ibitlab/pub-shadow-lamp-pierrot/init.md

Step Init:
Треба створити проєкт в OpenSCAD для тіньової лампи з персонажем initial.jpg.
Це має бути «як коробочка», з ліхтарем посередині, на певній висоті.
Світло від ліхтаря має світити в усі боки, крім верху.
«Коробочка» має мати контур його обличчя (біла зона в центрі малюнка) і також включати підмальовані очі.
Згори лампочку й коробку ми закриємо якраз цією зоною обличчя: коли лампочка не світить, ми згори бачимо це обличчя.
Коли лампочка вмикається, вона просвічує крізь фігурні форми в стінках «коробочки» і робить на столі тінь, яка зображатиме всю решту персонажа світлом і тінню.

Відстань між зіницями — 10 см, це для масштабу.

Контур має бути чорною лінією однакової товщини, а тіні очей мають бути на кришці аж до волосся (ліворуч і праворуч).

Step 2:
Чи можемо ми зробити лампу якомога нижчою?

Я переніс усе у версію versions/v001-initial,
створи нову.
