ibitlab/pub-shadow-lamp-pierrot/versions/v001-initial/generated/pierrot_data.scad

// Generated by tools/make_data.py from the drawing. Do not edit by hand;
// rerun the script instead (see README). Units: mm, origin under the LED.

PD_PUPIL_MM = 100;
PD_LAMP_HEIGHT = 150;   // LED height the cleanup was done for
PD_WALL = 2.4;
PD_BASE = 4;
PD_MIN_SOLID = 1.2;
PD_MIN_HOLE = 1;
PD_Z_TOP = 107.6;   // highest hole in the wall
PD_EXTENT = [-219.3,-268.7,224.2,231.6];   // lit area on the table
PD_PUPILS = [[-50.20,-6.61],[49.80,-6.22]];
PD_WIRE = [86.73,-56.44];   // outer wall point of the wire rib
PD_PINS = [[36.84,18.73],[-37.96,24.65],[-2.62,-48.37]];

PD_LID = [[59.98,82.31],[59.73,82.31],[58.98,83.06],[58.73,83.06],[58.23,83.56],[57.98,83.56],[56.98,84.31],[56.48,84.31],[55.73,84.81],[55.23,84.81],[54.98,85.06],[54.73,85.06],[54.48,85.31],[53.98,85.31],[53.23,85.81],[52.73,85.81],[52.48,86.06],[51.73,86.06],[51.23,86.56],[50.98,86.56],[50.73,86.81],[50.23,86.81],[49.23,87.56],[48.48,87.56],[47.23,88.56],[46.73,88.56],[45.73,89.31],[44.23,89.81],[43.73,90.31],[43.23,90.31],[41.98,91.06],[41.48,91.06],[40.98,91.56],[40.23,91.56],[39.73,92.06],[39.23,92.06],[38.98,92.31],[38.23,92.31],[37.73,92.81],[36.98,92.81],[36.48,93.31],[35.73,93.31],[35.48,93.56],[34.98,93.56],[34.73,93.81],[34.23,93.81],[33.98,94.06],[33.48,94.06],[33.23,94.31],[32.48,94.31],[31.98,94.81],[31.23,94.81],[30.98,95.06],[30.48,95.06],[30.23,95.31],[29.73,95.31],[29.48,95.56],[28.48,95.56],[28.23,95.81],[27.48,95.81],[27.23,96.06],[26.73,96.06],[26.48,96.31],[25.73,96.31],[25.48,96.56],[24.98,96.56],[24.73,96.81],[23.73,96.81],[23.48,97.06],[22.98,97.06],[22.73,97.31],[21.48,97.31],[21.23,97.56],[20.23,97.56],[19.98,97.81],[18.98,97.81],[18.73,98.06],[18.23,98.06],[17.98,98.31],[16.98,98.31],[16.73,98.56],[15.23,98.56],[14.98,98.81],[13.98,98.81],[13.73,99.06],[12.73,99.06],[12.48,99.31],[11.73,99.31],[11.48,99.56],[10.48,99.56],[10.23,99.81],[9.73,99.81],[8.98,100.31],[8.23,100.31],[7.98,100.56],[7.48,100.56],[6.73,101.06],[6.23,101.06],[5.48,101.56],[4.98,101.56],[4.73,101.81],[3.98,101.81],[3.73,102.06],[3.23,102.06],[2.98,102.31],[1.73,102.31],[1.48,102.56],[-0.52,102.56],[-0.77,102.31],[-2.27,102.31],[-2.52,102.06],[-3.02,102.06],[-3.27,101.81],[-4.02,101.81],[-4.27,101.56],[-4.77,101.56],[-5.02,101.31],[-5.77,101.31],[-6.02,101.06],[-6.52,101.06],[-6.77,100.81],[-7.52,100.81],[-7.77,100.56],[-8.77,100.56],[-9.02,100.31],[-10.02,100.31],[-10.27,100.06],[-11.27,100.06],[-11.52,99.81],[-13.02,99.81],[-13.27,99.56],[-14.77,99.56],[-15.02,99.31],[-16.52,99.31],[-16.77,99.06],[-17.77,99.06],[-18.02,98.81],[-18.77,98.81],[-19.02,98.56],[-20.02,98.56],[-20.27,98.31],[-20.77,98.31],[-21.02,98.06],[-22.27,98.06],[-22.52,97.81],[-23.02,97.81],[-23.27,97.56],[-23.77,97.56],[-24.02,97.31],[-24.77,97.31],[-25.02,97.06],[-25.52,97.06],[-25.77,96.81],[-26.27,96.81],[-26.52,96.56],[-27.27,96.56],[-27.77,96.06],[-28.52,96.06],[-28.77,95.81],[-30.02,95.56],[-30.77,95.06],[-31.27,95.06],[-32.02,94.56],[-32.52,94.56],[-33.27,94.06],[-33.77,94.06],[-34.52,93.56],[-35.02,93.56],[-35.52,93.06],[-36.27,93.06],[-36.77,92.56],[-37.27,92.56],[-38.52,91.81],[-39.02,91.81],[-39.52,91.31],[-40.02,91.31],[-40.27,91.06],[-41.02,90.81],[-41.52,90.31],[-42.02,90.31],[-43.02,89.56],[-43.52,89.56],[-44.52,88.81],[-44.77,88.81],[-45.52,88.31],[-46.02,88.31],[-47.27,87.31],[-47.52,87.31],[-47.77,87.06],[-48.27,87.06],[-48.77,86.56],[-49.02,86.56],[-49.27,86.31],[-49.77,86.31],[-50.77,85.56],[-51.27,85.56],[-51.52,85.31],[-52.27,85.31],[-52.52,85.06],[-53.02,85.06],[-53.27,84.81],[-54.02,84.81],[-54.27,84.56],[-54.77,84.56],[-55.02,84.31],[-55.77,84.31],[-56.02,84.06],[-56.52,84.06],[-57.27,83.56],[-58.02,83.56],[-58.52,83.06],[-58.77,83.06],[-59.27,82.56],[-59.52,82.56],[-60.02,82.06],[-60.27,82.06],[-61.02,81.31],[-61.02,81.06],[-61.77,80.56],[-61.77,80.31],[-62.27,79.81],[-62.27,79.56],[-63.02,78.56],[-63.02,78.06],[-63.77,76.81],[-63.77,76.06],[-64.52,75.06],[-64.52,74.31],[-65.02,73.56],[-65.02,72.81],[-65.27,72.56],[-65.27,72.06],[-65.52,71.81],[-65.52,71.06],[-65.77,70.81],[-65.77,70.06],[-66.02,69.81],[-66.02,69.06],[-66.27,68.81],[-66.27,68.06],[-66.52,67.81],[-66.52,67.31],[-66.77,67.06],[-66.77,66.31],[-67.02,66.06],[-67.02,64.81],[-67.27,64.56],[-67.27,63.81],[-67.52,63.56],[-67.52,62.56],[-67.77,62.31],[-67.77,61.06],[-68.02,60.81],[-68.02,59.81],[-68.27,59.56],[-68.27,57.81],[-68.52,57.56],[-68.52,56.06],[-68.77,55.81],[-68.77,53.81],[-69.02,53.56],[-69.02,44.06],[-68.77,43.81],[-68.77,41.81],[-68.52,41.56],[-68.52,40.56],[-68.27,40.31],[-68.27,39.06],[-68.02,38.81],[-68.02,37.81],[-67.77,37.56],[-67.77,37.06],[-67.52,36.81],[-67.52,36.06],[-67.27,35.81],[-67.27,35.31],[-67.02,35.06],[-67.02,34.31],[-66.77,34.06],[-66.77,33.56],[-66.52,33.31],[-66.52,32.56],[-66.02,31.81],[-66.02,31.31],[-65.52,30.56],[-65.52,30.06],[-64.77,28.81],[-64.77,28.31],[-64.52,28.06],[-64.27,27.31],[-63.77,26.81],[-63.52,26.06],[-63.02,25.56],[-63.02,25.06],[-62.77,24.81],[-62.52,24.06],[-62.02,23.56],[-62.02,23.06],[-61.27,21.81],[-61.27,21.06],[-61.02,20.81],[-61.02,20.06],[-61.27,19.81],[-61.27,19.31],[-61.52,19.06],[-61.52,18.81],[-62.52,17.81],[-62.77,17.81],[-64.77,16.06],[-65.27,16.06],[-67.02,14.31],[-67.27,14.31],[-67.52,14.06],[-67.52,13.81],[-68.77,12.56],[-68.77,12.31],[-70.52,10.31],[-70.52,9.81],[-71.77,8.31],[-71.77,7.81],[-72.52,6.81],[-72.52,6.31],[-73.02,5.56],[-73.02,5.06],[-73.27,4.81],[-73.27,4.06],[-73.52,3.81],[-73.52,3.31],[-73.77,3.06],[-73.77,2.31],[-74.02,2.06],[-74.02,1.06],[-74.27,0.81],[-74.27,-0.69],[-74.52,-0.94],[-74.52,-2.94],[-74.77,-3.19],[-74.77,-3.94],[-75.02,-4.19],[-75.02,-4.69],[-75.77,-5.44],[-75.77,-5.69],[-76.02,-5.94],[-76.27,-5.94],[-76.77,-6.44],[-77.02,-6.44],[-77.27,-6.69],[-77.52,-6.69],[-80.27,-8.19],[-80.77,-8.19],[-81.02,-8.44],[-81.52,-8.44],[-81.77,-8.69],[-82.27,-8.69],[-82.52,-8.94],[-83.02,-8.94],[-83.27,-9.19],[-83.77,-9.19],[-84.02,-9.44],[-84.52,-9.44],[-84.77,-9.69],[-85.27,-9.69],[-85.52,-9.94],[-86.27,-9.94],[-86.52,-10.19],[-87.02,-10.19],[-88.27,-10.94],[-88.77,-10.94],[-89.02,-11.19],[-89.77,-11.19],[-90.02,-11.44],[-90.52,-11.44],[-91.77,-12.19],[-92.27,-12.19],[-92.52,-12.44],[-93.27,-12.44],[-93.52,-12.69],[-94.02,-12.69],[-95.27,-13.44],[-96.52,-13.69],[-96.77,-13.94],[-98.02,-14.44],[-98.52,-14.94],[-99.27,-15.19],[-99.77,-15.69],[-101.52,-16.44],[-102.52,-17.44],[-102.77,-17.44],[-103.27,-17.94],[-103.52,-17.94],[-104.02,-18.44],[-104.02,-18.69],[-104.52,-19.19],[-104.52,-19.44],[-105.27,-20.19],[-105.27,-20.44],[-105.77,-21.19],[-105.77,-21.94],[-106.02,-22.19],[-106.02,-24.19],[-105.77,-24.44],[-105.77,-25.19],[-105.27,-25.69],[-105.27,-25.94],[-104.52,-26.94],[-104.27,-27.69],[-104.02,-27.94],[-103.77,-27.94],[-103.52,-28.19],[-103.52,-28.44],[-103.27,-28.69],[-103.02,-28.69],[-102.77,-28.94],[-102.77,-29.19],[-102.52,-29.44],[-102.27,-29.44],[-102.02,-29.69],[-102.02,-29.94],[-98.52,-33.44],[-98.27,-33.44],[-97.77,-34.19],[-97.52,-34.19],[-96.27,-35.44],[-96.02,-35.44],[-95.02,-36.44],[-94.77,-36.44],[-94.27,-37.19],[-93.52,-37.44],[-92.52,-38.44],[-91.77,-38.69],[-91.27,-39.19],[-91.02,-39.19],[-90.77,-39.44],[-89.52,-39.94],[-89.02,-40.44],[-87.27,-41.19],[-86.77,-41.94],[-86.52,-41.94],[-85.52,-42.69],[-85.27,-42.69],[-84.02,-44.19],[-84.02,-46.19],[-84.27,-46.44],[-84.27,-47.44],[-85.02,-48.44],[-85.02,-48.69],[-85.27,-48.94],[-85.27,-49.44],[-85.77,-50.19],[-85.77,-50.69],[-86.27,-51.44],[-86.27,-52.44],[-86.52,-52.69],[-86.52,-54.19],[-86.27,-54.44],[-86.27,-55.19],[-86.02,-55.44],[-86.02,-55.94],[-85.77,-56.19],[-85.77,-56.44],[-85.27,-56.94],[-85.27,-57.19],[-84.77,-57.69],[-84.77,-57.94],[-84.27,-58.44],[-84.27,-58.69],[-83.77,-59.19],[-83.77,-59.44],[-82.27,-61.44],[-81.77,-62.94],[-80.77,-64.19],[-80.77,-64.44],[-80.27,-65.19],[-80.27,-65.69],[-79.52,-66.69],[-79.52,-66.94],[-79.02,-67.69],[-79.02,-68.19],[-78.02,-69.69],[-78.02,-70.44],[-77.52,-70.94],[-77.52,-71.19],[-77.02,-71.94],[-77.02,-72.69],[-76.27,-73.69],[-76.27,-74.44],[-76.02,-74.69],[-75.77,-75.44],[-75.02,-76.44],[-75.02,-77.19],[-74.52,-77.69],[-74.27,-78.44],[-73.02,-79.69],[-73.02,-79.94],[-72.52,-80.44],[-72.27,-80.44],[-71.77,-80.94],[-71.02,-81.19],[-70.52,-81.69],[-70.27,-81.69],[-69.52,-82.19],[-68.27,-82.19],[-68.02,-82.44],[-66.52,-82.44],[-66.27,-82.69],[-63.77,-82.69],[-63.52,-82.94],[-61.77,-82.94],[-61.52,-83.19],[-59.77,-83.19],[-59.52,-83.44],[-58.77,-83.44],[-58.52,-83.69],[-57.27,-83.69],[-57.02,-83.94],[-56.02,-83.94],[-55.77,-84.19],[-54.02,-84.19],[-53.77,-84.44],[-53.02,-84.44],[-52.77,-84.19],[-51.27,-84.19],[-51.02,-83.94],[-50.02,-83.94],[-48.77,-83.19],[-48.27,-83.19],[-47.52,-82.69],[-46.27,-82.44],[-45.77,-81.94],[-45.52,-81.94],[-45.27,-81.69],[-45.02,-81.69],[-44.77,-81.44],[-44.52,-81.44],[-41.77,-79.94],[-41.27,-79.94],[-40.02,-79.19],[-39.52,-79.19],[-37.77,-78.19],[-37.02,-78.19],[-36.27,-77.69],[-35.52,-77.69],[-35.27,-77.44],[-34.27,-77.44],[-34.02,-77.19],[-33.02,-77.19],[-32.77,-76.94],[-27.52,-76.94],[-27.27,-77.19],[-26.52,-77.19],[-26.27,-77.44],[-25.52,-77.44],[-25.27,-77.69],[-24.02,-77.94],[-23.27,-78.44],[-22.77,-78.44],[-22.27,-78.94],[-21.77,-78.94],[-21.02,-79.69],[-20.77,-79.69],[-19.77,-80.44],[-19.52,-80.44],[-18.52,-81.44],[-18.27,-81.44],[-17.27,-82.44],[-17.02,-82.44],[-16.27,-83.44],[-16.02,-83.44],[-15.27,-84.19],[-15.02,-84.19],[-13.27,-85.69],[-13.02,-85.69],[-12.77,-85.94],[-12.27,-85.94],[-11.77,-86.44],[-11.27,-86.44],[-11.02,-86.69],[-10.52,-86.69],[-10.27,-86.94],[-9.27,-86.94],[-9.02,-87.19],[-8.27,-87.19],[-8.02,-87.44],[-7.02,-87.44],[-6.77,-87.69],[-5.52,-87.69],[-5.27,-87.94],[-4.52,-87.94],[-4.27,-88.19],[-3.02,-88.19],[-2.77,-88.44],[-0.52,-88.44],[-0.27,-88.69],[8.23,-88.69],[8.48,-88.44],[10.48,-88.44],[10.73,-88.19],[12.98,-88.19],[13.23,-87.94],[14.48,-87.94],[14.73,-87.69],[15.48,-87.69],[15.73,-87.44],[17.23,-87.44],[17.48,-87.19],[17.98,-87.19],[18.23,-86.94],[18.98,-86.94],[19.23,-86.69],[20.48,-86.44],[20.98,-85.94],[21.48,-85.94],[21.73,-85.69],[22.98,-85.19],[23.73,-84.44],[23.98,-84.44],[24.73,-83.69],[24.98,-83.69],[25.73,-82.94],[25.73,-82.69],[26.23,-82.19],[26.48,-82.19],[27.98,-80.44],[28.23,-80.44],[30.98,-77.94],[31.23,-77.94],[31.73,-77.44],[32.23,-77.44],[32.73,-76.94],[33.23,-76.94],[33.98,-76.44],[34.98,-76.44],[35.23,-76.19],[38.98,-76.19],[39.23,-76.44],[40.48,-76.44],[40.73,-76.69],[41.48,-76.69],[41.73,-76.94],[42.48,-76.94],[43.73,-77.69],[44.73,-77.69],[45.48,-78.19],[45.98,-78.19],[46.23,-78.44],[46.98,-78.69],[47.48,-79.19],[47.73,-79.19],[47.98,-79.44],[48.48,-79.44],[49.23,-79.94],[49.73,-79.94],[51.98,-81.19],[53.23,-81.44],[53.98,-81.94],[54.48,-81.94],[54.73,-82.19],[55.23,-82.19],[55.48,-82.44],[56.48,-82.44],[56.73,-82.69],[58.23,-82.69],[58.48,-82.94],[59.23,-82.94],[59.48,-82.69],[61.48,-82.69],[61.73,-82.44],[62.73,-82.44],[62.98,-82.19],[63.73,-82.19],[63.98,-81.94],[64.73,-81.94],[64.98,-81.69],[65.73,-81.69],[65.98,-81.44],[66.73,-81.44],[66.98,-81.19],[67.73,-81.19],[67.98,-80.94],[68.73,-80.94],[68.98,-80.69],[69.73,-80.69],[70.48,-80.19],[70.98,-80.19],[71.23,-79.94],[71.98,-79.69],[72.48,-79.19],[72.73,-79.19],[73.23,-78.69],[73.48,-78.69],[73.73,-78.44],[73.73,-78.19],[74.98,-76.94],[74.98,-76.69],[75.48,-76.19],[75.73,-75.44],[76.23,-74.94],[76.23,-74.69],[76.73,-73.94],[76.73,-73.44],[77.73,-71.69],[77.73,-71.19],[77.98,-70.94],[78.23,-70.19],[78.98,-69.19],[78.98,-68.44],[79.48,-67.94],[79.73,-67.19],[80.23,-66.69],[80.23,-66.19],[80.48,-65.94],[80.73,-65.19],[81.23,-64.69],[81.23,-64.44],[81.73,-63.94],[81.98,-63.19],[82.48,-62.69],[82.48,-62.44],[82.98,-61.94],[82.98,-61.69],[83.48,-61.19],[83.48,-60.94],[83.98,-60.44],[83.98,-60.19],[84.48,-59.69],[84.48,-59.44],[84.98,-58.94],[84.98,-58.69],[85.73,-57.94],[85.73,-57.69],[86.23,-57.19],[86.23,-56.94],[86.73,-56.44],[86.73,-56.19],[87.23,-55.69],[87.23,-55.44],[87.73,-54.69],[87.73,-53.69],[87.98,-53.44],[87.98,-52.69],[87.73,-52.44],[87.73,-51.44],[87.23,-50.69],[86.98,-49.44],[86.73,-49.19],[86.23,-47.94],[85.73,-47.44],[85.73,-46.94],[85.23,-46.19],[85.23,-45.19],[84.98,-44.94],[84.98,-43.69],[85.23,-43.44],[85.23,-43.19],[86.98,-41.44],[87.23,-41.44],[87.48,-41.19],[87.73,-41.19],[87.98,-40.94],[88.23,-40.94],[88.48,-40.69],[88.73,-40.69],[88.98,-40.44],[89.23,-40.44],[89.48,-40.19],[89.73,-40.19],[89.98,-39.94],[90.23,-39.94],[90.48,-39.69],[90.73,-39.69],[90.98,-39.44],[91.23,-39.44],[91.48,-39.19],[93.23,-38.44],[93.73,-37.94],[94.48,-37.69],[95.23,-36.94],[95.98,-36.69],[96.98,-35.69],[97.23,-35.69],[99.48,-33.69],[99.73,-33.69],[104.48,-28.94],[104.48,-28.69],[104.98,-28.19],[105.23,-27.44],[105.73,-26.94],[105.73,-26.69],[106.48,-25.44],[106.48,-24.44],[106.73,-24.19],[106.73,-23.69],[106.48,-23.44],[106.48,-22.69],[105.98,-21.94],[105.98,-21.44],[105.73,-21.19],[105.48,-20.44],[103.48,-18.44],[103.23,-18.44],[102.48,-17.69],[102.23,-17.69],[101.98,-17.44],[101.73,-17.44],[101.48,-17.19],[99.73,-16.44],[99.23,-15.94],[98.98,-15.94],[97.73,-15.19],[96.98,-15.19],[95.23,-14.19],[94.73,-14.19],[93.98,-13.69],[93.48,-13.69],[93.23,-13.44],[92.73,-13.44],[92.48,-13.19],[91.73,-13.19],[91.48,-12.94],[90.98,-12.94],[90.23,-12.44],[88.98,-12.19],[87.73,-11.44],[87.23,-11.44],[86.98,-11.19],[86.23,-11.19],[85.98,-10.94],[85.48,-10.94],[85.23,-10.69],[84.48,-10.69],[82.73,-9.69],[82.23,-9.69],[81.98,-9.44],[80.73,-9.19],[78.98,-8.19],[77.73,-7.94],[76.98,-7.19],[76.73,-7.19],[75.48,-5.94],[75.48,-5.69],[75.23,-5.44],[75.23,-4.19],[74.98,-3.94],[74.98,-0.44],[74.73,-0.19],[74.73,1.56],[74.48,1.81],[74.48,2.81],[74.23,3.06],[74.23,3.81],[73.98,4.06],[73.98,4.81],[73.73,5.06],[73.73,5.56],[73.48,5.81],[73.23,7.06],[72.73,7.56],[72.73,8.06],[71.98,9.06],[71.98,9.56],[71.23,10.31],[71.23,10.56],[69.98,12.06],[69.98,12.31],[67.98,14.31],[67.73,14.31],[66.48,15.56],[66.23,15.56],[64.73,16.81],[64.23,16.81],[62.73,18.06],[62.23,18.06],[60.98,19.56],[60.98,21.31],[61.23,21.56],[61.48,22.81],[61.98,23.56],[61.98,24.06],[62.48,24.56],[62.73,25.31],[63.23,25.81],[63.48,26.56],[63.98,27.06],[64.23,27.81],[64.98,28.81],[64.98,29.56],[65.48,30.06],[65.48,30.31],[65.73,30.56],[65.73,31.31],[66.23,31.81],[66.23,32.56],[66.48,32.81],[66.48,33.31],[66.98,34.06],[66.98,34.81],[67.23,35.06],[67.23,35.56],[67.48,35.81],[67.48,36.56],[67.73,36.81],[67.73,37.81],[67.98,38.06],[67.98,39.06],[68.23,39.31],[68.23,40.31],[68.48,40.56],[68.48,42.31],[68.73,42.56],[68.73,53.06],[68.48,53.31],[68.48,55.31],[68.23,55.56],[68.23,57.06],[67.98,57.31],[67.98,59.06],[67.73,59.31],[67.73,60.31],[67.48,60.56],[67.48,61.81],[67.23,62.06],[67.23,63.06],[66.98,63.31],[66.98,64.56],[66.73,64.81],[66.73,66.06],[66.48,66.31],[66.48,67.06],[66.23,67.31],[66.23,68.56],[65.98,68.81],[65.98,69.31],[65.73,69.56],[65.73,70.31],[65.48,70.56],[65.48,71.31],[65.23,71.56],[65.23,72.31],[64.98,72.56],[64.98,73.31],[64.48,74.06],[64.48,74.81],[63.98,75.56],[63.98,76.06],[63.23,77.31],[63.23,77.81],[62.98,78.06],[62.48,79.31],[61.98,79.81],[61.98,80.06],[61.48,80.56],[61.48,80.81],[61.23,81.06],[60.98,81.06]];

PD_INK_POINTS = [[-51.27,-0.19],[-51.52,-0.44],[-52.52,-0.69],[-53.27,-1.44],[-53.52,-1.44],[-54.02,-1.94],[-55.02,-3.94],[-55.02,-4.44],[-55.27,-4.69],[-55.27,-8.44],[-54.77,-9.19],[-54.77,-9.94],[-52.77,-12.44],[-52.27,-12.44],[-51.77,-12.94],[-51.27,-12.94],[-51.02,-13.19],[-49.02,-13.19],[-47.52,-12.44],[-46.27,-11.19],[-46.02,-10.44],[-45.52,-9.94],[-45.52,-9.19],[-45.02,-8.19],[-45.02,-5.19],[-45.52,-4.44],[-45.52,-3.69],[-46.02,-2.69],[-47.02,-1.44],[-47.27,-1.44],[-48.52,-0.44],[-49.27,-0.44],[-49.52,-0.19],[48.48,0.06],[47.98,-0.44],[47.48,-0.44],[45.73,-2.19],[45.73,-2.69],[45.23,-3.19],[45.23,-3.69],[44.98,-3.94],[44.98,-4.94],[44.73,-5.19],[44.73,-7.69],[44.98,-7.94],[44.98,-8.69],[45.23,-8.94],[45.23,-9.44],[45.73,-10.44],[47.23,-11.94],[47.48,-11.94],[47.98,-12.44],[48.73,-12.44],[48.98,-12.69],[50.73,-12.69],[52.73,-11.69],[54.23,-9.94],[54.23,-9.44],[54.73,-8.69],[54.73,-7.94],[54.98,-7.69],[54.98,-4.69],[54.73,-4.44],[54.73,-3.69],[54.23,-2.94],[54.23,-2.44],[52.23,-0.44],[51.23,0.06],[59.98,82.31],[59.73,82.31],[58.98,83.06],[58.73,83.06],[57.48,84.06],[56.48,84.31],[55.73,84.81],[55.23,84.81],[53.73,85.56],[53.48,85.31],[53.98,84.56],[53.48,84.06],[51.73,85.56],[51.48,85.56],[48.73,87.56],[47.98,87.81],[47.48,88.31],[46.23,88.81],[45.73,89.31],[44.73,89.56],[41.98,91.06],[40.73,91.31],[39.98,91.81],[39.48,91.81],[38.73,92.31],[38.23,92.31],[37.48,92.81],[36.98,92.81],[36.23,93.31],[34.73,93.56],[33.98,94.06],[32.48,94.31],[31.73,94.81],[30.98,94.81],[30.73,95.06],[29.23,95.31],[28.23,95.81],[27.48,95.81],[27.23,96.06],[26.48,96.06],[25.48,96.56],[24.48,96.56],[23.48,97.06],[22.48,97.06],[22.23,97.31],[21.48,97.31],[21.23,97.56],[19.98,97.56],[19.73,97.81],[18.98,97.81],[17.98,98.31],[15.98,98.31],[14.98,98.81],[12.98,98.81],[11.98,99.31],[9.73,99.31],[9.48,99.56],[5.98,99.56],[5.73,99.81],[5.73,100.56],[5.98,101.06],[5.48,101.56],[3.98,101.81],[2.98,102.31],[1.73,102.31],[1.48,102.56],[1.23,102.31],[1.23,101.56],[0.73,101.31],[0.48,101.56],[0.48,102.06],[-0.02,102.56],[-0.52,102.56],[-0.77,102.31],[-2.27,102.31],[-3.27,101.81],[-4.77,101.56],[-5.02,101.31],[-5.02,100.81],[-4.52,100.31],[-4.77,100.06],[-11.02,100.06],[-11.27,99.81],[-13.02,99.81],[-13.27,99.56],[-16.52,99.31],[-16.77,99.06],[-17.77,99.06],[-18.02,98.81],[-18.77,98.81],[-19.02,98.56],[-20.02,98.56],[-21.02,98.06],[-22.27,98.06],[-22.52,97.81],[-23.02,97.81],[-24.02,97.31],[-24.77,97.31],[-25.02,97.06],[-27.02,96.56],[-27.77,96.06],[-29.27,95.81],[-30.02,95.31],[-31.27,95.06],[-32.02,94.56],[-32.52,94.56],[-33.27,94.06],[-33.77,94.06],[-34.52,93.56],[-35.02,93.56],[-35.52,93.06],[-36.27,93.06],[-36.77,92.56],[-37.27,92.56],[-38.52,91.81],[-39.02,91.81],[-39.52,91.31],[-40.02,91.31],[-41.02,90.81],[-41.52,90.31],[-42.02,90.31],[-43.02,89.56],[-44.02,89.31],[-44.52,88.81],[-46.77,87.81],[-48.52,86.56],[-49.02,86.56],[-49.52,86.06],[-51.02,85.31],[-54.52,82.81],[-54.77,83.06],[-54.77,83.81],[-54.52,84.06],[-54.77,84.56],[-55.02,84.31],[-56.52,84.06],[-57.27,83.56],[-58.02,83.56],[-58.52,83.06],[-60.27,82.06],[-61.02,81.31],[-61.02,81.06],[-61.77,80.56],[-61.77,80.31],[-63.02,78.56],[-63.02,78.06],[-63.77,76.81],[-63.77,76.06],[-64.52,74.81],[-64.52,74.31],[-64.77,74.06],[-64.77,73.56],[-65.27,72.56],[-65.27,71.81],[-65.77,70.81],[-65.77,70.06],[-66.02,69.81],[-66.02,69.06],[-66.27,68.81],[-66.27,68.06],[-66.52,67.81],[-66.52,67.06],[-66.77,66.81],[-66.77,66.06],[-67.02,65.81],[-67.02,64.81],[-67.27,64.56],[-67.27,63.56],[-67.52,63.31],[-67.52,61.81],[-68.02,60.81],[-68.02,59.06],[-68.27,58.81],[-68.27,57.56],[-68.52,57.31],[-68.52,56.06],[-68.77,55.81],[-68.77,53.81],[-69.02,53.56],[-69.02,44.56],[-68.77,44.31],[-68.77,41.81],[-68.52,41.56],[-68.52,40.56],[-68.27,40.31],[-68.02,37.81],[-67.52,36.81],[-67.52,36.06],[-67.02,35.06],[-67.02,34.31],[-66.77,34.06],[-66.77,33.56],[-66.52,33.31],[-66.02,31.31],[-65.52,30.56],[-65.52,30.06],[-64.77,28.81],[-64.77,28.31],[-64.27,27.31],[-63.77,26.81],[-62.77,24.81],[-62.27,24.31],[-61.77,23.31],[-61.02,22.56],[-60.52,21.56],[-58.02,19.06],[-57.77,19.06],[-56.77,18.06],[-56.52,18.06],[-55.77,17.31],[-55.52,17.31],[-55.27,16.81],[-55.52,16.56],[-57.77,16.56],[-58.02,16.81],[-59.02,16.81],[-59.27,17.06],[-61.02,17.06],[-61.27,17.31],[-63.02,17.56],[-64.77,16.06],[-65.27,16.06],[-67.02,14.31],[-67.52,14.06],[-67.52,13.81],[-69.77,11.31],[-69.77,11.06],[-70.52,10.31],[-70.52,9.81],[-71.77,8.31],[-72.02,7.31],[-72.52,6.81],[-72.52,6.31],[-73.02,5.56],[-73.27,4.06],[-73.77,3.06],[-73.77,2.31],[-74.02,2.06],[-74.77,-3.94],[-75.02,-4.19],[-75.02,-4.69],[-76.02,-5.94],[-80.27,-8.19],[-80.77,-8.19],[-81.02,-8.44],[-81.52,-8.44],[-81.77,-8.69],[-82.27,-8.69],[-82.52,-8.94],[-83.02,-8.94],[-83.27,-9.19],[-83.77,-9.19],[-84.02,-9.44],[-84.52,-9.44],[-85.52,-9.94],[-87.02,-10.19],[-88.27,-10.94],[-89.77,-11.19],[-91.77,-12.19],[-94.02,-12.69],[-95.27,-13.44],[-96.52,-13.69],[-98.02,-14.44],[-99.77,-15.69],[-101.52,-16.44],[-102.52,-17.44],[-103.52,-17.94],[-104.02,-18.44],[-104.52,-19.44],[-105.27,-20.19],[-105.77,-21.19],[-105.77,-21.94],[-106.02,-22.19],[-106.02,-24.19],[-105.77,-24.44],[-105.77,-25.19],[-105.27,-25.69],[-104.52,-27.19],[-104.02,-27.44],[-102.02,-29.44],[-102.02,-29.69],[-99.77,-31.94],[-99.77,-32.19],[-98.52,-33.44],[-98.02,-33.69],[-97.77,-34.19],[-97.52,-34.19],[-96.27,-35.44],[-96.02,-35.44],[-95.02,-36.44],[-94.77,-36.44],[-94.27,-37.19],[-93.52,-37.44],[-92.52,-38.44],[-91.77,-38.69],[-91.27,-39.19],[-89.52,-39.94],[-89.02,-40.44],[-87.27,-41.19],[-86.77,-41.69],[-85.77,-42.19],[-85.27,-42.19],[-84.52,-42.69],[-83.77,-42.69],[-83.52,-42.94],[-83.02,-42.94],[-82.02,-43.44],[-81.27,-43.44],[-80.52,-43.94],[-78.77,-43.94],[-78.52,-44.19],[-78.02,-44.19],[-77.52,-44.69],[-77.52,-44.94],[-78.02,-45.44],[-78.27,-45.44],[-80.02,-46.94],[-80.77,-47.19],[-81.27,-47.69],[-83.77,-48.94],[-85.02,-49.19],[-85.52,-49.69],[-85.77,-50.69],[-86.27,-51.44],[-86.27,-52.44],[-86.52,-52.69],[-86.52,-54.19],[-86.27,-54.44],[-86.27,-55.19],[-85.02,-56.44],[-84.27,-57.94],[-83.77,-58.44],[-83.27,-59.69],[-82.77,-60.19],[-78.02,-69.69],[-77.52,-70.19],[-77.52,-70.69],[-76.77,-71.94],[-76.77,-72.69],[-76.27,-73.19],[-76.27,-73.69],[-75.77,-74.44],[-75.77,-75.19],[-75.02,-76.44],[-75.02,-77.19],[-74.52,-77.69],[-74.27,-78.44],[-72.52,-80.44],[-72.27,-80.44],[-71.77,-80.94],[-71.02,-81.19],[-70.52,-81.69],[-69.52,-82.19],[-66.52,-82.44],[-66.27,-82.69],[-63.77,-82.69],[-63.52,-82.94],[-61.77,-82.94],[-61.52,-83.19],[-59.77,-83.19],[-59.52,-83.44],[-58.77,-83.44],[-58.52,-83.69],[-57.27,-83.69],[-57.02,-83.94],[-56.02,-83.94],[-55.77,-84.19],[-54.02,-84.19],[-53.77,-84.44],[-53.02,-84.44],[-52.77,-84.19],[-51.27,-84.19],[-51.02,-83.94],[-50.02,-83.94],[-48.77,-83.19],[-48.27,-83.19],[-47.52,-82.69],[-47.02,-82.69],[-44.52,-80.69],[-44.02,-80.69],[-42.27,-79.44],[-41.77,-79.44],[-41.02,-78.94],[-40.52,-78.94],[-38.52,-77.94],[-37.02,-77.69],[-36.02,-77.19],[-35.02,-77.19],[-34.02,-76.69],[-31.02,-76.44],[-30.77,-76.19],[-29.02,-76.19],[-28.77,-76.44],[-26.27,-76.69],[-25.52,-77.19],[-24.77,-77.19],[-23.52,-77.94],[-23.02,-77.94],[-22.52,-78.44],[-22.02,-78.44],[-21.52,-78.94],[-20.77,-79.19],[-20.27,-79.69],[-19.27,-80.19],[-18.52,-80.94],[-18.27,-80.94],[-15.27,-84.19],[-15.02,-84.19],[-13.27,-85.69],[-12.27,-85.94],[-11.77,-86.44],[-11.27,-86.44],[-10.27,-86.94],[-9.27,-86.94],[-9.02,-87.19],[-8.77,-86.94],[-9.02,-86.44],[-8.77,-86.19],[-8.27,-86.19],[-7.27,-86.69],[-6.02,-87.69],[-4.52,-87.94],[-4.27,-88.19],[-3.02,-88.19],[-2.77,-88.44],[-0.52,-88.44],[-0.27,-88.69],[8.23,-88.69],[8.48,-88.44],[12.98,-88.19],[13.23,-87.94],[14.48,-87.94],[14.73,-87.69],[15.48,-87.69],[15.73,-87.44],[17.23,-87.44],[18.23,-86.94],[18.98,-86.94],[19.23,-86.69],[20.48,-86.44],[20.98,-85.94],[21.48,-85.94],[22.98,-85.19],[25.73,-82.94],[25.73,-82.69],[26.73,-81.69],[27.23,-80.69],[29.98,-77.94],[30.23,-77.94],[31.73,-76.69],[33.23,-75.94],[33.73,-75.94],[34.48,-75.44],[37.98,-75.44],[38.23,-75.69],[38.98,-75.69],[39.23,-75.94],[40.48,-75.94],[40.73,-76.19],[41.23,-76.19],[42.23,-76.69],[42.98,-76.69],[43.73,-77.19],[44.48,-77.19],[46.98,-78.44],[47.48,-78.44],[49.98,-79.69],[50.48,-80.19],[50.98,-80.19],[52.73,-81.44],[53.23,-81.44],[53.98,-81.94],[54.48,-81.94],[55.48,-82.44],[56.48,-82.44],[56.73,-82.69],[58.23,-82.69],[58.48,-82.94],[59.23,-82.94],[59.48,-82.69],[61.48,-82.69],[61.73,-82.44],[62.73,-82.44],[62.98,-82.19],[63.73,-82.19],[63.98,-81.94],[64.73,-81.94],[64.98,-81.69],[65.73,-81.69],[65.98,-81.44],[66.73,-81.44],[66.98,-81.19],[67.73,-81.19],[67.98,-80.94],[69.73,-80.69],[70.48,-80.19],[70.98,-80.19],[71.98,-79.69],[72.48,-79.19],[73.48,-78.69],[73.73,-78.19],[74.98,-76.94],[74.98,-76.69],[75.48,-76.19],[75.73,-75.44],[76.48,-74.44],[76.48,-73.94],[76.98,-73.19],[76.98,-72.44],[77.48,-71.94],[77.48,-71.44],[78.73,-69.19],[78.73,-68.69],[79.23,-68.19],[79.23,-67.69],[79.73,-67.19],[80.48,-65.44],[80.98,-64.94],[80.98,-64.44],[81.48,-63.94],[81.73,-63.19],[82.23,-62.69],[82.73,-61.44],[83.73,-60.19],[83.98,-59.44],[85.98,-57.19],[85.98,-56.94],[87.23,-55.69],[87.73,-54.69],[87.73,-53.69],[87.98,-53.44],[87.73,-51.44],[87.23,-50.69],[87.23,-50.19],[86.98,-49.94],[86.73,-48.94],[85.98,-48.19],[85.48,-48.19],[84.98,-47.69],[84.23,-47.69],[83.73,-47.19],[82.73,-46.94],[81.48,-45.94],[80.23,-45.44],[79.48,-44.69],[78.48,-44.19],[77.73,-43.19],[77.98,-42.94],[82.23,-42.69],[83.23,-42.19],[84.48,-42.19],[85.23,-41.69],[86.23,-41.69],[86.48,-41.44],[87.73,-41.19],[93.23,-38.44],[93.73,-37.94],[94.48,-37.69],[95.23,-36.94],[95.98,-36.69],[96.98,-35.69],[97.23,-35.69],[98.23,-34.69],[98.48,-34.69],[99.73,-33.44],[99.98,-33.44],[104.23,-29.19],[104.23,-28.94],[104.98,-28.19],[105.23,-27.44],[105.73,-26.94],[106.48,-25.44],[106.48,-24.44],[106.73,-24.19],[106.73,-23.69],[106.48,-23.44],[106.48,-22.69],[105.98,-21.94],[105.98,-21.44],[105.48,-20.44],[102.48,-17.69],[99.73,-16.44],[99.23,-15.94],[97.73,-15.19],[96.98,-15.19],[95.23,-14.19],[94.73,-14.19],[93.98,-13.69],[93.48,-13.69],[92.48,-13.19],[90.98,-12.94],[90.23,-12.44],[88.98,-12.19],[87.73,-11.44],[86.23,-11.19],[85.23,-10.69],[84.48,-10.69],[82.73,-9.69],[80.73,-9.19],[78.98,-8.19],[77.73,-7.94],[76.98,-7.19],[76.73,-7.19],[75.48,-5.94],[75.23,-5.44],[75.23,-4.19],[74.98,-3.94],[74.98,-0.44],[74.73,-0.19],[74.73,1.56],[74.48,1.81],[74.48,2.81],[74.23,3.06],[74.23,3.81],[73.98,4.06],[73.98,4.81],[73.73,5.06],[73.23,7.06],[72.73,7.56],[72.73,8.06],[71.98,9.06],[71.98,9.56],[71.23,10.31],[71.23,10.56],[69.98,12.06],[69.98,12.31],[66.48,15.56],[66.23,15.56],[64.73,16.81],[64.23,16.81],[63.23,17.56],[61.48,17.56],[61.23,17.31],[60.23,17.31],[59.98,17.06],[55.48,17.06],[55.23,17.31],[55.23,17.56],[55.73,18.06],[56.73,18.56],[57.98,19.81],[58.23,19.81],[60.48,22.06],[60.48,22.31],[61.73,23.56],[61.73,23.81],[63.23,25.81],[63.48,26.56],[63.98,27.06],[64.23,27.81],[64.73,28.31],[64.98,28.81],[64.98,29.56],[65.48,30.06],[65.73,30.56],[65.73,31.31],[66.23,31.81],[66.23,32.56],[66.98,34.06],[66.98,34.81],[67.48,35.81],[67.73,37.81],[67.98,38.06],[67.98,39.06],[68.23,39.31],[68.23,40.31],[68.48,40.56],[68.48,42.31],[68.73,42.56],[68.73,53.06],[68.48,53.31],[68.48,54.56],[68.23,54.81],[68.23,57.06],[67.98,57.31],[67.98,58.31],[67.73,58.56],[67.73,60.06],[67.48,60.31],[67.48,61.56],[67.23,61.81],[67.23,62.81],[66.98,63.06],[66.98,64.56],[66.73,64.81],[66.73,65.56],[66.48,65.81],[66.23,68.31],[65.98,68.56],[65.98,69.31],[65.73,69.56],[65.73,70.31],[65.48,70.56],[65.48,71.31],[65.23,71.56],[64.98,73.31],[64.48,74.06],[64.48,74.81],[63.23,77.31],[63.23,77.81],[62.48,79.31],[61.48,80.56],[61.48,80.81],[60.98,81.06],[-58.02,9.81],[-56.77,9.81],[-55.77,10.31],[-53.27,10.31],[-53.02,10.06],[-50.77,9.81],[-50.02,9.31],[-48.77,9.06],[-48.27,8.56],[-47.02,8.06],[-46.27,7.31],[-46.02,7.31],[-43.02,4.31],[-43.02,4.06],[-41.77,2.56],[-41.27,1.31],[-40.77,0.81],[-40.77,0.31],[-40.02,-0.69],[-40.02,-1.19],[-39.52,-1.94],[-39.52,-2.69],[-39.02,-3.69],[-39.02,-4.44],[-38.77,-4.69],[-38.77,-5.44],[-38.52,-5.69],[-38.52,-6.44],[-38.27,-6.69],[-38.27,-8.44],[-38.02,-8.69],[-38.02,-12.94],[-38.27,-13.19],[-38.27,-14.44],[-38.77,-15.19],[-38.77,-15.94],[-39.52,-16.94],[-39.52,-17.44],[-40.02,-17.94],[-40.52,-18.94],[-42.77,-20.94],[-45.77,-22.44],[-47.27,-22.69],[-48.02,-23.19],[-50.02,-23.19],[-50.27,-23.44],[-51.77,-23.44],[-52.02,-23.19],[-54.02,-23.19],[-54.77,-22.69],[-56.02,-22.44],[-56.52,-21.94],[-57.02,-21.94],[-58.52,-20.69],[-58.77,-20.69],[-61.77,-17.69],[-61.77,-17.44],[-62.52,-16.69],[-62.52,-16.44],[-63.52,-15.19],[-64.77,-12.69],[-64.77,-12.19],[-65.02,-11.94],[-65.02,-11.44],[-65.52,-10.44],[-65.52,-9.69],[-66.02,-8.69],[-66.02,-7.19],[-66.27,-6.94],[-66.27,-5.44],[-66.52,-5.19],[-66.52,-0.94],[-66.27,-0.69],[-66.27,0.06],[-66.02,0.31],[-66.02,1.56],[-65.77,1.81],[-65.52,3.06],[-64.77,4.56],[-63.77,5.81],[-63.77,6.06],[-62.52,7.31],[-62.27,7.31],[-61.52,8.06],[-61.27,8.06],[-60.02,9.06],[-59.52,9.06],[58.73,10.31],[59.23,9.81],[59.98,9.81],[60.48,9.31],[61.73,8.81],[62.48,8.06],[63.48,7.56],[65.48,5.06],[65.48,4.56],[66.48,2.56],[66.48,1.81],[66.73,1.56],[66.73,-0.19],[66.98,-0.44],[66.98,-4.69],[66.73,-4.94],[66.73,-7.19],[66.23,-8.19],[66.23,-9.19],[65.48,-10.69],[65.48,-11.44],[64.98,-12.19],[64.98,-12.69],[64.48,-13.19],[64.48,-13.69],[63.23,-15.44],[62.98,-16.19],[61.48,-17.94],[61.48,-18.19],[58.73,-20.69],[55.48,-22.44],[54.98,-22.44],[54.73,-22.69],[53.48,-22.69],[52.48,-23.19],[49.73,-23.19],[49.48,-22.94],[48.73,-22.94],[48.48,-22.69],[47.48,-22.69],[45.98,-21.94],[45.23,-21.94],[44.73,-21.44],[44.23,-21.44],[43.73,-20.94],[42.98,-20.69],[41.23,-19.19],[40.98,-19.19],[39.48,-17.44],[39.48,-17.19],[38.48,-15.94],[38.48,-15.19],[37.98,-14.69],[37.98,-13.69],[37.73,-13.44],[37.73,-11.94],[37.48,-11.69],[37.48,-8.94],[37.73,-8.69],[37.73,-6.94],[37.98,-6.69],[37.98,-5.44],[38.23,-5.19],[38.48,-3.44],[38.98,-2.69],[38.98,-1.94],[39.48,-1.19],[39.48,-0.69],[40.98,2.31],[41.48,2.81],[42.48,4.56],[45.23,7.31],[45.48,7.31],[46.23,8.06],[46.48,8.06],[47.48,9.06],[48.98,9.81],[49.48,9.81],[50.23,10.31],[51.23,10.31],[51.48,10.56],[52.23,10.56],[52.48,10.81],[55.98,10.81],[56.23,10.56],[57.23,10.56],[57.48,10.31],[53.73,77.56],[57.23,74.31],[57.23,74.06],[57.98,73.31],[58.48,72.31],[58.48,71.56],[58.98,70.81],[59.23,69.31],[59.73,68.31],[59.73,67.31],[60.23,66.31],[60.23,65.31],[60.73,64.31],[60.98,61.81],[61.48,60.81],[61.48,59.06],[61.73,58.81],[61.73,57.81],[61.98,57.56],[61.98,56.06],[62.23,55.81],[62.23,54.31],[62.48,54.06],[62.48,52.31],[62.73,52.06],[62.73,44.56],[62.48,44.31],[62.48,42.56],[62.23,42.31],[62.23,41.06],[61.98,40.81],[61.98,39.31],[61.48,38.31],[61.48,37.31],[60.98,36.31],[60.98,35.56],[60.23,34.06],[60.23,33.31],[59.73,32.81],[59.73,32.31],[59.23,31.56],[59.23,31.06],[58.48,29.56],[57.23,28.31],[54.73,28.06],[53.73,27.56],[52.73,27.56],[51.73,27.06],[50.98,27.06],[50.23,26.56],[49.73,26.56],[49.48,26.31],[47.48,25.81],[45.73,24.81],[44.48,24.56],[43.98,24.06],[43.48,24.06],[42.98,23.56],[42.48,23.56],[41.98,23.06],[40.73,22.56],[39.98,21.81],[39.48,21.81],[37.98,20.56],[37.73,20.56],[36.23,19.31],[35.98,19.31],[31.23,14.56],[31.23,14.31],[30.48,13.56],[30.48,13.31],[28.98,11.31],[28.73,10.56],[28.23,10.06],[27.48,8.31],[26.98,7.81],[26.98,7.31],[26.48,6.81],[26.48,6.31],[25.98,5.81],[25.98,5.31],[24.73,2.81],[24.73,2.31],[24.48,2.06],[23.98,0.06],[23.48,-0.69],[23.48,-1.44],[22.98,-2.19],[22.98,-3.19],[22.48,-3.94],[22.48,-4.94],[22.23,-5.19],[22.23,-5.69],[21.73,-6.69],[21.73,-8.19],[21.23,-9.19],[21.23,-10.44],[20.98,-10.69],[20.98,-11.44],[20.73,-11.69],[20.73,-13.19],[20.48,-13.44],[20.48,-14.94],[20.23,-15.19],[20.23,-16.19],[19.98,-16.44],[19.98,-22.69],[20.23,-22.94],[20.73,-24.94],[21.23,-25.44],[21.23,-25.69],[21.98,-26.44],[22.48,-26.44],[22.98,-26.94],[23.73,-26.94],[24.48,-27.44],[25.23,-27.44],[25.48,-27.69],[26.98,-27.69],[27.23,-27.94],[27.98,-27.94],[28.23,-28.19],[29.98,-28.19],[30.98,-28.69],[31.98,-28.69],[32.23,-28.94],[34.23,-29.19],[34.48,-29.44],[35.73,-29.44],[36.73,-29.94],[37.98,-29.94],[38.98,-30.44],[40.23,-30.44],[40.48,-30.69],[41.23,-30.69],[41.48,-30.94],[42.23,-30.94],[42.48,-31.19],[43.48,-31.19],[43.73,-31.44],[44.73,-31.44],[44.98,-31.69],[46.23,-31.69],[46.48,-31.94],[47.23,-31.94],[47.48,-32.19],[49.23,-32.19],[49.48,-32.44],[51.98,-32.69],[52.23,-32.94],[53.98,-32.94],[54.23,-33.19],[55.23,-33.19],[55.48,-33.44],[58.48,-33.44],[58.73,-33.69],[59.48,-33.69],[59.98,-33.94],[60.48,-34.94],[60.48,-36.44],[60.73,-36.69],[60.73,-42.44],[60.48,-42.69],[60.23,-47.19],[59.98,-47.44],[59.98,-48.19],[59.73,-48.44],[59.73,-49.94],[59.48,-50.19],[59.48,-50.94],[59.23,-51.19],[59.23,-52.44],[58.98,-52.69],[58.98,-53.69],[58.73,-53.94],[58.48,-55.94],[58.23,-56.19],[58.23,-56.69],[58.73,-57.19],[59.73,-56.69],[60.73,-55.69],[60.98,-55.69],[61.23,-55.19],[62.48,-53.94],[62.48,-53.69],[63.98,-51.69],[64.73,-50.19],[64.73,-49.69],[65.23,-49.19],[65.23,-48.69],[65.73,-47.94],[65.73,-47.44],[65.98,-47.19],[65.98,-46.69],[66.48,-45.69],[66.48,-44.94],[66.98,-44.19],[66.98,-43.44],[67.48,-42.44],[67.73,-40.69],[68.23,-39.69],[68.23,-38.69],[68.73,-37.94],[68.73,-36.94],[68.98,-36.69],[69.23,-34.44],[69.98,-33.69],[70.48,-33.69],[70.73,-33.44],[72.73,-33.44],[73.48,-32.94],[74.48,-32.94],[74.73,-32.69],[75.48,-32.69],[76.48,-32.19],[77.23,-32.19],[77.98,-31.69],[78.98,-31.69],[79.48,-31.19],[79.98,-31.19],[81.48,-30.44],[81.98,-30.44],[82.73,-29.94],[83.23,-29.94],[83.73,-29.44],[84.23,-29.44],[85.23,-28.69],[86.23,-28.19],[86.73,-28.19],[87.48,-27.44],[89.23,-26.44],[91.23,-24.69],[91.48,-24.69],[95.23,-20.69],[95.98,-20.69],[96.98,-21.69],[97.23,-21.69],[97.98,-22.44],[98.23,-22.44],[99.73,-23.69],[99.98,-23.69],[100.23,-23.94],[100.23,-24.69],[99.48,-25.44],[99.48,-25.69],[98.98,-25.94],[98.73,-26.44],[97.23,-27.94],[96.98,-27.94],[95.48,-29.44],[95.23,-29.44],[93.48,-30.94],[93.23,-30.94],[90.48,-32.94],[89.73,-33.19],[89.23,-33.69],[88.73,-33.69],[88.23,-34.19],[87.73,-34.19],[85.48,-35.44],[84.98,-35.44],[83.98,-35.94],[83.23,-35.94],[82.98,-36.19],[82.23,-36.19],[81.98,-36.44],[80.98,-36.44],[80.73,-36.69],[79.73,-36.69],[78.73,-37.19],[76.98,-37.19],[76.73,-37.44],[75.98,-37.44],[75.73,-37.69],[74.48,-37.69],[74.23,-37.94],[70.73,-38.19],[69.98,-38.94],[69.73,-39.69],[69.98,-39.94],[70.23,-41.44],[70.73,-41.94],[70.73,-42.44],[71.23,-42.94],[71.48,-43.69],[71.98,-44.19],[72.48,-45.19],[74.23,-46.94],[74.23,-47.19],[77.73,-50.19],[83.23,-52.94],[83.23,-53.19],[81.23,-55.19],[81.23,-55.44],[80.23,-56.44],[80.23,-56.69],[78.98,-57.94],[78.23,-59.44],[77.73,-59.94],[77.23,-61.19],[76.73,-61.69],[76.73,-62.19],[75.98,-63.19],[75.98,-63.69],[75.48,-64.19],[75.48,-64.69],[74.98,-65.19],[74.98,-65.69],[74.23,-66.94],[74.23,-67.44],[73.23,-69.44],[73.23,-69.94],[72.48,-71.44],[72.48,-71.94],[71.48,-72.94],[71.23,-72.69],[70.48,-72.69],[69.73,-72.19],[66.23,-72.19],[65.23,-72.69],[63.73,-72.94],[62.98,-73.44],[62.48,-73.44],[61.73,-73.94],[61.23,-73.94],[60.73,-74.44],[59.48,-74.69],[58.73,-75.19],[58.23,-75.19],[57.73,-75.69],[56.98,-75.69],[54.98,-76.69],[54.48,-76.69],[54.23,-76.94],[52.98,-76.94],[52.48,-76.44],[51.48,-76.19],[50.98,-75.69],[50.48,-75.69],[49.73,-75.19],[49.23,-75.19],[47.98,-74.44],[47.48,-74.44],[45.48,-73.44],[44.73,-73.44],[44.48,-73.19],[42.98,-72.94],[42.73,-72.69],[41.73,-72.69],[40.73,-72.19],[39.48,-72.19],[38.48,-71.69],[37.23,-71.69],[36.98,-71.44],[34.48,-71.44],[34.23,-71.69],[33.48,-71.69],[32.73,-72.19],[32.23,-72.19],[31.73,-72.69],[31.23,-72.69],[30.73,-73.19],[29.23,-73.94],[25.98,-76.69],[24.98,-76.94],[24.73,-77.19],[23.73,-77.19],[23.48,-77.44],[21.98,-77.44],[21.23,-77.94],[20.48,-77.94],[19.73,-78.44],[18.23,-78.69],[17.48,-79.19],[15.98,-79.19],[15.73,-79.44],[14.23,-79.69],[13.98,-79.94],[12.48,-79.94],[12.23,-80.19],[10.98,-80.19],[10.73,-80.44],[7.73,-80.44],[7.48,-80.69],[3.23,-80.69],[2.98,-80.94],[1.98,-80.94],[1.73,-80.69],[-2.02,-80.69],[-2.27,-80.44],[-5.52,-80.44],[-5.77,-80.19],[-7.27,-80.19],[-7.52,-79.94],[-8.52,-79.94],[-8.77,-79.69],[-10.27,-79.69],[-10.52,-79.44],[-11.27,-79.44],[-11.52,-79.19],[-12.77,-79.19],[-13.52,-78.69],[-14.27,-78.69],[-15.02,-78.19],[-15.52,-78.19],[-16.02,-77.69],[-21.02,-75.19],[-21.52,-75.19],[-23.77,-73.94],[-24.27,-73.94],[-25.52,-73.19],[-26.02,-73.19],[-26.27,-72.94],[-26.77,-72.94],[-27.02,-72.69],[-27.52,-72.69],[-28.52,-72.19],[-29.27,-72.19],[-30.02,-71.69],[-34.02,-71.69],[-35.02,-72.19],[-36.27,-72.19],[-37.02,-72.69],[-37.77,-72.69],[-38.52,-73.19],[-39.77,-73.44],[-40.52,-73.94],[-41.02,-73.94],[-43.52,-75.19],[-44.02,-75.69],[-46.52,-76.94],[-48.02,-78.19],[-48.52,-78.19],[-48.77,-78.44],[-49.52,-77.94],[-50.02,-77.94],[-50.52,-77.44],[-51.02,-77.44],[-51.77,-76.94],[-53.02,-76.69],[-53.77,-76.19],[-54.52,-76.19],[-55.52,-75.69],[-56.52,-75.69],[-57.27,-75.19],[-58.52,-75.19],[-59.77,-74.44],[-60.27,-74.44],[-61.02,-73.94],[-61.77,-73.94],[-62.77,-73.44],[-65.77,-73.44],[-66.02,-73.69],[-67.77,-73.94],[-70.27,-75.19],[-70.77,-75.19],[-71.27,-74.69],[-71.77,-73.69],[-72.02,-72.19],[-72.27,-71.94],[-72.52,-70.69],[-73.02,-69.94],[-73.02,-69.44],[-73.52,-68.69],[-73.52,-68.19],[-74.02,-67.44],[-74.02,-66.94],[-74.77,-65.94],[-74.77,-65.44],[-76.02,-62.94],[-76.52,-62.44],[-76.52,-61.94],[-77.52,-60.69],[-77.77,-59.94],[-78.27,-59.44],[-78.77,-58.44],[-80.02,-57.19],[-80.02,-56.94],[-80.77,-56.19],[-80.77,-55.94],[-82.27,-54.44],[-82.27,-53.94],[-81.77,-53.44],[-79.77,-52.69],[-77.27,-50.94],[-76.52,-50.69],[-75.52,-49.69],[-75.27,-49.69],[-71.77,-46.19],[-71.77,-45.94],[-70.27,-43.94],[-70.02,-42.94],[-69.52,-42.19],[-69.52,-41.19],[-69.27,-40.94],[-69.52,-39.69],[-70.77,-38.94],[-73.52,-38.94],[-73.77,-38.69],[-75.02,-38.69],[-75.27,-38.44],[-77.27,-38.44],[-77.52,-38.19],[-78.52,-38.19],[-79.52,-37.69],[-80.52,-37.69],[-81.27,-37.19],[-82.02,-37.19],[-82.52,-36.69],[-83.77,-36.44],[-86.77,-34.94],[-87.27,-34.44],[-87.52,-34.44],[-88.02,-33.94],[-89.77,-32.94],[-92.27,-30.69],[-92.52,-30.69],[-99.27,-23.94],[-99.52,-23.44],[-99.52,-22.69],[-99.02,-22.44],[-95.77,-19.44],[-94.77,-19.19],[-92.77,-21.69],[-92.77,-21.94],[-91.52,-23.19],[-91.52,-23.44],[-88.52,-26.44],[-88.27,-26.44],[-87.27,-27.44],[-86.52,-27.69],[-84.02,-29.44],[-83.52,-29.44],[-83.02,-29.94],[-82.02,-30.44],[-81.52,-30.44],[-81.02,-30.94],[-80.52,-30.94],[-79.27,-31.69],[-78.52,-31.69],[-77.77,-32.19],[-77.02,-32.19],[-76.77,-32.44],[-76.27,-32.44],[-75.27,-32.94],[-74.27,-32.94],[-73.27,-33.44],[-72.02,-33.44],[-71.02,-33.94],[-69.27,-33.94],[-68.52,-34.69],[-68.52,-35.19],[-68.02,-36.19],[-68.02,-37.44],[-67.52,-38.44],[-67.52,-39.69],[-67.27,-39.94],[-67.27,-40.44],[-67.02,-40.69],[-67.02,-41.19],[-66.77,-41.44],[-66.77,-41.94],[-66.27,-42.94],[-66.27,-43.69],[-65.77,-44.44],[-65.77,-45.19],[-64.52,-47.69],[-64.52,-48.19],[-64.02,-48.69],[-64.02,-49.19],[-63.52,-49.69],[-63.52,-50.19],[-63.02,-50.69],[-62.77,-51.69],[-62.27,-52.19],[-62.27,-52.69],[-61.77,-53.19],[-61.02,-54.69],[-61.02,-55.19],[-60.52,-55.94],[-60.52,-60.94],[-60.27,-61.19],[-60.02,-64.44],[-59.27,-65.94],[-59.27,-66.44],[-58.27,-68.19],[-56.77,-69.69],[-56.52,-69.69],[-55.77,-70.44],[-54.52,-70.94],[-54.02,-71.44],[-53.27,-71.44],[-52.27,-71.94],[-50.27,-71.94],[-49.77,-71.44],[-49.27,-71.44],[-48.02,-70.19],[-47.77,-69.69],[-47.77,-68.44],[-47.52,-68.19],[-47.52,-67.69],[-47.77,-67.44],[-47.77,-66.44],[-48.02,-66.19],[-48.02,-65.69],[-48.52,-64.69],[-49.02,-64.19],[-49.27,-63.44],[-50.27,-62.44],[-50.27,-62.19],[-55.77,-56.69],[-55.77,-56.44],[-56.77,-55.44],[-58.52,-51.94],[-58.52,-51.19],[-59.02,-50.19],[-59.02,-48.94],[-59.52,-47.94],[-59.77,-43.94],[-60.02,-43.69],[-60.02,-37.19],[-59.77,-36.94],[-59.77,-34.94],[-59.27,-34.44],[-58.77,-34.19],[-58.02,-34.19],[-57.77,-33.94],[-56.02,-33.94],[-55.02,-33.44],[-53.27,-33.44],[-53.02,-33.19],[-52.02,-33.19],[-51.77,-32.94],[-50.27,-32.94],[-50.02,-32.69],[-48.52,-32.69],[-48.27,-32.44],[-47.02,-32.44],[-46.77,-32.19],[-45.27,-32.19],[-45.02,-31.94],[-44.27,-31.94],[-44.02,-31.69],[-42.77,-31.69],[-42.52,-31.44],[-41.77,-31.44],[-41.52,-31.19],[-40.27,-31.19],[-40.02,-30.94],[-39.27,-30.94],[-39.02,-30.69],[-36.77,-30.44],[-35.77,-29.94],[-34.52,-29.94],[-33.77,-29.44],[-32.77,-29.44],[-32.52,-29.19],[-31.77,-29.19],[-31.52,-28.94],[-30.77,-28.94],[-30.52,-28.69],[-29.52,-28.69],[-28.52,-28.19],[-27.27,-28.19],[-26.27,-27.69],[-24.27,-27.44],[-23.52,-26.94],[-23.02,-26.94],[-22.02,-26.19],[-21.52,-25.19],[-21.27,-23.69],[-21.02,-23.44],[-21.02,-17.19],[-21.27,-16.94],[-21.27,-14.94],[-21.52,-14.69],[-21.77,-11.44],[-22.02,-11.19],[-22.02,-10.44],[-22.27,-10.19],[-22.27,-8.69],[-22.77,-7.69],[-22.77,-6.44],[-23.27,-5.44],[-23.27,-4.69],[-23.52,-4.44],[-23.52,-3.69],[-24.02,-2.69],[-24.02,-1.94],[-24.27,-1.69],[-24.27,-1.19],[-24.52,-0.94],[-24.52,-0.44],[-24.77,-0.19],[-24.77,0.31],[-25.02,0.56],[-25.02,1.06],[-25.27,1.31],[-25.77,3.31],[-26.27,4.06],[-26.27,4.56],[-26.77,5.06],[-27.02,6.31],[-27.52,6.81],[-27.52,7.31],[-28.02,7.81],[-28.02,8.31],[-28.77,9.81],[-29.77,11.06],[-30.52,12.56],[-31.27,13.31],[-31.27,13.56],[-32.02,14.31],[-32.02,14.56],[-35.02,17.81],[-35.27,17.81],[-36.77,19.31],[-37.77,19.81],[-39.27,21.06],[-40.02,21.31],[-40.52,21.81],[-41.02,21.81],[-42.27,22.81],[-47.27,25.31],[-47.77,25.31],[-49.77,26.31],[-51.27,26.56],[-52.02,27.06],[-52.77,27.06],[-53.77,27.56],[-54.77,27.56],[-55.02,27.81],[-55.77,27.81],[-56.02,28.06],[-57.52,28.06],[-57.77,28.31],[-58.77,28.31],[-59.52,29.31],[-60.77,31.81],[-60.77,32.56],[-61.27,33.31],[-61.52,35.06],[-62.02,36.06],[-62.02,37.31],[-62.27,37.56],[-62.27,38.31],[-62.52,38.56],[-62.52,43.06],[-62.27,43.31],[-62.27,44.31],[-62.02,44.56],[-62.02,46.31],[-61.77,46.56],[-61.77,47.56],[-61.52,47.81],[-61.27,50.06],[-60.77,51.06],[-60.77,52.31],[-60.27,53.31],[-60.27,54.81],[-60.77,55.31],[-61.02,55.31],[-62.77,53.31],[-63.27,53.81],[-63.27,55.31],[-63.02,55.56],[-63.02,57.06],[-62.77,57.31],[-62.77,58.06],[-62.52,58.31],[-62.52,60.06],[-62.27,60.31],[-62.27,61.06],[-62.02,61.31],[-62.02,63.06],[-61.77,63.31],[-61.77,64.06],[-61.52,64.31],[-61.52,65.06],[-61.27,65.31],[-61.27,66.31],[-60.77,67.31],[-60.77,68.56],[-60.27,69.31],[-60.27,70.31],[-60.02,70.56],[-60.02,71.06],[-59.52,72.06],[-59.52,72.81],[-58.52,74.81],[-52.52,79.06],[-50.02,80.31],[-49.27,81.06],[-48.77,81.06],[-48.27,81.56],[-47.02,82.06],[-45.27,83.31],[-44.77,83.31],[-43.02,84.56],[-40.27,85.81],[-39.77,86.31],[-39.27,86.31],[-38.77,86.81],[-35.27,88.56],[-34.77,88.56],[-34.27,89.06],[-33.77,89.06],[-33.27,89.56],[-32.77,89.56],[-31.52,90.31],[-31.02,90.31],[-30.52,90.81],[-29.77,90.81],[-27.27,92.06],[-26.52,92.06],[-25.77,92.56],[-25.27,92.56],[-25.02,92.81],[-24.52,92.81],[-23.52,93.31],[-22.77,93.31],[-22.02,93.81],[-21.27,93.81],[-20.27,94.31],[-19.27,94.31],[-19.02,94.56],[-18.27,94.56],[-18.02,94.81],[-17.27,94.81],[-17.02,95.06],[-14.02,95.31],[-13.77,95.56],[-2.02,95.56],[-1.77,95.31],[-1.27,95.31],[-1.02,95.06],[-0.02,94.81],[1.23,93.81],[2.23,93.81],[2.73,94.31],[2.73,94.56],[3.98,95.56],[5.23,95.56],[5.48,95.81],[7.48,95.81],[7.73,96.06],[8.73,96.06],[8.98,95.81],[11.98,95.81],[12.23,95.56],[14.23,95.56],[14.48,95.31],[15.23,95.31],[15.48,95.06],[17.23,95.06],[17.48,94.81],[18.98,94.56],[19.23,94.31],[20.23,94.31],[20.48,94.06],[21.23,94.06],[21.48,93.81],[22.48,93.81],[23.23,93.31],[23.98,93.31],[24.23,93.06],[24.73,93.06],[25.73,92.56],[26.48,92.56],[26.73,92.31],[27.98,92.06],[28.73,91.56],[29.48,91.56],[30.73,90.81],[31.23,90.81],[33.73,89.56],[34.23,89.56],[34.98,89.06],[35.48,89.06],[35.98,88.56],[36.48,88.56],[36.98,88.06],[37.48,88.06],[38.48,87.31],[38.98,87.31],[39.48,86.81],[40.73,86.31],[41.23,85.81],[41.98,85.56],[42.48,85.06],[43.73,84.56],[46.23,82.81],[46.98,82.56],[47.48,82.06],[48.48,81.56],[49.23,80.81],[50.23,80.31],[53.48,77.56]];
PD_INK_PATHS = [[0,1,2,3,4,5,6,7,8,9,10,11,12,13,14,15,16,17,18,19,20,21,22,23,24,25,26,27,28,29,30,31,32],[33,34,35,36,37,38,39,40,41,42,43,44,45,46,47,48,49,50,51,52,53,54,55,56,57,58,59,60,61,62,63,64,65,66,67],[68,69,70,71,72,73,74,75,76,77,78,79,80,81,82,83,84,85,86,87,88,89,90,91,92,93,94,95,96,97,98,99,100,101,102,103,104,105,106,107,108,109,110,111,112,113,114,115,116,117,118,119,120,121,122,123,124,125,126,127,128,129,130,131,132,133,134,135,136,137,138,139,140,141,142,143,144,145,146,147,148,149,150,151,152,153,154,155,156,157,158,159,160,161,162,163,164,165,166,167,168,169,170,171,172,173,174,175,176,177,178,179,180,181,182,183,184,185,186,187,188,189,190,191,192,193,194,195,196,197,198,199,200,201,202,203,204,205,206,207,208,209,210,211,212,213,214,215,216,217,218,219,220,221,222,223,224,225,226,227,228,229,230,231,232,233,234,235,236,237,238,239,240,241,242,243,244,245,246,247,248,249,250,251,252,253,254,255,256,257,258,259,260,261,262,263,264,265,266,267,268,269,270,271,272,273,274,275,276,277,278,279,280,281,282,283,284,285,286,287,288,289,290,291,292,293,294,295,296,297,298,299,300,301,302,303,304,305,306,307,308,309,310,311,312,313,314,315,316,317,318,319,320,321,322,323,324,325,326,327,328,329,330,331,332,333,334,335,336,337,338,339,340,341,342,343,344,345,346,347,348,349,350,351,352,353,354,355,356,357,358,359,360,361,362,363,364,365,366,367,368,369,370,371,372,373,374,375,376,377,378,379,380,381,382,383,384,385,386,387,388,389,390,391,392,393,394,395,396,397,398,399,400,401,402,403,404,405,406,407,408,409,410,411,412,413,414,415,416,417,418,419,420,421,422,423,424,425,426,427,428,429,430,431,432,433,434,435,436,437,438,439,440,441,442,443,444,445,446,447,448,449,450,451,452,453,454,455,456,457,458,459,460,461,462,463,464,465,466,467,468,469,470,471,472,473,474,475,476,477,478,479,480,481,482,483,484,485,486,487,488,489,490,491,492,493,494,495,496,497,498,499,500,501,502,503,504,505,506,507,508,509,510,511,512,513,514,515,516,517,518,519,520,521,522,523,524,525,526,527,528,529,530,531,532,533,534,535,536,537,538,539,540,541,542,543,544,545,546,547,548,549,550,551,552,553,554,555,556,557,558,559,560,561,562,563,564,565,566,567,568,569,570,571,572,573,574,575,576,577,578,579,580,581,582,583,584,585,586,587,588,589,590,591,592,593,594,595,596,597,598,599,600,601,602,603,604,605,606,607,608,609,610,611,612,613,614,615,616,617,618,619,620,621,622,623,624,625,626,627,628,629,630,631,632,633,634,635,636,637,638,639,640,641,642,643,644,645,646,647,648,649,650,651,652,653,654,655,656,657,658,659,660,661,662,663,664,665,666,667,668,669,670,671,672,673,674,675,676,677,678,679,680,681,682,683,684,685,686,687,688,689,690,691,692,693,694,695,696,697,698,699,700,701,702,703,704,705,706,707,708,709,710,711,712,713,714,715,716,717,718,719,720,721,722,723,724,725,726,727,728,729,730,731,732,733,734,735,736,737,738,739,740,741,742,743,744,745,746,747,748,749,750,751,752,753,754,755,756,757,758,759,760,761,762,763,764,765,766,767,768,769,770,771],[772,773,774,775,776,777,778,779,780,781,782,783,784,785,786,787,788,789,790,791,792,793,794,795,796,797,798,799,800,801,802,803,804,805,806,807,808,809,810,811,812,813,814,815,816,817,818,819,820,821,822,823,824,825,826,827,828,829,830,831,832,833,834,835,836,837,838,839,840,841,842,843,844,845,846,847,848,849,850,851,852,853,854,855,856,857,858],[859,860,861,862,863,864,865,866,867,868,869,870,871,872,873,874,875,876,877,878,879,880,881,882,883,884,885,886,887,888,889,890,891,892,893,894,895,896,897,898,899,900,901,902,903,904,905,906,907,908,909,910,911,912,913,914,915,916,917,918,919,920,921,922,923,924,925,926,927,928,929,930,931,932,933,934,935,936,937,938,939,940,941,942,943,944,945],[946,947,948,949,950,951,952,953,954,955,956,957,958,959,960,961,962,963,964,965,966,967,968,969,970,971,972,973,974,975,976,977,978,979,980,981,982,983,984,985,986,987,988,989,990,991,992,993,994,995,996,997,998,999,1000,1001,1002,1003,1004,1005,1006,1007,1008,1009,1010,1011,1012,1013,1014,1015,1016,1017,1018,1019,1020,1021,1022,1023,1024,1025,1026,1027,1028,1029,1030,1031,1032,1033,1034,1035,1036,1037,1038,1039,1040,1041,1042,1043,1044,1045,1046,1047,1048,1049,1050,1051,1052,1053,1054,1055,1056,1057,1058,1059,1060,1061,1062,1063,1064,1065,1066,1067,1068,1069,1070,1071,1072,1073,1074,1075,1076,1077,1078,1079,1080,1081,1082,1083,1084,1085,1086,1087,1088,1089,1090,1091,1092,1093,1094,1095,1096,1097,1098,1099,1100,1101,1102,1103,1104,1105,1106,1107,1108,1109,1110,1111,1112,1113,1114,1115,1116,1117,1118,1119,1120,1121,1122,1123,1124,1125,1126,1127,1128,1129,1130,1131,1132,1133,1134,1135,1136,1137,1138,1139,1140,1141,1142,1143,1144,1145,1146,1147,1148,1149,1150,1151,1152,1153,1154,1155,1156,1157,1158,1159,1160,1161,1162,1163,1164,1165,1166,1167,1168,1169,1170,1171,1172,1173,1174,1175,1176,1177,1178,1179,1180,1181,1182,1183,1184,1185,1186,1187,1188,1189,1190,1191,1192,1193,1194,1195,1196,1197,1198,1199,1200,1201,1202,1203,1204,1205,1206,1207,1208,1209,1210,1211,1212,1213,1214,1215,1216,1217,1218,1219,1220,1221,1222,1223,1224,1225,1226,1227,1228,1229,1230,1231,1232,1233,1234,1235,1236,1237,1238,1239,1240,1241,1242,1243,1244,1245,1246,1247,1248,1249,1250,1251,1252,1253,1254,1255,1256,1257,1258,1259,1260,1261,1262,1263,1264,1265,1266,1267,1268,1269,1270,1271,1272,1273,1274,1275,1276,1277,1278,1279,1280,1281,1282,1283,1284,1285,1286,1287,1288,1289,1290,1291,1292,1293,1294,1295,1296,1297,1298,1299,1300,1301,1302,1303,1304,1305,1306,1307,1308,1309,1310,1311,1312,1313,1314,1315,1316,1317,1318,1319,1320,1321,1322,1323,1324,1325,1326,1327,1328,1329,1330,1331,1332,1333,1334,1335,1336,1337,1338,1339,1340,1341,1342,1343,1344,1345,1346,1347,1348,1349,1350,1351,1352,1353,1354,1355,1356,1357,1358,1359,1360,1361,1362,1363,1364,1365,1366,1367,1368,1369,1370,1371,1372,1373,1374,1375,1376,1377,1378,1379,1380,1381,1382,1383,1384,1385,1386,1387,1388,1389,1390,1391,1392,1393,1394,1395,1396,1397,1398,1399,1400,1401,1402,1403,1404,1405,1406,1407,1408,1409,1410,1411,1412,1413,1414,1415,1416,1417,1418,1419,1420,1421,1422,1423,1424,1425,1426,1427,1428,1429,1430,1431,1432,1433,1434,1435,1436,1437,1438,1439,1440,1441,1442,1443,1444,1445,1446,1447,1448,1449,1450,1451,1452,1453,1454,1455,1456,1457,1458,1459,1460,1461,1462,1463,1464,1465,1466,1467,1468,1469,1470,1471,1472,1473,1474,1475,1476,1477,1478,1479,1480,1481,1482,1483,1484,1485,1486,1487,1488,1489,1490,1491,1492,1493,1494,1495,1496,1497,1498,1499,1500,1501,1502,1503,1504,1505,1506,1507,1508,1509,1510,1511,1512,1513,1514,1515,1516,1517,1518,1519,1520,1521,1522,1523,1524,1525,1526,1527,1528,1529,1530,1531,1532,1533,1534,1535,1536,1537,1538,1539,1540,1541,1542,1543,1544,1545,1546,1547,1548,1549,1550,1551,1552,1553,1554,1555,1556,1557,1558,1559,1560,1561,1562,1563,1564,1565,1566,1567,1568,1569,1570,1571,1572,1573,1574,1575,1576,1577,1578,1579,1580,1581,1582,1583,1584,1585,1586,1587,1588,1589,1590,1591,1592,1593,1594,1595,1596,1597,1598,1599,1600,1601,1602,1603,1604,1605,1606,1607,1608,1609,1610,1611,1612,1613,1614,1615,1616,1617,1618,1619,1620,1621,1622,1623,1624,1625,1626,1627,1628,1629,1630,1631,1632,1633,1634,1635,1636,1637,1638,1639,1640,1641,1642,1643,1644,1645,1646,1647,1648,1649,1650,1651,1652,1653,1654,1655,1656,1657,1658,1659,1660,1661,1662,1663,1664,1665,1666,1667,1668,1669,1670,1671,1672,1673,1674,1675,1676,1677,1678,1679,1680,1681,1682,1683,1684,1685,1686,1687,1688,1689,1690,1691,1692,1693,1694,1695,1696,1697,1698,1699,1700,1701,1702,1703,1704,1705,1706,1707,1708,1709,1710,1711,1712,1713,1714,1715,1716,1717,1718,1719,1720,1721,1722,1723,1724,1725,1726,1727,1728,1729,1730,1731,1732,1733,1734,1735,1736,1737,1738,1739,1740,1741,1742,1743,1744,1745,1746,1747,1748,1749,1750,1751,1752,1753,1754,1755,1756,1757,1758,1759,1760,1761,1762,1763,1764,1765,1766,1767,1768,1769,1770,1771,1772,1773,1774,1775,1776,1777,1778,1779,1780,1781,1782,1783,1784,1785,1786,1787,1788,1789,1790,1791,1792,1793,1794,1795,1796,1797,1798,1799,1800,1801,1802,1803,1804,1805,1806,1807,1808,1809,1810,1811,1812,1813,1814,1815,1816,1817,1818,1819,1820,1821,1822,1823,1824,1825,1826,1827,1828,1829,1830,1831,1832,1833,1834,1835,1836,1837,1838,1839,1840,1841,1842,1843]];
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
