ibitlab/pub-shadow-lamp-pierrot/versions/v002-low-outline/generated/pierrot_data.scad

// Generated by tools/make_data.py from the drawing. Do not edit by hand;
// rerun the script instead (see README). Units: mm, origin under the LED.

PD_PUPIL_MM = 100;
PD_LAMP_HEIGHT = 80;   // LED height the cleanup was done for
PD_WALL = 2.4;
PD_RIM = 4.90;   // black outline of the lid (drawing's line weight)
PD_BASE = 4;
PD_MIN_SOLID = 1.2;
PD_MIN_HOLE = 1;
PD_Z_TOP = 55.9;   // highest hole in the wall
PD_EXTENT = [-219.8,-269.7,224.2,230.8];   // lit area on the table
PD_PUPILS = [[-50.23,-7.63],[49.77,-7.23]];
PD_WIRE = [83.20,-55.70];   // outer wall point of the wire rib
PD_PINS = [[34.35,16.94],[-35.50,23.81],[-3.05,-46.04]];

PD_LID = [[54.45,79.05],[54.20,79.05],[53.45,79.80],[53.20,79.80],[52.45,80.55],[52.20,80.55],[50.45,82.05],[50.20,82.05],[49.70,82.55],[48.45,83.05],[45.45,85.30],[44.95,85.30],[42.95,86.80],[42.45,86.80],[41.45,87.55],[41.20,87.55],[40.95,87.80],[40.45,87.80],[39.20,88.80],[38.70,88.80],[37.70,89.55],[37.20,89.55],[36.45,90.05],[35.95,90.05],[35.45,90.55],[34.70,90.55],[34.20,91.05],[33.70,91.05],[33.45,91.30],[33.20,91.30],[32.95,91.55],[32.45,91.55],[31.70,92.05],[30.45,92.30],[29.95,92.80],[29.20,92.80],[28.95,93.05],[28.45,93.05],[28.20,93.30],[27.70,93.30],[27.45,93.55],[26.95,93.55],[26.70,93.80],[25.95,93.80],[25.70,94.05],[25.20,94.05],[24.95,94.30],[24.45,94.30],[24.20,94.55],[23.70,94.55],[23.45,94.80],[22.70,94.80],[22.45,95.05],[21.95,95.05],[21.70,95.30],[20.70,95.30],[20.45,95.55],[19.95,95.55],[19.70,95.80],[18.70,95.80],[18.45,96.05],[17.45,96.05],[17.20,96.30],[16.20,96.30],[15.95,96.55],[14.45,96.55],[14.20,96.80],[12.45,96.80],[12.20,97.05],[5.95,97.05],[5.70,96.80],[2.95,96.80],[2.70,96.55],[-1.80,96.55],[-2.05,96.80],[-13.05,96.80],[-13.30,96.55],[-15.30,96.55],[-15.55,96.30],[-17.05,96.30],[-17.30,96.05],[-18.30,96.05],[-18.55,95.80],[-19.05,95.80],[-19.30,95.55],[-20.30,95.55],[-20.55,95.30],[-21.05,95.30],[-21.30,95.05],[-22.05,95.05],[-22.30,94.80],[-22.80,94.80],[-23.05,94.55],[-24.05,94.55],[-24.30,94.30],[-24.80,94.30],[-25.55,93.80],[-26.05,93.80],[-26.30,93.55],[-26.80,93.55],[-27.05,93.30],[-28.30,93.05],[-29.05,92.55],[-29.55,92.55],[-29.80,92.30],[-30.30,92.30],[-31.05,91.80],[-31.55,91.80],[-32.30,91.30],[-32.80,91.30],[-33.30,90.80],[-33.55,90.80],[-33.80,90.55],[-34.30,90.55],[-34.80,90.05],[-35.55,90.05],[-36.05,89.55],[-36.30,89.55],[-36.55,89.30],[-37.05,89.30],[-37.55,88.80],[-37.80,88.80],[-38.05,88.55],[-38.55,88.55],[-39.55,87.80],[-40.05,87.80],[-41.30,86.80],[-41.80,86.80],[-42.05,86.55],[-42.30,86.55],[-42.80,86.05],[-44.05,85.55],[-44.55,85.05],[-44.80,85.05],[-45.05,84.80],[-45.55,84.80],[-46.80,83.80],[-47.30,83.80],[-47.55,83.55],[-47.80,83.55],[-48.30,83.05],[-48.55,83.05],[-49.05,82.55],[-49.55,82.55],[-51.55,81.05],[-52.05,81.05],[-52.55,80.55],[-52.80,80.55],[-53.30,80.05],[-53.55,80.05],[-54.05,79.55],[-54.30,79.55],[-55.05,78.80],[-55.30,78.80],[-55.55,78.55],[-56.05,78.55],[-56.80,77.80],[-57.05,77.80],[-59.05,75.80],[-59.30,75.80],[-59.80,75.30],[-59.80,75.05],[-61.05,73.55],[-61.05,73.30],[-61.30,73.05],[-61.30,72.55],[-62.05,71.55],[-62.05,70.80],[-62.30,70.55],[-62.30,70.05],[-62.80,69.30],[-62.80,68.55],[-63.05,68.30],[-63.05,67.55],[-63.30,67.30],[-63.30,66.80],[-63.55,66.55],[-63.55,65.30],[-63.80,65.05],[-63.80,64.55],[-64.05,64.30],[-64.05,63.05],[-64.30,62.80],[-64.30,61.55],[-64.55,61.30],[-64.55,60.30],[-64.80,60.05],[-64.80,58.80],[-65.05,58.55],[-65.05,55.55],[-65.30,55.30],[-65.30,54.55],[-65.05,54.30],[-65.05,51.80],[-64.80,51.55],[-64.80,49.80],[-64.55,49.55],[-64.55,43.30],[-64.80,43.05],[-64.80,37.30],[-64.55,37.05],[-64.55,35.55],[-64.30,35.30],[-64.30,34.30],[-64.05,34.05],[-64.05,33.05],[-63.80,32.80],[-63.80,32.05],[-63.55,31.80],[-63.55,30.80],[-63.30,30.55],[-63.30,29.30],[-63.05,29.05],[-63.05,27.05],[-63.30,26.80],[-63.30,25.55],[-63.55,25.30],[-63.55,24.80],[-64.05,24.05],[-64.05,23.55],[-64.30,23.30],[-64.30,23.05],[-65.30,22.05],[-66.05,21.80],[-66.55,21.30],[-67.30,21.30],[-68.05,20.80],[-69.05,20.80],[-69.30,20.55],[-70.30,20.55],[-70.55,20.30],[-71.80,20.30],[-72.55,19.80],[-73.80,19.80],[-74.55,19.30],[-75.05,19.30],[-75.30,19.05],[-76.05,19.05],[-76.30,18.80],[-76.55,18.80],[-76.80,18.55],[-77.05,18.55],[-77.30,18.30],[-79.05,17.55],[-79.55,17.05],[-79.80,17.05],[-80.05,16.80],[-80.05,16.55],[-80.30,16.30],[-80.55,16.30],[-82.55,14.30],[-82.55,14.05],[-83.55,13.05],[-83.55,12.55],[-83.80,12.30],[-83.80,12.05],[-84.55,11.30],[-84.55,10.80],[-85.30,9.80],[-85.30,9.30],[-85.80,8.80],[-85.80,8.30],[-86.05,8.05],[-86.05,7.80],[-86.80,7.05],[-86.80,6.55],[-87.05,6.30],[-87.05,6.05],[-87.55,5.55],[-87.55,5.30],[-88.05,4.80],[-88.05,4.55],[-88.55,4.05],[-88.55,3.80],[-89.05,3.30],[-89.05,3.05],[-90.55,1.05],[-90.55,0.80],[-91.30,-0.20],[-91.30,-0.45],[-92.05,-0.95],[-92.05,-1.20],[-92.80,-2.20],[-92.80,-2.45],[-94.80,-4.70],[-94.80,-4.95],[-95.55,-5.70],[-95.55,-5.95],[-96.30,-6.45],[-96.30,-6.70],[-97.05,-7.45],[-97.05,-7.70],[-98.55,-9.20],[-98.55,-9.45],[-99.30,-10.20],[-99.55,-10.95],[-100.30,-11.70],[-100.80,-12.95],[-101.55,-13.95],[-101.55,-14.70],[-101.80,-14.95],[-101.80,-15.70],[-102.05,-15.95],[-102.05,-19.95],[-101.80,-20.20],[-101.80,-21.70],[-101.55,-21.95],[-101.55,-23.20],[-101.30,-23.45],[-101.30,-23.95],[-101.05,-24.20],[-101.05,-24.95],[-100.80,-25.20],[-100.80,-25.70],[-100.05,-26.70],[-99.80,-27.45],[-99.30,-27.95],[-99.30,-28.20],[-98.55,-28.70],[-98.55,-28.95],[-98.05,-29.45],[-98.05,-29.70],[-97.80,-29.95],[-97.55,-29.95],[-97.30,-30.20],[-97.30,-30.45],[-97.05,-30.70],[-96.80,-30.70],[-94.55,-32.95],[-94.30,-32.95],[-93.30,-33.95],[-93.05,-33.95],[-92.55,-34.70],[-92.30,-34.70],[-91.80,-35.20],[-91.05,-35.45],[-90.55,-36.20],[-89.80,-36.45],[-89.30,-36.95],[-87.55,-37.70],[-87.05,-38.20],[-86.80,-38.20],[-86.55,-38.45],[-86.30,-38.45],[-83.55,-39.95],[-82.80,-39.95],[-81.55,-40.70],[-80.55,-40.70],[-79.80,-41.20],[-79.05,-41.20],[-78.05,-41.95],[-77.30,-42.20],[-76.05,-43.45],[-76.05,-44.45],[-76.30,-44.70],[-76.30,-45.45],[-76.55,-45.70],[-76.80,-46.45],[-78.30,-48.45],[-78.80,-49.70],[-80.05,-50.95],[-80.55,-52.20],[-81.05,-52.70],[-81.05,-52.95],[-82.30,-55.20],[-82.30,-56.20],[-82.55,-56.45],[-82.55,-57.45],[-82.30,-57.70],[-82.30,-58.70],[-82.05,-58.95],[-81.80,-59.70],[-80.80,-60.95],[-80.80,-61.45],[-80.55,-61.70],[-80.55,-61.95],[-80.05,-62.45],[-80.05,-62.70],[-78.55,-64.70],[-78.55,-64.95],[-78.05,-65.70],[-78.05,-66.20],[-77.55,-66.70],[-77.55,-66.95],[-77.05,-67.70],[-77.05,-68.20],[-76.80,-68.45],[-76.55,-69.20],[-76.05,-69.70],[-76.05,-70.45],[-75.30,-71.45],[-75.30,-72.20],[-75.05,-72.45],[-75.05,-72.70],[-74.55,-73.20],[-74.30,-73.95],[-72.80,-75.95],[-72.55,-75.95],[-72.05,-76.45],[-71.80,-76.45],[-70.55,-77.20],[-69.30,-77.20],[-69.05,-77.45],[-63.05,-77.45],[-62.80,-77.70],[-61.05,-77.70],[-60.80,-77.95],[-60.05,-77.95],[-59.80,-78.20],[-58.80,-78.20],[-58.55,-78.45],[-58.05,-78.45],[-57.80,-78.70],[-57.05,-78.70],[-56.80,-78.95],[-56.30,-78.95],[-56.05,-79.20],[-55.30,-79.20],[-54.80,-79.70],[-54.05,-79.70],[-53.80,-79.95],[-53.30,-79.95],[-53.05,-80.20],[-52.05,-80.20],[-51.80,-80.45],[-50.55,-80.45],[-50.30,-80.70],[-48.05,-80.70],[-47.80,-80.45],[-47.05,-80.45],[-46.80,-80.20],[-46.05,-80.20],[-45.80,-79.95],[-45.30,-79.95],[-44.05,-79.20],[-43.55,-79.20],[-42.30,-78.45],[-41.80,-78.45],[-40.55,-77.70],[-40.05,-77.70],[-38.30,-76.70],[-37.55,-76.70],[-36.80,-76.20],[-36.05,-76.20],[-35.80,-75.95],[-35.05,-75.95],[-34.80,-75.70],[-33.80,-75.70],[-33.55,-75.45],[-30.30,-75.45],[-30.05,-75.70],[-29.05,-75.70],[-28.80,-75.95],[-28.05,-75.95],[-27.80,-76.20],[-26.55,-76.45],[-25.80,-76.95],[-24.55,-77.20],[-23.80,-77.70],[-23.30,-77.70],[-22.80,-78.20],[-22.30,-78.20],[-20.55,-79.20],[-20.05,-79.20],[-19.55,-79.70],[-19.05,-79.70],[-18.55,-80.20],[-18.05,-80.20],[-17.55,-80.70],[-16.30,-80.95],[-15.55,-81.45],[-15.05,-81.45],[-14.80,-81.70],[-14.30,-81.70],[-14.05,-81.95],[-13.55,-81.95],[-13.30,-82.20],[-12.55,-82.20],[-12.30,-82.45],[-11.55,-82.45],[-11.30,-82.70],[-10.30,-82.70],[-10.05,-82.95],[-9.30,-82.95],[-9.05,-83.20],[-7.55,-83.20],[-7.30,-83.45],[-5.80,-83.45],[-5.55,-83.70],[-3.05,-83.70],[-2.80,-83.95],[8.45,-83.95],[8.70,-83.70],[10.70,-83.70],[10.95,-83.45],[12.70,-83.45],[12.95,-83.20],[13.95,-83.20],[14.20,-82.95],[15.45,-82.95],[15.70,-82.70],[16.45,-82.70],[16.70,-82.45],[17.70,-82.45],[17.95,-82.20],[18.70,-82.20],[18.95,-81.95],[19.45,-81.95],[19.70,-81.70],[20.45,-81.70],[20.70,-81.45],[21.20,-81.45],[21.45,-81.20],[22.20,-81.20],[22.45,-80.95],[22.95,-80.95],[23.20,-80.70],[23.70,-80.70],[23.95,-80.45],[24.70,-80.45],[24.95,-80.20],[25.45,-80.20],[25.95,-79.70],[26.45,-79.70],[26.70,-79.45],[27.45,-79.20],[27.95,-78.70],[28.20,-78.70],[29.20,-77.95],[29.95,-77.70],[30.70,-76.95],[31.20,-76.95],[31.70,-76.45],[32.20,-76.45],[32.70,-75.95],[33.20,-75.95],[33.45,-75.70],[34.20,-75.70],[34.45,-75.45],[36.20,-75.45],[36.45,-75.20],[36.95,-75.20],[37.20,-75.45],[39.20,-75.45],[39.45,-75.70],[40.45,-75.70],[40.70,-75.95],[41.45,-75.95],[41.70,-76.20],[42.45,-76.20],[43.20,-76.70],[44.20,-76.70],[44.95,-77.20],[45.70,-77.20],[45.95,-77.45],[46.45,-77.45],[47.70,-78.20],[48.70,-78.20],[49.45,-78.70],[49.95,-78.70],[50.20,-78.95],[51.20,-78.95],[51.45,-79.20],[52.20,-79.20],[52.45,-79.45],[55.70,-79.45],[55.95,-79.20],[57.20,-79.20],[57.45,-78.95],[57.95,-78.95],[58.70,-78.45],[59.20,-78.45],[59.45,-78.20],[60.20,-78.20],[60.70,-77.70],[61.45,-77.70],[61.70,-77.45],[62.20,-77.45],[62.95,-76.95],[63.70,-76.95],[63.95,-76.70],[64.45,-76.70],[64.70,-76.45],[65.45,-76.45],[65.70,-76.20],[66.95,-76.20],[67.20,-75.95],[68.45,-75.95],[68.70,-75.70],[69.70,-75.70],[69.95,-75.45],[70.70,-75.45],[70.95,-75.20],[71.45,-75.20],[71.70,-74.95],[72.45,-74.70],[72.95,-74.20],[73.20,-74.20],[73.95,-73.45],[73.95,-73.20],[75.20,-71.95],[75.20,-71.20],[75.70,-70.70],[75.95,-69.95],[76.45,-69.45],[76.45,-69.20],[76.70,-68.95],[76.70,-68.45],[76.95,-68.20],[77.20,-67.45],[77.70,-66.95],[77.70,-66.20],[78.20,-65.70],[78.20,-65.45],[78.70,-64.70],[78.70,-64.20],[79.20,-63.70],[79.45,-62.95],[79.95,-62.45],[79.95,-62.20],[80.45,-61.70],[80.45,-61.45],[80.95,-60.95],[80.95,-60.70],[82.20,-59.20],[82.20,-58.70],[82.45,-58.45],[82.45,-58.20],[82.95,-57.45],[82.95,-56.95],[83.20,-56.70],[83.20,-54.95],[82.95,-54.70],[82.70,-53.45],[82.45,-53.20],[82.20,-52.45],[81.20,-51.20],[80.70,-49.95],[79.45,-48.70],[78.95,-47.45],[78.45,-46.95],[78.45,-46.70],[76.95,-44.70],[76.95,-44.45],[76.70,-44.20],[76.70,-42.45],[77.70,-41.20],[78.20,-41.20],[79.95,-40.20],[80.70,-40.20],[81.45,-39.70],[82.45,-39.70],[83.20,-39.20],[84.20,-39.20],[85.45,-38.45],[86.45,-38.45],[88.70,-37.20],[89.20,-37.20],[89.45,-36.95],[90.70,-36.45],[91.20,-35.95],[92.95,-35.20],[93.95,-34.20],[94.70,-33.95],[95.20,-33.20],[95.95,-32.95],[96.95,-31.95],[97.20,-31.95],[97.45,-31.70],[97.45,-31.45],[97.70,-31.20],[97.95,-31.20],[99.95,-29.20],[99.95,-28.95],[100.45,-28.45],[100.70,-27.70],[101.20,-27.20],[101.45,-26.45],[101.95,-25.95],[101.95,-25.20],[102.20,-24.95],[102.20,-24.45],[102.45,-24.20],[102.45,-23.45],[102.70,-23.20],[102.70,-22.20],[102.95,-21.95],[102.95,-20.20],[103.20,-19.95],[103.20,-17.70],[102.95,-17.45],[102.95,-16.70],[102.70,-16.45],[102.70,-15.70],[101.95,-14.70],[101.95,-14.45],[101.70,-14.20],[100.95,-12.45],[100.20,-11.70],[100.20,-11.45],[99.45,-10.70],[99.45,-10.45],[98.70,-9.70],[98.70,-9.45],[97.95,-8.70],[97.95,-8.45],[97.20,-7.95],[97.20,-7.70],[96.45,-6.95],[96.45,-6.70],[94.95,-5.20],[94.70,-4.45],[93.95,-3.95],[93.70,-3.20],[92.95,-2.70],[92.70,-1.95],[91.70,-0.95],[91.70,-0.70],[91.20,-0.20],[91.20,0.05],[90.70,0.55],[90.70,0.80],[89.70,1.80],[89.70,2.05],[88.20,4.05],[88.20,4.30],[87.95,4.55],[87.95,5.05],[86.95,6.30],[86.95,6.55],[86.70,6.80],[86.70,7.30],[85.95,8.05],[85.95,8.55],[85.45,9.30],[85.45,9.80],[84.95,10.30],[84.45,11.55],[83.95,12.05],[83.45,13.30],[82.70,14.05],[82.70,14.30],[80.70,16.30],[80.45,16.30],[79.70,17.30],[78.95,17.55],[78.45,18.05],[78.20,18.05],[76.45,19.05],[75.95,19.05],[75.70,19.30],[74.70,19.30],[73.95,19.80],[72.70,19.80],[71.95,20.30],[70.70,20.30],[70.45,20.55],[69.45,20.55],[69.20,20.80],[68.20,20.80],[67.95,21.05],[67.20,21.05],[65.95,21.80],[65.45,21.80],[65.20,22.05],[64.95,22.05],[63.70,23.55],[63.70,23.80],[63.45,24.05],[63.45,24.55],[63.20,24.80],[63.20,25.30],[62.95,25.55],[62.95,26.05],[62.70,26.30],[62.70,26.80],[62.45,27.05],[62.45,28.80],[62.20,29.05],[62.45,29.30],[62.45,31.30],[62.70,31.55],[62.70,32.55],[62.95,32.80],[62.95,33.30],[63.20,33.55],[63.20,34.05],[63.45,34.30],[63.45,35.30],[63.70,35.55],[63.70,36.30],[63.95,36.55],[63.95,37.55],[64.20,37.80],[64.20,38.80],[64.45,39.05],[64.45,40.55],[64.70,40.80],[64.70,42.55],[64.95,42.80],[64.95,52.05],[64.70,52.30],[64.70,54.30],[64.45,54.55],[64.45,56.05],[64.20,56.30],[64.20,57.80],[63.95,58.05],[63.95,59.05],[63.70,59.30],[63.70,60.30],[63.45,60.55],[63.45,61.80],[63.20,62.05],[63.20,63.05],[62.95,63.30],[62.95,64.05],[62.70,64.30],[62.70,65.30],[62.45,65.55],[62.45,66.30],[62.20,66.55],[62.20,67.05],[61.95,67.30],[61.95,68.05],[61.45,68.80],[61.45,69.30],[61.20,69.55],[61.20,70.30],[60.70,71.05],[60.70,71.55],[59.95,72.55],[59.95,72.80],[59.45,73.30],[59.45,73.55],[58.95,74.05],[58.95,74.30],[57.20,76.30],[57.20,76.55],[56.95,76.80],[56.70,76.80],[55.70,77.80],[55.45,77.80],[54.70,78.55],[54.70,78.80]];

PD_INK_POINTS = [[-51.30,-1.20],[-51.55,-1.45],[-52.55,-1.70],[-53.30,-2.45],[-53.55,-2.45],[-54.05,-2.95],[-55.05,-4.95],[-55.05,-5.45],[-55.30,-5.70],[-55.30,-9.45],[-54.80,-10.20],[-54.80,-10.95],[-52.80,-13.45],[-52.30,-13.45],[-51.80,-13.95],[-51.30,-13.95],[-51.05,-14.20],[-49.05,-14.20],[-47.55,-13.45],[-46.30,-12.20],[-46.05,-11.45],[-45.55,-10.95],[-45.55,-10.20],[-45.05,-9.20],[-45.05,-6.20],[-45.55,-5.45],[-45.55,-4.70],[-46.05,-3.70],[-47.05,-2.45],[-47.30,-2.45],[-48.55,-1.45],[-49.30,-1.45],[-49.55,-1.20],[48.45,-0.95],[47.95,-1.45],[47.45,-1.45],[45.70,-3.20],[45.70,-3.70],[45.20,-4.20],[45.20,-4.70],[44.95,-4.95],[44.95,-5.95],[44.70,-6.20],[44.70,-8.70],[44.95,-8.95],[44.95,-9.70],[45.20,-9.95],[45.20,-10.45],[45.70,-11.45],[47.20,-12.95],[47.45,-12.95],[47.95,-13.45],[48.70,-13.45],[48.95,-13.70],[50.70,-13.70],[52.70,-12.70],[54.20,-10.95],[54.20,-10.45],[54.70,-9.70],[54.70,-8.95],[54.95,-8.70],[54.95,-5.70],[54.70,-5.45],[54.70,-4.70],[54.20,-3.95],[54.20,-3.45],[52.20,-1.45],[51.20,-0.95],[54.95,27.05],[54.70,26.80],[53.95,26.80],[53.70,26.55],[52.95,26.55],[52.70,26.30],[50.95,26.05],[50.20,25.55],[49.70,25.55],[49.45,25.30],[47.45,24.80],[45.70,23.80],[44.45,23.55],[43.95,23.05],[43.45,23.05],[42.95,22.55],[42.45,22.55],[41.95,22.05],[40.70,21.55],[39.95,20.80],[39.45,20.80],[37.95,19.55],[37.70,19.55],[36.20,18.30],[35.95,18.30],[31.20,13.55],[31.20,13.30],[30.45,12.55],[30.45,12.30],[28.95,10.30],[28.70,9.55],[28.20,9.05],[27.45,7.30],[26.95,6.80],[26.95,6.30],[26.45,5.80],[26.45,5.30],[25.95,4.80],[25.95,4.30],[24.70,1.80],[24.70,1.30],[24.45,1.05],[23.95,-0.95],[23.45,-1.70],[23.45,-2.45],[22.95,-3.20],[22.95,-4.20],[22.45,-4.95],[22.45,-5.95],[22.20,-6.20],[22.20,-6.70],[21.70,-7.70],[21.70,-9.20],[21.20,-10.20],[21.20,-11.45],[20.95,-11.70],[20.95,-12.45],[20.70,-12.70],[20.70,-14.20],[20.45,-14.45],[20.45,-15.95],[20.20,-16.20],[20.20,-17.20],[19.95,-17.45],[19.95,-23.70],[20.20,-23.95],[20.70,-25.95],[21.20,-26.45],[21.20,-26.70],[21.95,-27.45],[22.45,-27.45],[22.95,-27.95],[23.70,-27.95],[24.45,-28.45],[25.20,-28.45],[25.45,-28.70],[26.95,-28.70],[27.20,-28.95],[27.95,-28.95],[28.20,-29.20],[29.95,-29.20],[30.95,-29.70],[31.95,-29.70],[32.20,-29.95],[34.20,-30.20],[34.45,-30.45],[35.70,-30.45],[36.70,-30.95],[37.95,-30.95],[38.95,-31.45],[40.20,-31.45],[40.45,-31.70],[41.20,-31.70],[41.45,-31.95],[42.20,-31.95],[42.45,-32.20],[43.45,-32.20],[43.70,-32.45],[44.70,-32.45],[44.95,-32.70],[46.20,-32.70],[46.45,-32.95],[47.20,-32.95],[47.45,-33.20],[49.20,-33.20],[49.45,-33.45],[51.95,-33.70],[52.20,-33.95],[53.95,-33.95],[54.20,-34.20],[55.20,-34.20],[55.45,-34.45],[58.45,-34.45],[58.70,-34.70],[59.45,-34.70],[59.95,-34.95],[60.45,-35.95],[60.45,-37.45],[60.70,-37.70],[60.70,-43.45],[60.45,-43.70],[60.20,-48.20],[59.95,-48.45],[59.95,-49.20],[59.70,-49.45],[59.70,-50.95],[59.45,-51.20],[59.45,-51.95],[59.20,-52.20],[59.20,-53.45],[58.95,-53.70],[58.95,-54.70],[58.70,-54.95],[58.45,-56.95],[58.20,-57.20],[58.20,-57.70],[58.70,-58.20],[59.70,-57.70],[60.70,-56.70],[60.95,-56.70],[61.20,-56.20],[62.45,-54.95],[62.45,-54.70],[63.95,-52.70],[64.70,-51.20],[64.70,-50.70],[65.20,-50.20],[65.20,-49.70],[65.70,-48.95],[65.70,-48.45],[65.95,-48.20],[65.95,-47.70],[66.45,-46.70],[66.45,-45.95],[66.95,-45.20],[66.95,-44.45],[67.45,-43.45],[67.70,-41.70],[68.20,-40.70],[68.20,-39.70],[68.70,-38.95],[68.70,-37.95],[68.95,-37.70],[69.20,-35.45],[69.95,-34.70],[70.45,-34.70],[70.70,-34.45],[72.20,-34.45],[72.45,-34.20],[74.45,-33.95],[74.70,-33.70],[75.45,-33.70],[76.45,-33.20],[77.20,-33.20],[77.95,-32.70],[78.70,-32.70],[79.45,-32.20],[79.95,-32.20],[81.45,-31.45],[81.95,-31.45],[82.70,-30.95],[83.20,-30.95],[83.70,-30.45],[84.20,-30.45],[85.20,-29.70],[86.20,-29.20],[86.70,-29.20],[87.45,-28.45],[89.20,-27.45],[91.20,-25.70],[91.45,-25.70],[95.20,-21.70],[95.95,-21.70],[96.20,-21.95],[96.45,-21.70],[97.20,-21.70],[97.70,-21.20],[97.95,-20.70],[97.95,-17.70],[96.70,-15.20],[95.95,-14.45],[95.95,-14.20],[95.20,-13.45],[95.20,-13.20],[94.45,-12.45],[94.45,-12.20],[92.95,-10.70],[92.95,-10.45],[92.20,-9.70],[92.20,-9.45],[90.70,-7.95],[90.70,-7.70],[88.70,-5.45],[88.45,-4.70],[87.45,-3.70],[86.45,-1.95],[85.45,-0.95],[85.45,-0.70],[83.95,1.30],[82.20,4.80],[81.70,5.30],[81.20,6.30],[81.20,6.80],[80.20,8.80],[79.70,9.30],[79.20,10.55],[78.45,11.30],[78.45,11.55],[76.45,13.30],[73.95,14.55],[73.20,14.55],[72.95,14.80],[72.20,14.80],[71.95,15.05],[71.20,15.05],[70.95,15.30],[70.20,15.30],[69.95,15.55],[69.20,15.55],[68.95,15.80],[66.70,16.05],[66.45,16.30],[65.70,16.30],[65.45,16.55],[64.70,16.55],[64.45,16.80],[61.45,16.55],[61.20,16.30],[60.20,16.30],[59.95,16.05],[55.45,16.05],[55.20,16.30],[55.20,16.55],[55.70,17.05],[56.70,17.55],[58.95,19.55],[59.20,20.05],[59.20,21.55],[58.70,22.30],[58.70,22.80],[58.45,23.05],[58.45,23.55],[58.20,23.80],[58.20,24.30],[57.95,24.55],[57.95,25.05],[57.70,25.30],[57.45,26.30],[56.95,26.80],[58.70,9.30],[59.20,8.80],[59.95,8.80],[60.45,8.30],[61.70,7.80],[62.45,7.05],[63.45,6.55],[65.45,4.05],[65.45,3.55],[66.45,1.55],[66.45,0.80],[66.70,0.55],[66.70,-1.20],[66.95,-1.45],[66.95,-5.70],[66.70,-5.95],[66.70,-8.20],[66.20,-9.20],[66.20,-10.20],[65.45,-11.70],[65.45,-12.45],[64.95,-13.20],[64.95,-13.70],[64.45,-14.20],[64.45,-14.70],[63.20,-16.45],[62.95,-17.20],[61.45,-18.95],[61.45,-19.20],[58.70,-21.70],[55.45,-23.45],[54.95,-23.45],[54.70,-23.70],[53.45,-23.70],[52.45,-24.20],[49.70,-24.20],[49.45,-23.95],[48.70,-23.95],[48.45,-23.70],[47.45,-23.70],[45.95,-22.95],[45.20,-22.95],[44.70,-22.45],[44.20,-22.45],[43.70,-21.95],[42.95,-21.70],[41.20,-20.20],[40.95,-20.20],[39.45,-18.45],[39.45,-18.20],[38.45,-16.95],[38.45,-16.20],[37.95,-15.70],[37.95,-14.70],[37.70,-14.45],[37.70,-12.95],[37.45,-12.70],[37.45,-9.95],[37.70,-9.70],[37.70,-7.95],[37.95,-7.70],[37.95,-6.45],[38.20,-6.20],[38.45,-4.45],[38.95,-3.70],[38.95,-2.95],[39.45,-2.20],[39.45,-1.70],[40.95,1.30],[41.45,1.80],[42.45,3.55],[45.20,6.30],[45.45,6.30],[46.20,7.05],[46.45,7.05],[47.45,8.05],[48.95,8.80],[49.45,8.80],[50.20,9.30],[51.20,9.30],[51.45,9.55],[52.20,9.55],[52.45,9.80],[55.95,9.80],[56.20,9.55],[57.20,9.55],[57.45,9.30],[-56.55,27.05],[-56.80,26.80],[-57.55,26.80],[-58.30,25.80],[-58.30,24.55],[-58.55,24.30],[-58.80,23.05],[-59.30,22.30],[-59.30,21.80],[-59.80,21.05],[-59.80,20.05],[-59.55,19.55],[-58.05,18.05],[-57.80,18.05],[-56.80,17.05],[-56.55,17.05],[-55.80,16.30],[-55.55,16.30],[-55.30,15.80],[-55.55,15.55],[-57.80,15.55],[-58.05,15.80],[-59.05,15.80],[-59.30,16.05],[-61.05,16.05],[-61.30,16.30],[-62.05,16.30],[-62.30,16.55],[-63.55,16.55],[-63.80,16.80],[-64.55,16.80],[-64.80,16.55],[-65.55,16.55],[-66.55,16.05],[-67.55,16.05],[-67.80,15.80],[-68.80,15.80],[-69.05,15.55],[-69.80,15.55],[-70.05,15.30],[-70.80,15.30],[-71.05,15.05],[-72.80,14.80],[-73.05,14.55],[-74.30,14.30],[-76.30,13.30],[-77.55,12.05],[-77.80,12.05],[-79.05,10.55],[-79.55,9.30],[-80.05,8.80],[-82.80,3.30],[-86.30,-1.70],[-87.05,-3.20],[-88.05,-4.20],[-88.55,-5.20],[-90.55,-7.45],[-90.55,-7.70],[-91.30,-8.45],[-91.30,-8.70],[-94.30,-11.95],[-94.30,-12.20],[-95.05,-12.95],[-95.30,-13.70],[-96.05,-14.45],[-96.80,-15.95],[-96.80,-16.70],[-97.05,-16.95],[-97.05,-18.95],[-96.30,-19.95],[-94.80,-20.20],[-92.80,-22.70],[-92.80,-22.95],[-91.55,-24.20],[-91.55,-24.45],[-88.55,-27.45],[-88.30,-27.45],[-87.30,-28.45],[-86.55,-28.70],[-84.05,-30.45],[-83.55,-30.45],[-83.05,-30.95],[-82.05,-31.45],[-81.55,-31.45],[-81.05,-31.95],[-80.55,-31.95],[-79.30,-32.70],[-78.55,-32.70],[-77.80,-33.20],[-77.05,-33.20],[-76.05,-33.70],[-75.30,-33.70],[-75.05,-33.95],[-74.30,-33.95],[-74.05,-34.20],[-73.30,-34.20],[-73.05,-34.45],[-72.05,-34.45],[-71.80,-34.70],[-71.05,-34.70],[-70.80,-34.95],[-69.30,-34.95],[-68.55,-35.70],[-68.55,-36.20],[-68.05,-37.20],[-68.05,-38.45],[-67.55,-39.45],[-67.55,-40.70],[-67.30,-40.95],[-67.30,-41.45],[-67.05,-41.70],[-67.05,-42.20],[-66.80,-42.45],[-66.80,-42.95],[-66.30,-43.95],[-66.30,-44.70],[-65.80,-45.45],[-65.80,-46.20],[-64.55,-48.70],[-64.55,-49.20],[-64.05,-49.70],[-64.05,-50.20],[-63.55,-50.70],[-63.55,-51.20],[-63.05,-51.70],[-62.80,-52.70],[-62.30,-53.20],[-62.30,-53.70],[-61.80,-54.20],[-61.05,-55.70],[-61.05,-56.20],[-60.55,-56.95],[-60.55,-61.95],[-60.30,-62.20],[-60.05,-65.45],[-59.30,-66.95],[-59.30,-67.45],[-58.30,-69.20],[-55.80,-71.45],[-54.55,-71.95],[-54.05,-72.45],[-53.30,-72.45],[-53.05,-72.70],[-52.30,-72.70],[-52.05,-72.95],[-51.05,-72.95],[-50.80,-72.70],[-49.30,-72.45],[-48.05,-71.20],[-47.80,-70.70],[-47.80,-69.45],[-47.55,-69.20],[-47.55,-68.70],[-47.80,-68.45],[-47.80,-67.45],[-48.05,-67.20],[-48.05,-66.70],[-48.55,-65.70],[-49.05,-65.20],[-49.30,-64.45],[-50.30,-63.45],[-50.30,-63.20],[-55.80,-57.70],[-55.80,-57.45],[-56.80,-56.45],[-58.55,-52.95],[-58.55,-52.20],[-59.05,-51.20],[-59.05,-49.95],[-59.55,-48.95],[-59.80,-44.95],[-60.05,-44.70],[-60.05,-38.20],[-59.80,-37.95],[-59.80,-35.95],[-59.30,-35.45],[-58.80,-35.20],[-58.05,-35.20],[-57.80,-34.95],[-56.05,-34.95],[-55.05,-34.45],[-53.30,-34.45],[-53.05,-34.20],[-52.05,-34.20],[-51.80,-33.95],[-48.55,-33.70],[-48.30,-33.45],[-47.05,-33.45],[-46.80,-33.20],[-45.30,-33.20],[-45.05,-32.95],[-44.30,-32.95],[-44.05,-32.70],[-42.80,-32.70],[-42.55,-32.45],[-41.80,-32.45],[-41.55,-32.20],[-40.30,-32.20],[-40.05,-31.95],[-39.30,-31.95],[-39.05,-31.70],[-36.80,-31.45],[-35.80,-30.95],[-34.55,-30.95],[-33.80,-30.45],[-32.80,-30.45],[-32.55,-30.20],[-31.80,-30.20],[-31.55,-29.95],[-30.80,-29.95],[-30.55,-29.70],[-29.55,-29.70],[-28.55,-29.20],[-27.30,-29.20],[-26.30,-28.70],[-25.30,-28.70],[-25.05,-28.45],[-24.30,-28.45],[-23.55,-27.95],[-23.05,-27.95],[-22.05,-27.20],[-21.55,-26.20],[-21.30,-24.70],[-21.05,-24.45],[-21.05,-18.20],[-21.30,-17.95],[-21.30,-15.95],[-21.55,-15.70],[-21.80,-12.45],[-22.05,-12.20],[-22.05,-11.45],[-22.30,-11.20],[-22.30,-9.70],[-22.80,-8.70],[-22.80,-7.45],[-23.30,-6.45],[-23.55,-4.70],[-24.05,-3.70],[-24.05,-2.95],[-24.30,-2.70],[-24.30,-2.20],[-24.55,-1.95],[-24.55,-1.45],[-24.80,-1.20],[-24.80,-0.70],[-25.05,-0.45],[-25.05,0.05],[-25.30,0.30],[-25.80,2.30],[-26.30,3.05],[-26.30,3.55],[-26.80,4.05],[-27.05,5.30],[-27.55,5.80],[-27.55,6.30],[-28.05,6.80],[-28.05,7.30],[-28.80,8.80],[-29.80,10.05],[-30.55,11.55],[-32.05,13.30],[-32.05,13.55],[-33.80,15.30],[-33.80,15.55],[-36.80,18.30],[-37.05,18.30],[-38.55,19.55],[-40.05,20.30],[-40.55,20.80],[-41.05,20.80],[-42.30,21.80],[-47.30,24.30],[-47.80,24.30],[-49.80,25.30],[-51.30,25.55],[-52.05,26.05],[-52.80,26.05],[-53.05,26.30],[-53.80,26.30],[-54.05,26.55],[-54.80,26.55],[-55.05,26.80],[-58.05,8.80],[-56.80,8.80],[-55.80,9.30],[-53.30,9.30],[-53.05,9.05],[-50.80,8.80],[-50.05,8.30],[-48.80,8.05],[-48.30,7.55],[-47.05,7.05],[-46.30,6.30],[-46.05,6.30],[-43.05,3.30],[-43.05,3.05],[-41.80,1.55],[-41.30,0.30],[-40.80,-0.20],[-40.80,-0.70],[-40.05,-1.70],[-40.05,-2.20],[-39.55,-2.95],[-39.55,-3.70],[-39.05,-4.70],[-39.05,-5.45],[-38.80,-5.70],[-38.80,-6.45],[-38.55,-6.70],[-38.55,-7.45],[-38.30,-7.70],[-38.30,-9.45],[-38.05,-9.70],[-38.05,-13.95],[-38.30,-14.20],[-38.30,-15.45],[-38.80,-16.20],[-38.80,-16.95],[-39.55,-17.95],[-39.55,-18.45],[-40.05,-18.95],[-40.55,-19.95],[-42.80,-21.95],[-45.80,-23.45],[-47.30,-23.70],[-48.05,-24.20],[-50.05,-24.20],[-50.30,-24.45],[-51.80,-24.45],[-52.05,-24.20],[-54.05,-24.20],[-54.80,-23.70],[-56.05,-23.45],[-56.55,-22.95],[-57.05,-22.95],[-58.55,-21.70],[-58.80,-21.70],[-61.80,-18.70],[-61.80,-18.45],[-62.55,-17.70],[-62.55,-17.45],[-63.55,-16.20],[-64.80,-13.70],[-64.80,-13.20],[-65.05,-12.95],[-65.05,-12.45],[-65.55,-11.45],[-65.55,-10.70],[-66.05,-9.70],[-66.05,-8.20],[-66.30,-7.95],[-66.30,-6.45],[-66.55,-6.20],[-66.55,-1.95],[-66.30,-1.70],[-66.30,-0.95],[-66.05,-0.70],[-66.05,0.55],[-65.80,0.80],[-65.55,2.05],[-64.80,3.55],[-63.80,4.80],[-63.80,5.05],[-62.55,6.30],[-62.30,6.30],[-61.55,7.05],[-61.30,7.05],[-60.05,8.05],[-59.55,8.05]];
PD_INK_PATHS = [[0,1,2,3,4,5,6,7,8,9,10,11,12,13,14,15,16,17,18,19,20,21,22,23,24,25,26,27,28,29,30,31,32],[33,34,35,36,37,38,39,40,41,42,43,44,45,46,47,48,49,50,51,52,53,54,55,56,57,58,59,60,61,62,63,64,65,66,67],[68,69,70,71,72,73,74,75,76,77,78,79,80,81,82,83,84,85,86,87,88,89,90,91,92,93,94,95,96,97,98,99,100,101,102,103,104,105,106,107,108,109,110,111,112,113,114,115,116,117,118,119,120,121,122,123,124,125,126,127,128,129,130,131,132,133,134,135,136,137,138,139,140,141,142,143,144,145,146,147,148,149,150,151,152,153,154,155,156,157,158,159,160,161,162,163,164,165,166,167,168,169,170,171,172,173,174,175,176,177,178,179,180,181,182,183,184,185,186,187,188,189,190,191,192,193,194,195,196,197,198,199,200,201,202,203,204,205,206,207,208,209,210,211,212,213,214,215,216,217,218,219,220,221,222,223,224,225,226,227,228,229,230,231,232,233,234,235,236,237,238,239,240,241,242,243,244,245,246,247,248,249,250,251,252,253,254,255,256,257,258,259,260,261,262,263,264,265,266,267,268,269,270,271,272,273,274,275,276,277,278,279,280,281,282,283,284,285,286,287,288,289,290,291,292,293,294,295,296,297,298,299,300,301,302,303,304,305,306,307,308,309,310,311,312,313,314,315,316,317,318,319,320,321,322,323,324,325,326,327,328,329,330,331,332,333,334,335,336],[337,338,339,340,341,342,343,344,345,346,347,348,349,350,351,352,353,354,355,356,357,358,359,360,361,362,363,364,365,366,367,368,369,370,371,372,373,374,375,376,377,378,379,380,381,382,383,384,385,386,387,388,389,390,391,392,393,394,395,396,397,398,399,400,401,402,403,404,405,406,407,408,409,410,411,412,413,414,415,416,417,418,419,420,421,422,423],[424,425,426,427,428,429,430,431,432,433,434,435,436,437,438,439,440,441,442,443,444,445,446,447,448,449,450,451,452,453,454,455,456,457,458,459,460,461,462,463,464,465,466,467,468,469,470,471,472,473,474,475,476,477,478,479,480,481,482,483,484,485,486,487,488,489,490,491,492,493,494,495,496,497,498,499,500,501,502,503,504,505,506,507,508,509,510,511,512,513,514,515,516,517,518,519,520,521,522,523,524,525,526,527,528,529,530,531,532,533,534,535,536,537,538,539,540,541,542,543,544,545,546,547,548,549,550,551,552,553,554,555,556,557,558,559,560,561,562,563,564,565,566,567,568,569,570,571,572,573,574,575,576,577,578,579,580,581,582,583,584,585,586,587,588,589,590,591,592,593,594,595,596,597,598,599,600,601,602,603,604,605,606,607,608,609,610,611,612,613,614,615,616,617,618,619,620,621,622,623,624,625,626,627,628,629,630,631,632,633,634,635,636,637,638,639,640,641,642,643,644,645,646,647,648,649,650,651,652,653,654,655,656,657,658,659,660,661,662,663,664,665,666,667,668,669,670,671,672,673,674,675,676,677,678,679,680,681,682,683,684,685,686,687,688,689,690,691,692,693,694,695,696,697,698,699,700,701,702,703,704,705],[706,707,708,709,710,711,712,713,714,715,716,717,718,719,720,721,722,723,724,725,726,727,728,729,730,731,732,733,734,735,736,737,738,739,740,741,742,743,744,745,746,747,748,749,750,751,752,753,754,755,756,757,758,759,760,761,762,763,764,765,766,767,768,769,770,771,772,773,774,775,776,777,778,779,780,781,782,783,784,785,786,787,788,789,790,791,792]];

PD_LIGHT_POINTS = [[68.70,-233.45],[68.70,-235.70],[68.20,-236.20],[68.20,-238.45],[67.95,-238.70],[67.95,-239.45],[68.45,-240.45],[68.45,-241.20],[68.95,-242.20],[68.95,-242.95],[69.20,-243.20],[69.45,-244.45],[69.95,-245.20],[70.70,-244.95],[71.20,-245.45],[71.70,-246.70],[71.95,-246.70],[71.70,-244.70],[71.95,-244.45],[72.70,-244.45],[72.70,-243.45],[72.45,-243.20],[72.45,-239.95],[72.20,-239.70],[70.95,-235.45],[70.70,-235.20],[69.95,-235.45],[69.45,-234.95],[-66.80,-232.95],[-67.30,-233.20],[-68.05,-234.45],[-68.80,-233.95],[-69.30,-234.70],[-69.55,-236.20],[-70.05,-237.20],[-70.05,-237.95],[-70.30,-238.20],[-70.30,-238.70],[-70.80,-239.70],[-70.80,-240.45],[-71.30,-241.45],[-71.30,-242.95],[-70.80,-243.45],[-70.80,-246.70],[-70.30,-246.95],[-69.55,-245.20],[-68.80,-244.45],[-68.30,-244.70],[-67.55,-243.70],[-67.05,-241.20],[-66.30,-239.20],[-66.30,-238.45],[-65.80,-237.45],[-65.55,-235.45],[-66.05,-235.45],[-66.55,-234.95],[-66.55,-233.95],[-66.30,-233.70],[-6.05,-218.95],[-7.30,-218.95],[-7.80,-220.20],[-8.30,-219.95],[-14.80,-219.95],[-15.55,-219.45],[-15.80,-220.45],[-16.30,-221.20],[-19.05,-221.20],[-19.55,-222.70],[-19.80,-222.95],[-20.30,-222.45],[-20.80,-222.45],[-21.30,-223.20],[-21.30,-223.70],[-21.80,-224.20],[-24.55,-224.20],[-25.05,-225.70],[-25.30,-225.95],[-25.80,-225.45],[-26.05,-226.45],[-26.80,-227.45],[-28.05,-227.45],[-28.80,-228.95],[-29.30,-228.70],[-30.80,-228.70],[-31.80,-230.70],[-32.55,-230.20],[-33.05,-230.20],[-33.55,-231.20],[-33.55,-231.70],[-34.05,-232.20],[-35.30,-231.95],[-35.80,-233.20],[-37.05,-233.70],[-37.30,-234.70],[-38.05,-235.70],[-38.55,-235.70],[-39.30,-235.20],[-39.80,-236.70],[-40.05,-236.95],[-40.80,-236.95],[-41.30,-237.70],[-41.30,-238.20],[-42.05,-238.95],[-42.55,-238.45],[-43.05,-238.45],[-43.55,-238.95],[-43.55,-239.45],[-44.30,-240.70],[-44.80,-240.20],[-45.55,-241.70],[-46.05,-242.20],[-46.55,-241.95],[-47.55,-243.70],[-49.05,-243.70],[-49.80,-245.20],[-51.05,-245.70],[-51.80,-247.45],[-52.05,-247.70],[-52.55,-247.45],[-53.05,-247.70],[-53.30,-248.70],[-54.30,-249.95],[-54.30,-250.95],[-54.55,-251.20],[-54.80,-253.20],[-55.05,-253.45],[-55.05,-254.45],[-55.30,-254.70],[-55.30,-259.70],[-54.55,-260.45],[-54.55,-262.70],[-54.30,-262.95],[-53.55,-262.95],[-52.55,-263.70],[-51.55,-263.70],[-51.30,-263.95],[-51.30,-266.95],[-50.80,-267.20],[-50.55,-266.95],[-50.30,-265.95],[-49.55,-264.70],[-49.05,-264.95],[-48.55,-264.70],[-48.30,-262.95],[-48.05,-262.70],[-47.80,-260.20],[-47.55,-259.95],[-47.55,-258.70],[-47.30,-258.45],[-47.30,-257.45],[-47.05,-257.20],[-47.05,-256.20],[-46.80,-255.95],[-46.55,-253.45],[-45.80,-252.20],[-45.05,-252.20],[-44.05,-250.45],[-42.55,-250.70],[-42.05,-249.70],[-42.05,-249.20],[-41.55,-248.45],[-40.80,-248.95],[-39.30,-248.95],[-39.05,-247.95],[-38.30,-246.70],[-37.05,-247.45],[-35.55,-247.45],[-35.05,-246.45],[-35.05,-245.95],[-34.55,-245.45],[-34.05,-245.70],[-32.55,-245.70],[-32.05,-244.95],[-31.80,-243.95],[-31.30,-243.45],[-30.80,-243.45],[-30.05,-244.20],[-28.05,-244.20],[-27.05,-244.95],[-24.55,-244.95],[-24.05,-246.20],[-24.05,-247.20],[-22.55,-247.45],[-22.05,-247.95],[-20.55,-247.95],[-20.30,-248.20],[-20.05,-250.20],[-19.80,-250.45],[-17.55,-250.45],[-16.80,-251.45],[-16.80,-253.20],[-16.55,-253.70],[-15.80,-253.70],[-15.55,-253.95],[-15.55,-258.20],[-15.30,-258.45],[-14.80,-258.45],[-14.30,-258.95],[-14.05,-260.95],[-13.80,-261.20],[-11.55,-261.20],[-11.05,-262.45],[-11.05,-263.45],[-10.80,-263.70],[-10.05,-263.70],[-9.80,-261.95],[-9.30,-261.45],[-8.80,-261.95],[-8.30,-259.95],[-7.80,-259.45],[-7.30,-259.45],[-7.05,-259.20],[-6.80,-257.70],[-6.05,-256.45],[-6.05,-255.45],[-5.80,-255.20],[-5.80,-254.70],[-5.30,-254.20],[-5.30,-253.45],[-5.05,-253.20],[-5.05,-241.70],[-4.80,-241.45],[-4.80,-228.95],[-4.55,-228.70],[-4.55,-220.95],[-4.80,-220.70],[-5.30,-220.70],[-5.80,-220.20],[-5.80,-219.20],[9.70,-215.20],[9.45,-216.70],[9.20,-216.95],[8.70,-216.95],[8.20,-217.95],[8.45,-218.45],[8.45,-221.95],[7.95,-222.70],[7.95,-229.95],[8.20,-230.20],[8.20,-231.20],[7.45,-232.70],[7.45,-236.20],[7.70,-236.45],[7.95,-252.20],[8.20,-252.45],[8.20,-253.95],[8.45,-254.45],[9.20,-254.45],[9.45,-254.70],[9.95,-256.70],[10.70,-256.70],[10.95,-256.45],[11.20,-254.70],[11.45,-254.45],[12.20,-254.45],[12.45,-253.95],[12.45,-252.70],[12.95,-251.95],[13.70,-251.95],[13.95,-252.20],[14.20,-253.45],[14.70,-254.45],[15.20,-254.45],[15.45,-254.20],[15.45,-252.95],[15.70,-252.70],[15.70,-252.20],[15.95,-251.95],[16.70,-251.95],[16.70,-251.45],[16.95,-251.20],[16.95,-249.95],[17.45,-249.45],[17.95,-249.45],[18.20,-249.20],[18.20,-247.95],[18.70,-247.20],[22.20,-247.20],[22.45,-246.95],[22.45,-245.70],[22.95,-244.95],[24.95,-244.95],[25.70,-244.20],[29.95,-244.20],[30.45,-244.70],[30.95,-246.45],[31.70,-246.45],[32.20,-246.95],[32.70,-248.45],[32.95,-248.20],[33.45,-248.20],[33.70,-248.45],[33.95,-249.70],[34.95,-251.20],[35.20,-252.45],[36.45,-252.95],[36.95,-253.95],[36.95,-254.45],[38.20,-256.70],[38.45,-257.70],[39.20,-257.70],[39.95,-258.70],[39.95,-259.70],[40.20,-259.95],[40.45,-262.95],[40.70,-263.20],[40.95,-264.95],[41.20,-265.45],[41.70,-264.95],[42.20,-265.20],[42.20,-265.70],[42.70,-266.45],[42.95,-267.45],[45.45,-267.45],[46.20,-268.70],[46.45,-269.70],[46.95,-269.45],[49.70,-269.45],[49.70,-267.20],[50.70,-266.45],[51.20,-266.95],[51.70,-268.45],[51.95,-268.20],[51.95,-266.20],[52.20,-265.95],[53.95,-265.70],[54.95,-264.95],[55.70,-264.95],[55.95,-264.70],[55.95,-262.70],[56.20,-262.45],[56.95,-262.45],[58.20,-261.45],[58.20,-259.20],[58.45,-258.95],[59.20,-258.95],[59.20,-254.20],[58.95,-253.95],[58.95,-253.20],[58.45,-251.95],[58.20,-249.95],[56.95,-248.20],[56.70,-247.20],[56.45,-246.95],[55.70,-246.95],[55.20,-246.45],[54.95,-245.45],[54.45,-244.70],[53.95,-244.70],[53.70,-244.95],[51.45,-240.70],[50.70,-240.70],[50.20,-240.20],[49.95,-239.20],[49.45,-238.45],[48.95,-238.70],[48.95,-241.20],[48.70,-241.45],[47.95,-240.20],[47.95,-239.70],[46.45,-238.70],[45.70,-237.20],[45.20,-237.45],[44.70,-236.95],[44.20,-235.70],[43.45,-235.70],[43.20,-235.45],[42.45,-233.70],[42.20,-233.45],[40.95,-233.45],[40.45,-232.95],[39.95,-231.70],[39.45,-232.20],[38.95,-231.70],[38.45,-230.20],[37.70,-230.20],[37.20,-229.70],[37.20,-229.20],[36.70,-228.20],[35.95,-228.20],[35.45,-228.70],[34.45,-226.95],[33.20,-226.95],[32.95,-226.70],[32.20,-224.95],[30.95,-224.95],[30.45,-224.45],[30.20,-223.45],[29.95,-223.20],[29.45,-223.45],[28.95,-222.95],[28.70,-221.95],[27.95,-221.95],[27.20,-220.70],[27.20,-220.20],[26.95,-219.95],[26.45,-219.95],[25.95,-219.45],[25.70,-218.45],[25.45,-218.20],[24.95,-218.20],[24.45,-217.70],[24.20,-216.70],[23.95,-216.45],[23.45,-216.45],[22.95,-215.95],[22.70,-214.95],[22.45,-214.70],[21.95,-215.20],[21.70,-214.95],[21.20,-213.45],[19.20,-213.45],[18.45,-211.95],[17.20,-211.95],[17.20,-212.70],[16.70,-213.45],[12.95,-213.45],[12.70,-214.70],[12.20,-215.20],[24.20,-201.45],[23.95,-201.95],[23.95,-202.95],[22.95,-203.45],[22.95,-204.45],[23.20,-204.70],[23.20,-206.70],[23.45,-206.95],[23.45,-207.45],[23.70,-207.70],[24.20,-207.70],[24.70,-208.20],[24.95,-209.20],[25.70,-209.20],[26.70,-210.95],[27.20,-210.95],[27.20,-209.45],[27.95,-208.70],[28.45,-209.20],[28.70,-210.20],[29.95,-210.20],[30.70,-210.95],[30.95,-211.95],[31.70,-211.95],[32.70,-213.70],[33.20,-213.70],[33.70,-214.20],[33.70,-214.70],[33.95,-214.95],[35.20,-214.95],[35.70,-215.45],[36.20,-216.70],[36.95,-216.70],[37.70,-217.95],[38.20,-217.70],[39.20,-219.70],[40.70,-219.70],[41.20,-220.45],[41.45,-221.45],[42.20,-221.20],[42.95,-222.70],[43.70,-222.70],[44.20,-223.20],[44.45,-224.20],[44.70,-224.45],[45.20,-224.45],[45.95,-225.20],[46.20,-225.95],[46.95,-225.95],[47.45,-226.45],[47.95,-227.70],[48.70,-227.70],[49.45,-228.70],[49.95,-231.45],[50.20,-231.70],[50.95,-231.70],[51.95,-233.20],[53.20,-233.20],[53.45,-232.70],[53.20,-231.70],[53.70,-231.20],[54.70,-232.70],[55.20,-232.45],[55.95,-233.45],[55.95,-234.20],[56.20,-234.45],[56.20,-235.20],[56.45,-235.45],[56.45,-236.20],[56.70,-236.45],[56.70,-237.20],[56.95,-237.45],[57.20,-238.70],[57.95,-239.45],[58.45,-240.70],[58.95,-240.70],[59.20,-240.45],[59.70,-240.95],[60.45,-242.70],[61.20,-242.70],[61.20,-240.45],[61.95,-239.70],[61.95,-235.95],[61.45,-234.70],[61.45,-232.95],[61.70,-232.70],[61.45,-232.45],[61.45,-231.45],[61.20,-231.20],[60.95,-229.45],[60.45,-228.45],[60.45,-224.20],[60.70,-223.95],[60.45,-222.95],[60.70,-222.70],[60.70,-220.70],[60.95,-220.45],[60.95,-219.45],[60.70,-219.20],[60.70,-218.70],[60.95,-218.45],[60.95,-216.95],[60.70,-216.70],[60.95,-216.45],[60.95,-214.20],[61.20,-213.95],[61.20,-213.45],[60.95,-213.20],[61.20,-212.70],[61.20,-208.45],[61.45,-208.20],[61.95,-208.20],[61.95,-206.45],[62.45,-205.95],[62.45,-204.95],[62.20,-204.70],[62.20,-203.95],[61.95,-203.70],[61.45,-201.70],[61.20,-201.45],[60.45,-201.45],[59.45,-200.20],[58.95,-200.20],[57.95,-200.95],[56.70,-200.95],[56.70,-202.70],[56.20,-203.20],[56.20,-204.45],[55.95,-204.70],[54.70,-204.95],[54.20,-205.45],[52.95,-205.45],[51.95,-206.20],[51.95,-207.45],[51.70,-207.70],[50.95,-207.70],[49.95,-208.45],[48.95,-208.45],[48.45,-208.95],[46.45,-208.95],[45.45,-209.70],[43.45,-209.70],[42.70,-208.20],[41.95,-208.45],[41.20,-206.95],[40.45,-206.95],[38.95,-204.20],[38.20,-204.20],[37.20,-202.70],[36.20,-202.70],[35.20,-201.20],[34.20,-201.95],[33.70,-201.95],[33.70,-202.70],[33.20,-203.20],[32.70,-202.70],[32.70,-202.20],[32.45,-201.95],[31.70,-201.95],[31.20,-202.45],[27.20,-202.45],[26.70,-202.70],[26.20,-202.20],[25.95,-201.45],[-21.55,-201.95],[-22.05,-201.95],[-22.30,-202.20],[-22.30,-202.70],[-22.80,-203.20],[-23.30,-202.70],[-25.05,-202.70],[-25.55,-202.45],[-25.80,-203.20],[-26.30,-203.70],[-28.30,-203.70],[-28.80,-203.20],[-30.30,-203.20],[-30.55,-202.95],[-30.55,-201.95],[-31.05,-200.95],[-31.55,-201.95],[-32.05,-202.45],[-32.55,-202.45],[-32.80,-202.70],[-33.30,-205.20],[-33.80,-205.70],[-34.30,-205.45],[-34.55,-205.70],[-34.55,-206.20],[-35.05,-206.70],[-35.30,-206.45],[-35.30,-205.45],[-35.55,-204.95],[-36.30,-204.45],[-36.80,-204.95],[-36.80,-205.45],[-37.30,-205.95],[-37.80,-205.95],[-38.80,-207.20],[-39.30,-207.20],[-40.05,-208.45],[-41.80,-207.95],[-42.80,-209.20],[-43.30,-209.20],[-43.55,-208.95],[-43.55,-207.70],[-43.80,-207.70],[-44.55,-208.70],[-45.30,-207.95],[-46.55,-207.95],[-48.30,-206.45],[-49.30,-206.45],[-50.80,-205.20],[-52.05,-205.20],[-52.55,-204.70],[-53.05,-204.70],[-53.80,-203.95],[-53.80,-202.45],[-56.05,-200.95],[-57.30,-200.95],[-58.30,-200.20],[-59.30,-201.45],[-59.55,-201.20],[-60.30,-201.95],[-60.30,-202.70],[-61.30,-205.45],[-61.30,-205.95],[-61.05,-206.20],[-61.05,-212.70],[-60.55,-212.95],[-60.55,-214.45],[-60.80,-214.70],[-61.05,-216.45],[-60.30,-216.95],[-60.30,-219.20],[-59.80,-219.20],[-59.55,-219.45],[-59.55,-221.70],[-59.05,-221.95],[-58.80,-225.45],[-59.30,-226.45],[-59.30,-227.20],[-59.55,-227.45],[-59.55,-228.20],[-60.05,-229.45],[-60.05,-231.45],[-59.80,-231.70],[-60.05,-231.95],[-60.05,-232.70],[-59.80,-232.95],[-59.80,-238.20],[-59.30,-238.20],[-59.05,-238.45],[-59.05,-240.95],[-58.05,-241.95],[-56.80,-239.70],[-56.05,-239.70],[-55.55,-239.20],[-55.55,-238.70],[-54.80,-237.95],[-54.30,-238.45],[-53.80,-237.20],[-53.30,-236.70],[-52.55,-236.70],[-51.30,-234.45],[-50.80,-234.95],[-49.80,-233.45],[-49.30,-233.95],[-48.80,-233.20],[-48.55,-232.20],[-48.05,-231.70],[-47.30,-231.70],[-46.55,-230.20],[-46.05,-230.20],[-45.80,-230.45],[-44.80,-228.45],[-44.30,-228.45],[-44.05,-228.70],[-43.55,-227.45],[-43.05,-226.95],[-42.55,-227.20],[-41.55,-225.70],[-40.30,-225.70],[-39.30,-224.20],[-38.80,-224.45],[-38.05,-222.70],[-37.80,-222.45],[-37.55,-222.70],[-37.05,-222.70],[-36.80,-221.70],[-36.30,-221.20],[-35.05,-221.20],[-34.05,-219.45],[-33.55,-219.95],[-33.05,-218.70],[-32.55,-218.20],[-32.05,-218.20],[-31.80,-217.95],[-31.55,-216.95],[-31.05,-216.45],[-30.55,-216.70],[-30.30,-216.45],[-30.30,-215.95],[-29.55,-215.20],[-28.30,-215.20],[-27.80,-213.70],[-27.55,-213.45],[-27.05,-213.70],[-26.30,-212.45],[-25.80,-212.45],[-25.30,-211.95],[-25.05,-210.95],[-24.80,-210.70],[-24.05,-210.70],[-24.05,-210.20],[-23.55,-209.45],[-22.30,-209.70],[-21.80,-208.45],[-21.30,-207.95],[-20.80,-207.95],[-20.55,-207.45],[-20.55,-205.95],[-20.30,-205.70],[-20.30,-203.45],[-20.80,-203.45],[-21.30,-202.95],[-21.30,-202.20],[111.45,-199.95],[111.70,-200.95],[111.45,-201.20],[111.20,-200.95],[109.95,-200.95],[109.95,-201.70],[110.20,-201.95],[109.95,-202.20],[109.45,-201.95],[106.95,-201.95],[107.45,-202.70],[107.20,-203.20],[105.45,-202.95],[105.70,-204.45],[105.45,-204.70],[103.70,-204.70],[103.45,-204.95],[103.70,-205.20],[103.70,-206.20],[103.45,-206.45],[102.70,-205.95],[102.95,-207.45],[101.70,-208.45],[100.95,-208.45],[101.20,-208.95],[101.20,-209.95],[100.95,-210.20],[99.95,-210.20],[99.70,-210.45],[99.95,-210.70],[99.95,-211.95],[99.70,-212.20],[98.70,-212.20],[98.95,-214.45],[98.70,-214.70],[98.20,-214.70],[98.45,-215.20],[98.45,-216.45],[98.20,-216.70],[97.70,-216.70],[97.70,-217.20],[97.95,-217.45],[97.95,-218.95],[97.45,-219.45],[97.45,-220.20],[98.20,-221.45],[98.20,-221.95],[99.20,-223.70],[99.45,-224.70],[100.20,-225.45],[100.70,-224.95],[102.20,-226.70],[102.95,-226.70],[102.70,-224.95],[103.95,-223.95],[104.70,-223.95],[104.45,-221.95],[104.70,-221.70],[106.70,-221.70],[106.45,-219.95],[106.70,-219.70],[107.20,-219.70],[107.70,-219.20],[107.45,-217.20],[107.70,-216.95],[108.20,-216.95],[107.70,-215.70],[107.95,-215.45],[108.45,-215.70],[109.95,-217.70],[110.70,-217.70],[110.45,-215.95],[110.70,-215.70],[111.95,-215.70],[111.95,-215.20],[111.70,-214.95],[111.70,-213.95],[111.95,-213.70],[112.95,-213.95],[112.45,-212.70],[112.70,-212.45],[113.20,-212.70],[112.95,-211.20],[113.20,-210.95],[114.70,-212.70],[114.20,-210.95],[114.45,-210.70],[114.95,-211.20],[114.70,-210.95],[114.45,-209.70],[114.70,-209.45],[115.20,-209.45],[116.20,-210.45],[116.20,-210.70],[116.95,-211.45],[117.70,-211.70],[119.70,-213.95],[120.45,-213.95],[121.70,-215.20],[123.95,-219.20],[123.95,-220.45],[124.45,-221.45],[124.45,-221.95],[124.20,-222.20],[123.70,-222.20],[124.20,-223.45],[123.95,-223.70],[122.95,-223.45],[122.95,-224.20],[123.20,-224.45],[123.20,-225.20],[122.70,-225.45],[123.20,-226.45],[122.95,-226.95],[121.20,-224.95],[119.45,-224.95],[118.45,-224.20],[117.95,-224.20],[118.20,-225.95],[117.95,-226.20],[117.45,-226.20],[117.45,-226.95],[117.95,-228.20],[117.70,-228.45],[116.95,-228.45],[117.45,-229.70],[117.45,-230.45],[117.20,-230.70],[116.70,-230.70],[116.70,-231.45],[119.20,-236.45],[119.95,-237.20],[120.70,-237.20],[121.70,-238.20],[122.70,-239.70],[125.95,-239.70],[125.95,-239.20],[125.45,-238.20],[125.70,-237.70],[126.70,-238.20],[129.20,-238.20],[128.70,-237.20],[128.70,-236.70],[128.95,-236.45],[130.70,-236.45],[130.95,-236.70],[131.45,-236.70],[130.70,-235.20],[130.95,-234.95],[133.20,-234.95],[133.45,-235.20],[132.95,-233.95],[133.20,-233.45],[133.95,-233.45],[134.95,-234.20],[134.45,-232.20],[134.70,-231.95],[135.45,-231.95],[136.45,-232.45],[135.95,-230.95],[136.20,-230.70],[136.95,-230.70],[137.20,-230.95],[136.70,-229.95],[136.70,-229.45],[136.95,-229.20],[137.95,-229.20],[138.45,-229.70],[137.95,-227.95],[138.20,-227.70],[138.70,-227.70],[139.20,-228.20],[138.70,-226.70],[138.95,-226.45],[139.70,-226.45],[139.95,-226.70],[139.45,-225.45],[139.70,-225.20],[140.20,-225.20],[140.45,-225.45],[139.95,-224.45],[139.95,-223.95],[140.20,-223.70],[140.70,-223.70],[139.95,-222.20],[140.20,-221.70],[140.45,-221.95],[139.95,-220.70],[140.20,-220.45],[140.70,-220.45],[140.20,-219.45],[140.45,-218.70],[139.95,-217.70],[140.45,-217.45],[139.95,-216.70],[139.95,-215.95],[139.45,-215.20],[139.45,-214.45],[139.95,-214.20],[139.95,-213.70],[135.45,-206.70],[134.45,-205.70],[133.70,-205.70],[130.95,-203.20],[130.20,-203.20],[129.70,-202.70],[129.20,-202.70],[127.70,-201.20],[127.95,-201.70],[127.45,-201.95],[125.95,-200.45],[125.20,-200.45],[124.20,-199.70],[123.70,-199.70],[123.95,-200.20],[123.70,-200.70],[122.70,-200.70],[121.70,-199.95],[120.45,-199.95],[119.95,-199.45],[118.95,-199.45],[118.70,-199.20],[118.45,-199.20],[118.95,-200.20],[118.70,-200.45],[117.45,-200.20],[116.95,-199.70],[114.95,-199.70],[114.70,-199.45],[114.95,-199.95],[114.95,-200.45],[114.70,-200.70],[114.20,-200.70],[113.20,-199.95],[-104.55,-200.95],[-106.05,-201.95],[-106.30,-201.45],[-105.80,-200.70],[-106.30,-200.70],[-106.80,-201.20],[-108.05,-201.20],[-108.30,-200.95],[-107.80,-199.95],[-108.30,-200.45],[-108.80,-200.45],[-109.30,-200.95],[-109.80,-200.95],[-110.05,-200.45],[-109.55,-199.70],[-109.80,-199.95],[-110.80,-199.95],[-111.55,-200.45],[-111.80,-200.20],[-111.55,-199.20],[-113.30,-200.20],[-114.05,-200.20],[-114.30,-200.45],[-114.80,-200.20],[-114.55,-199.20],[-116.55,-200.20],[-117.05,-200.70],[-118.80,-200.70],[-119.05,-200.45],[-118.55,-199.45],[-118.80,-199.70],[-119.55,-199.70],[-121.30,-201.45],[-121.80,-201.20],[-121.30,-200.45],[-122.80,-201.95],[-124.80,-201.95],[-126.05,-203.45],[-126.80,-203.45],[-128.55,-205.20],[-129.30,-205.20],[-131.55,-207.20],[-133.05,-209.45],[-133.30,-210.20],[-134.80,-212.20],[-135.05,-213.45],[-135.30,-213.70],[-135.30,-214.45],[-135.80,-215.45],[-135.80,-216.20],[-136.05,-216.45],[-136.05,-217.45],[-136.55,-218.45],[-136.55,-218.95],[-136.05,-219.20],[-136.05,-219.95],[-136.55,-220.95],[-136.05,-220.95],[-135.80,-221.20],[-136.30,-222.95],[-135.80,-222.95],[-135.55,-223.20],[-135.55,-223.70],[-136.05,-224.70],[-135.30,-224.20],[-134.80,-224.45],[-135.30,-225.45],[-135.30,-226.20],[-134.80,-226.45],[-134.80,-226.95],[-135.30,-227.95],[-134.80,-227.45],[-133.55,-227.45],[-133.30,-227.70],[-133.30,-228.20],[-133.80,-228.95],[-133.80,-229.45],[-133.05,-228.95],[-132.80,-229.20],[-132.80,-229.70],[-133.30,-230.45],[-132.80,-230.20],[-132.30,-230.20],[-132.05,-230.45],[-132.80,-231.70],[-131.55,-231.70],[-131.05,-231.45],[-130.80,-231.95],[-131.30,-232.95],[-130.30,-232.20],[-130.05,-232.45],[-130.55,-234.20],[-129.80,-233.70],[-128.55,-233.70],[-128.30,-233.45],[-128.05,-233.95],[-128.55,-234.70],[-128.55,-235.20],[-127.55,-234.45],[-127.05,-234.45],[-126.80,-234.70],[-126.80,-235.20],[-127.30,-236.20],[-127.05,-235.95],[-126.05,-235.95],[-125.80,-235.70],[-125.30,-235.95],[-125.80,-236.95],[-125.80,-237.45],[-125.30,-237.45],[-124.80,-236.95],[-123.55,-236.45],[-123.30,-236.95],[-123.80,-237.70],[-123.80,-238.20],[-123.30,-238.20],[-122.55,-237.45],[-121.30,-237.45],[-121.05,-237.95],[-121.55,-238.70],[-121.55,-239.20],[-121.30,-238.95],[-120.05,-238.95],[-119.55,-238.70],[-118.55,-236.70],[-116.30,-234.95],[-114.05,-230.45],[-113.80,-229.20],[-114.05,-229.45],[-114.55,-229.20],[-114.55,-228.70],[-114.05,-227.70],[-114.30,-227.95],[-115.30,-227.95],[-115.55,-227.70],[-115.05,-226.20],[-115.30,-226.45],[-116.30,-226.45],[-116.55,-226.70],[-117.05,-226.45],[-116.55,-225.20],[-117.05,-225.20],[-117.30,-224.95],[-116.80,-223.70],[-117.30,-223.45],[-116.80,-222.20],[-117.80,-222.45],[-119.30,-223.95],[-120.05,-225.20],[-120.80,-225.20],[-121.05,-224.95],[-120.55,-223.70],[-121.05,-223.45],[-120.80,-222.20],[-121.05,-222.45],[-121.30,-221.95],[-120.80,-220.70],[-121.05,-220.95],[-121.30,-220.70],[-121.30,-220.20],[-120.80,-219.45],[-121.30,-219.45],[-121.55,-219.20],[-121.55,-218.70],[-119.05,-214.20],[-116.80,-211.70],[-116.05,-211.45],[-114.55,-209.20],[-114.05,-209.20],[-113.55,-208.70],[-113.05,-208.70],[-112.80,-208.45],[-112.30,-208.70],[-112.55,-209.70],[-111.80,-209.70],[-111.05,-209.20],[-110.80,-209.45],[-111.05,-209.95],[-111.05,-210.70],[-110.80,-210.95],[-111.05,-211.95],[-110.80,-211.70],[-110.30,-211.95],[-110.80,-212.95],[-110.30,-212.95],[-109.80,-212.45],[-109.30,-212.45],[-107.55,-210.45],[-107.30,-210.95],[-107.80,-211.95],[-107.55,-211.70],[-106.80,-211.70],[-106.55,-211.95],[-106.55,-212.70],[-106.80,-212.95],[-106.80,-213.20],[-106.55,-212.95],[-106.30,-213.20],[-106.55,-214.70],[-106.05,-214.70],[-105.80,-214.95],[-106.30,-216.20],[-106.30,-216.95],[-106.55,-217.20],[-106.55,-217.95],[-106.05,-217.95],[-105.80,-218.20],[-105.80,-218.70],[-106.05,-218.95],[-106.05,-219.95],[-105.80,-219.70],[-105.55,-219.95],[-105.80,-221.20],[-104.80,-221.20],[-104.55,-221.45],[-104.55,-222.70],[-104.80,-223.20],[-104.30,-222.70],[-104.05,-222.95],[-104.30,-224.20],[-104.55,-224.45],[-104.55,-224.70],[-104.05,-224.70],[-103.80,-224.95],[-103.80,-226.20],[-104.05,-226.70],[-103.05,-226.70],[-102.80,-226.45],[-102.55,-226.70],[-102.55,-227.20],[-103.05,-228.20],[-102.30,-228.20],[-102.05,-228.45],[-102.30,-229.70],[-103.30,-231.45],[-103.30,-232.20],[-103.55,-232.45],[-103.55,-232.70],[-102.80,-232.70],[-102.55,-232.95],[-102.55,-233.45],[-102.80,-233.70],[-102.80,-234.95],[-101.30,-234.95],[-100.55,-233.70],[-99.55,-232.70],[-98.80,-232.70],[-98.05,-231.45],[-96.30,-229.45],[-96.05,-228.45],[-95.55,-227.70],[-95.55,-227.20],[-94.55,-225.20],[-94.55,-223.20],[-93.55,-221.20],[-93.55,-220.45],[-93.30,-220.20],[-93.55,-219.95],[-93.55,-219.20],[-93.30,-218.95],[-93.30,-215.95],[-93.80,-215.95],[-94.05,-215.70],[-93.80,-213.95],[-94.30,-213.95],[-94.55,-213.70],[-94.30,-212.20],[-94.80,-212.20],[-95.05,-211.95],[-95.05,-210.45],[-95.80,-210.95],[-96.05,-210.70],[-96.05,-209.20],[-97.05,-209.20],[-97.30,-208.95],[-97.30,-207.95],[-97.05,-207.45],[-97.55,-207.95],[-98.05,-207.95],[-98.30,-207.70],[-98.30,-206.70],[-98.05,-206.20],[-98.80,-206.20],[-99.05,-206.45],[-99.30,-206.20],[-99.05,-205.20],[-100.30,-205.20],[-100.55,-204.95],[-100.30,-203.95],[-101.30,-203.95],[-101.80,-204.20],[-102.05,-203.70],[-101.55,-202.95],[-102.80,-202.95],[-103.30,-203.45],[-103.55,-202.95],[-103.05,-201.95],[-103.80,-201.95],[-104.55,-202.45],[-104.80,-202.20],[37.95,-185.95],[37.70,-186.20],[37.45,-187.45],[37.20,-187.70],[36.70,-187.70],[36.70,-188.70],[36.95,-188.95],[36.70,-191.45],[36.95,-191.70],[36.95,-192.70],[37.20,-192.95],[37.20,-193.95],[37.45,-194.20],[37.45,-195.20],[37.95,-195.95],[38.45,-195.95],[38.95,-196.45],[39.20,-197.20],[39.45,-197.45],[39.70,-197.20],[40.45,-198.20],[40.70,-198.20],[40.70,-196.95],[40.95,-196.70],[42.95,-196.70],[43.20,-196.45],[43.70,-196.95],[43.95,-197.70],[45.45,-197.70],[45.70,-197.45],[45.70,-195.95],[46.45,-195.45],[46.45,-194.45],[46.20,-194.20],[45.70,-191.70],[44.45,-191.20],[43.95,-189.20],[43.20,-189.20],[42.70,-188.70],[42.45,-187.95],[41.20,-187.95],[40.45,-186.95],[38.70,-186.95],[38.20,-185.95],[-35.80,-185.70],[-36.05,-186.45],[-36.55,-186.95],[-37.55,-186.70],[-38.30,-187.70],[-38.80,-187.70],[-39.30,-188.20],[-40.05,-189.45],[-40.05,-190.20],[-40.55,-191.45],[-40.55,-192.45],[-40.80,-192.70],[-40.80,-193.70],[-41.05,-194.20],[-40.05,-194.95],[-40.05,-196.20],[-38.80,-196.95],[-38.80,-198.20],[-38.55,-198.45],[-38.30,-198.45],[-37.55,-197.45],[-37.05,-197.45],[-35.80,-195.70],[-35.80,-194.45],[-35.55,-194.20],[-35.55,-193.20],[-35.30,-192.95],[-35.30,-191.70],[-35.05,-191.45],[-35.05,-190.45],[-34.80,-190.20],[-34.80,-189.20],[-34.55,-188.95],[-34.55,-188.20],[-35.30,-187.20],[-35.30,-186.20],[4.95,-177.70],[4.70,-177.95],[4.70,-178.45],[4.20,-178.95],[3.70,-178.95],[3.70,-183.45],[4.70,-183.95],[4.95,-184.95],[6.70,-184.95],[6.95,-183.95],[7.20,-183.70],[7.70,-183.70],[7.95,-183.20],[7.95,-182.45],[7.70,-182.20],[7.70,-179.20],[6.70,-178.70],[6.45,-177.70],[-3.80,-177.70],[-4.05,-178.70],[-5.05,-179.20],[-5.05,-183.70],[-4.55,-183.70],[-4.05,-184.20],[-4.05,-184.70],[-3.80,-184.95],[-1.80,-184.95],[-1.55,-184.70],[-1.55,-184.20],[-1.05,-183.70],[-0.55,-183.70],[-0.55,-178.95],[-1.05,-178.95],[-1.55,-178.45],[-1.55,-177.95],[-1.80,-177.70],[23.45,-170.95],[23.20,-171.95],[22.70,-172.20],[22.95,-176.20],[23.20,-176.70],[23.70,-176.45],[24.20,-176.95],[24.20,-177.45],[24.45,-177.45],[24.45,-176.70],[24.70,-176.45],[25.70,-176.45],[25.95,-176.20],[25.95,-175.45],[26.20,-175.20],[26.70,-175.20],[26.70,-173.70],[26.45,-173.45],[26.45,-172.45],[26.20,-171.95],[25.70,-171.95],[24.95,-170.95],[-20.05,-170.95],[-21.05,-170.95],[-21.55,-171.70],[-22.05,-171.70],[-22.80,-172.70],[-23.30,-172.70],[-23.55,-172.95],[-23.80,-175.95],[-23.30,-175.95],[-23.05,-176.20],[-22.80,-177.20],[-22.30,-177.20],[-21.80,-176.45],[-21.30,-177.70],[-20.80,-177.70],[-20.55,-176.95],[-19.55,-176.45],[-19.30,-172.45],[-20.05,-171.70],[12.45,-165.45],[12.45,-165.95],[11.45,-166.70],[11.45,-168.70],[11.70,-168.95],[11.70,-169.45],[12.20,-169.45],[12.70,-169.95],[12.70,-170.45],[12.95,-170.45],[12.95,-169.95],[13.95,-169.20],[13.95,-168.45],[13.70,-168.20],[13.70,-166.70],[13.45,-166.45],[12.95,-166.45],[-1.30,-159.45],[-1.55,-159.95],[-2.55,-160.70],[-2.55,-165.20],[-2.05,-165.20],[-1.55,-166.20],[-1.05,-166.20],[-0.55,-165.20],[3.45,-165.20],[3.95,-166.20],[4.20,-165.95],[4.20,-165.45],[4.45,-165.20],[4.95,-165.20],[4.95,-161.70],[4.45,-161.45],[3.70,-160.45],[-0.55,-160.45],[-1.05,-159.45],[-74.05,-158.95],[-74.80,-159.45],[-75.80,-159.45],[-77.55,-161.20],[-78.80,-163.95],[-78.55,-163.70],[-78.30,-163.95],[-78.30,-166.95],[-78.05,-166.70],[-77.80,-166.95],[-78.05,-167.45],[-77.80,-167.95],[-78.05,-168.95],[-77.55,-168.95],[-77.30,-169.20],[-77.30,-170.70],[-77.55,-170.95],[-77.05,-171.20],[-77.05,-171.95],[-76.55,-171.95],[-76.30,-172.20],[-76.30,-172.70],[-76.55,-172.95],[-76.30,-173.20],[-76.30,-174.45],[-75.80,-174.70],[-75.80,-175.70],[-75.30,-175.70],[-75.05,-175.95],[-75.05,-177.20],[-74.55,-177.45],[-74.55,-178.45],[-74.05,-178.45],[-73.80,-178.70],[-73.80,-179.70],[-72.80,-180.45],[-72.80,-181.70],[-71.80,-181.70],[-71.55,-181.95],[-71.55,-183.20],[-71.30,-183.45],[-68.80,-183.95],[-68.30,-184.45],[-68.30,-185.70],[-67.80,-185.70],[-67.30,-186.20],[-66.30,-184.95],[-65.55,-184.95],[-65.30,-184.70],[-64.30,-181.95],[-64.30,-180.95],[-64.80,-180.95],[-65.05,-180.70],[-64.80,-179.45],[-65.30,-178.95],[-65.55,-176.45],[-66.05,-175.95],[-66.05,-174.70],[-66.80,-175.70],[-67.05,-175.45],[-67.05,-174.70],[-67.80,-173.95],[-67.55,-173.70],[-67.55,-172.70],[-68.05,-172.70],[-68.30,-172.45],[-68.30,-168.95],[-68.80,-168.45],[-68.80,-167.20],[-69.05,-166.95],[-68.80,-166.70],[-68.80,-166.20],[-69.30,-166.20],[-69.55,-165.95],[-69.55,-163.95],[-69.05,-163.20],[-69.05,-162.70],[-69.55,-162.70],[-69.80,-162.45],[-69.80,-161.70],[-70.80,-161.70],[-71.80,-162.70],[-72.30,-162.70],[-72.55,-162.45],[-72.55,-161.70],[-73.05,-161.45],[-73.05,-160.95],[-72.55,-160.20],[-72.55,-159.95],[-73.05,-159.70],[-72.80,-159.20],[-73.05,-158.95],[76.70,-158.45],[75.20,-158.45],[75.20,-159.20],[74.70,-159.45],[74.70,-161.95],[74.20,-162.20],[74.20,-162.95],[73.95,-163.20],[73.45,-163.20],[72.70,-162.45],[72.20,-162.70],[72.20,-163.20],[72.45,-163.45],[71.70,-163.95],[71.95,-165.20],[71.20,-165.70],[71.45,-166.45],[70.95,-166.70],[70.95,-169.95],[70.45,-170.20],[70.45,-171.20],[69.95,-171.70],[70.20,-173.20],[69.70,-173.70],[69.70,-174.70],[69.45,-174.95],[68.45,-173.70],[68.20,-173.95],[68.20,-175.70],[67.70,-176.20],[67.95,-176.70],[67.95,-177.70],[67.45,-177.95],[67.45,-179.45],[66.95,-179.70],[66.95,-181.20],[66.45,-181.70],[66.45,-182.45],[67.45,-185.20],[67.70,-185.45],[68.20,-185.20],[69.45,-186.45],[70.45,-185.70],[70.95,-185.70],[72.45,-184.20],[72.45,-182.95],[72.70,-182.70],[73.20,-182.70],[74.45,-181.45],[74.45,-180.20],[74.70,-179.95],[75.20,-179.95],[76.20,-178.95],[76.45,-178.95],[76.45,-178.20],[76.20,-177.95],[76.95,-177.45],[76.70,-175.95],[76.95,-175.70],[77.45,-175.70],[77.20,-174.70],[78.45,-173.70],[78.20,-173.45],[78.20,-172.70],[78.45,-172.45],[78.95,-172.45],[78.70,-171.20],[79.20,-170.95],[79.20,-168.45],[79.45,-168.20],[79.95,-168.20],[79.70,-167.95],[79.70,-167.20],[79.95,-166.95],[79.70,-166.70],[79.70,-166.20],[79.95,-165.95],[79.70,-164.95],[79.95,-164.70],[80.45,-164.70],[80.20,-163.45],[80.70,-163.20],[80.70,-162.70],[79.95,-161.45],[79.70,-160.45],[78.95,-159.95],[78.45,-159.20],[77.95,-159.20],[77.70,-159.45],[-125.80,-154.95],[-126.80,-154.95],[-128.05,-155.95],[-128.30,-155.70],[-128.80,-155.70],[-133.05,-160.70],[-133.05,-160.95],[-135.05,-162.45],[-135.05,-162.70],[-136.30,-163.95],[-137.55,-165.70],[-137.05,-166.20],[-137.55,-167.45],[-136.30,-167.45],[-136.05,-167.70],[-136.30,-168.70],[-134.55,-168.70],[-133.80,-169.45],[-134.05,-170.20],[-133.30,-170.45],[-132.80,-170.95],[-131.30,-170.95],[-131.05,-171.20],[-131.55,-172.20],[-130.80,-172.70],[-129.80,-172.70],[-129.55,-172.95],[-128.80,-172.20],[-127.55,-171.95],[-125.30,-168.95],[-125.30,-168.20],[-125.05,-167.95],[-125.30,-166.45],[-125.05,-165.95],[-125.30,-165.95],[-125.55,-165.45],[-125.30,-165.20],[-124.80,-163.20],[-125.30,-162.95],[-125.05,-162.20],[-125.55,-161.95],[-125.30,-161.45],[-125.30,-160.95],[-125.55,-160.70],[-125.30,-159.45],[-125.80,-159.20],[-125.30,-158.45],[-125.80,-158.20],[-125.55,-156.95],[-126.05,-156.70],[-125.55,-155.95],[-126.05,-155.70],[-126.05,-155.20],[-17.05,-150.45],[-17.30,-150.45],[-17.80,-151.20],[-18.30,-151.20],[-18.30,-151.70],[-18.55,-151.95],[-18.55,-153.95],[-18.80,-154.20],[-17.55,-155.70],[-17.30,-155.70],[-17.30,-155.45],[-16.30,-154.70],[-16.30,-153.45],[-16.05,-153.20],[-16.05,-151.70],[-16.55,-151.70],[-16.80,-151.45],[-16.80,-150.70],[21.95,-146.20],[21.70,-146.45],[21.70,-146.95],[21.45,-147.20],[20.95,-147.20],[21.45,-149.45],[25.20,-154.45],[26.45,-156.70],[27.45,-157.70],[27.70,-158.95],[28.20,-159.45],[28.45,-160.20],[29.20,-161.20],[29.70,-161.20],[30.20,-161.95],[30.70,-162.20],[31.20,-161.70],[31.20,-161.20],[31.95,-160.70],[31.95,-159.45],[31.70,-159.20],[31.45,-157.45],[29.95,-155.20],[28.95,-154.20],[28.95,-153.45],[27.45,-151.20],[26.95,-151.20],[26.45,-150.70],[26.20,-149.45],[25.20,-148.45],[24.20,-146.95],[22.95,-145.95],[22.70,-146.20],[-188.55,-146.95],[-188.30,-147.95],[-189.55,-149.45],[-188.30,-150.95],[-188.05,-151.70],[-187.05,-152.70],[-187.05,-153.20],[-185.80,-154.45],[-185.80,-155.20],[-185.30,-155.70],[-185.30,-156.20],[-184.80,-156.70],[-184.55,-157.45],[-183.80,-156.95],[-183.30,-157.20],[-184.05,-158.20],[-184.05,-158.70],[-183.80,-158.95],[-182.30,-158.20],[-181.55,-159.20],[-181.55,-159.70],[-181.05,-160.20],[-180.80,-161.70],[-180.30,-162.20],[-180.30,-162.95],[-180.05,-163.20],[-179.55,-163.20],[-178.55,-162.45],[-177.30,-163.95],[-177.30,-165.70],[-177.05,-165.95],[-176.55,-165.95],[-175.55,-165.45],[-174.30,-166.70],[-174.05,-167.20],[-174.05,-168.45],[-173.55,-167.95],[-172.80,-167.70],[-172.30,-168.20],[-172.05,-168.95],[-171.05,-169.95],[-171.05,-170.45],[-170.55,-170.95],[-170.05,-170.45],[-169.30,-170.20],[-168.30,-171.20],[-168.05,-172.20],[-166.80,-173.70],[-166.55,-173.70],[-165.55,-174.70],[-164.55,-174.95],[-163.05,-175.95],[-162.05,-175.95],[-161.80,-176.20],[-162.55,-177.20],[-162.05,-177.20],[-161.05,-177.95],[-159.55,-177.95],[-159.30,-178.45],[-159.80,-179.20],[-157.80,-179.20],[-157.55,-179.70],[-158.05,-180.45],[-156.05,-180.45],[-155.80,-180.70],[-155.80,-181.20],[-156.30,-181.95],[-154.55,-181.95],[-153.30,-180.70],[-152.05,-180.45],[-149.30,-177.45],[-149.05,-176.45],[-148.55,-175.70],[-148.55,-175.20],[-148.05,-174.45],[-148.05,-173.70],[-147.55,-173.20],[-147.55,-172.45],[-147.05,-171.95],[-147.55,-171.95],[-147.80,-171.70],[-147.30,-170.95],[-147.30,-170.70],[-147.80,-170.45],[-147.30,-169.45],[-149.30,-169.45],[-149.55,-169.20],[-149.05,-168.20],[-150.30,-168.20],[-150.55,-167.95],[-150.30,-167.20],[-151.30,-167.20],[-151.80,-166.70],[-152.55,-166.70],[-152.80,-166.45],[-152.30,-165.45],[-153.05,-165.45],[-153.55,-164.95],[-154.05,-164.95],[-154.55,-164.45],[-155.05,-164.45],[-156.05,-163.45],[-156.30,-163.45],[-158.05,-161.45],[-158.05,-160.95],[-159.05,-159.95],[-159.80,-160.45],[-160.30,-160.45],[-160.80,-159.45],[-161.80,-158.45],[-161.80,-157.95],[-162.30,-157.20],[-162.80,-157.20],[-163.30,-157.70],[-163.55,-157.45],[-163.55,-156.70],[-164.55,-155.70],[-164.55,-155.20],[-165.80,-155.95],[-166.30,-155.45],[-166.30,-153.95],[-167.05,-153.20],[-167.55,-153.20],[-168.30,-153.70],[-168.80,-153.20],[-169.55,-151.45],[-170.05,-151.45],[-170.80,-151.95],[-171.55,-150.70],[-171.55,-150.20],[-172.05,-149.45],[-173.30,-150.20],[-174.30,-149.20],[-174.30,-148.20],[-174.80,-147.70],[-176.05,-148.45],[-176.80,-147.45],[-176.80,-146.70],[-177.05,-146.45],[-178.80,-147.20],[-179.30,-146.45],[-179.30,-145.95],[-180.30,-144.95],[-180.80,-144.95],[-181.55,-145.45],[-182.80,-144.20],[-183.30,-144.20],[-184.05,-144.70],[-185.05,-144.20],[-42.55,-144.45],[-43.55,-144.45],[-44.05,-143.95],[-44.80,-144.70],[-45.30,-144.45],[-45.80,-145.20],[-46.30,-145.20],[-47.05,-144.70],[-47.80,-145.70],[-48.30,-145.45],[-49.80,-146.45],[-50.55,-146.45],[-51.05,-147.20],[-51.80,-147.20],[-52.30,-147.70],[-52.80,-147.70],[-54.30,-149.20],[-54.80,-149.20],[-55.55,-149.95],[-56.05,-149.70],[-56.80,-150.45],[-57.30,-150.45],[-58.05,-151.45],[-58.55,-151.20],[-59.30,-151.95],[-60.05,-151.95],[-60.80,-152.95],[-61.30,-152.95],[-61.55,-153.20],[-62.30,-155.20],[-62.80,-155.70],[-63.30,-155.45],[-64.55,-156.70],[-65.05,-157.70],[-65.05,-158.20],[-65.55,-158.95],[-65.55,-159.20],[-65.05,-159.20],[-64.80,-159.45],[-64.80,-160.20],[-65.05,-160.45],[-64.80,-160.95],[-64.80,-161.95],[-64.30,-162.20],[-64.30,-162.95],[-63.80,-162.95],[-63.55,-163.20],[-63.80,-164.45],[-63.05,-165.20],[-63.30,-165.70],[-62.55,-166.20],[-62.55,-167.20],[-62.05,-167.70],[-62.05,-168.95],[-61.80,-169.45],[-62.30,-170.20],[-62.30,-171.20],[-61.80,-171.70],[-61.80,-172.95],[-61.30,-173.20],[-61.30,-174.45],[-60.80,-174.95],[-59.80,-174.95],[-59.30,-175.20],[-58.55,-175.95],[-58.80,-176.20],[-58.80,-176.95],[-58.55,-177.20],[-57.05,-177.45],[-56.55,-178.20],[-56.55,-179.20],[-56.05,-179.20],[-55.55,-179.70],[-55.05,-179.70],[-54.30,-178.70],[-53.80,-178.95],[-53.30,-178.20],[-53.30,-177.70],[-52.55,-176.45],[-51.80,-176.45],[-51.30,-175.70],[-50.05,-176.45],[-49.05,-176.45],[-47.55,-177.45],[-47.30,-177.45],[-46.55,-176.45],[-46.05,-176.70],[-45.55,-175.95],[-45.55,-175.20],[-45.30,-174.95],[-45.30,-174.20],[-44.80,-172.95],[-44.80,-172.20],[-45.05,-171.95],[-45.05,-169.20],[-45.30,-168.95],[-45.30,-168.20],[-45.05,-167.95],[-45.05,-165.20],[-45.30,-164.95],[-45.30,-164.20],[-45.80,-163.70],[-45.80,-162.70],[-46.55,-163.70],[-46.80,-163.45],[-46.80,-162.20],[-47.30,-161.70],[-47.30,-159.70],[-48.05,-159.20],[-48.05,-156.95],[-48.55,-156.70],[-48.80,-154.45],[-49.30,-154.20],[-49.30,-152.95],[-48.80,-151.70],[-48.30,-151.20],[-47.80,-151.20],[-47.05,-150.45],[-46.05,-151.20],[-46.05,-152.20],[-45.05,-152.70],[-45.05,-153.45],[-44.30,-154.20],[-44.30,-155.20],[-43.80,-155.20],[-43.55,-155.45],[-43.55,-156.45],[-43.05,-156.95],[-43.05,-157.70],[-42.80,-157.95],[-42.80,-159.95],[-42.55,-160.45],[-42.05,-160.70],[-42.05,-161.95],[-41.55,-161.95],[-41.05,-162.45],[-41.05,-163.45],[-40.55,-163.45],[-40.30,-163.70],[-40.30,-164.95],[-39.55,-165.70],[-39.30,-166.70],[-38.80,-166.70],[-38.30,-167.20],[-37.55,-166.70],[-37.30,-166.95],[-37.30,-167.70],[-36.80,-167.70],[-36.55,-167.95],[-36.55,-169.20],[-36.05,-169.70],[-36.05,-170.95],[-35.55,-170.95],[-35.30,-171.20],[-35.30,-172.70],[-35.55,-172.95],[-35.80,-174.45],[-35.55,-174.70],[-35.30,-177.45],[-34.80,-177.45],[-34.55,-177.70],[-34.55,-178.95],[-34.05,-179.45],[-33.55,-179.45],[-33.05,-178.70],[-32.55,-178.70],[-32.05,-178.20],[-32.05,-176.95],[-31.80,-176.70],[-31.55,-174.20],[-31.30,-173.95],[-31.05,-171.45],[-30.80,-171.20],[-31.30,-169.95],[-31.05,-169.70],[-31.30,-166.45],[-31.55,-166.20],[-31.55,-165.70],[-32.05,-165.20],[-32.05,-164.20],[-33.05,-163.95],[-33.55,-164.70],[-33.80,-164.45],[-33.80,-163.95],[-34.55,-163.45],[-34.55,-161.95],[-34.30,-161.70],[-34.55,-161.20],[-34.55,-159.70],[-35.05,-159.45],[-35.05,-158.70],[-35.80,-158.20],[-35.80,-157.20],[-36.80,-156.20],[-36.80,-155.70],[-37.80,-154.95],[-37.80,-153.70],[-38.30,-153.45],[-38.30,-152.70],[-39.30,-151.95],[-39.30,-151.45],[-39.80,-150.95],[-40.05,-149.95],[-40.55,-149.45],[-41.30,-149.45],[-41.55,-149.95],[-42.05,-149.45],[-42.05,-148.95],[-42.55,-148.70],[-42.55,-147.95],[-42.05,-146.70],[-42.05,-145.95],[-42.55,-145.45],[45.70,-143.45],[44.95,-144.20],[44.95,-144.70],[44.45,-144.95],[44.45,-145.45],[43.95,-145.95],[43.95,-146.95],[43.70,-147.20],[43.20,-147.20],[43.20,-147.95],[42.70,-148.45],[42.70,-149.45],[41.95,-150.45],[41.95,-151.20],[41.45,-151.45],[41.20,-153.20],[40.70,-153.70],[40.70,-154.45],[40.45,-154.70],[39.95,-154.70],[39.95,-155.70],[39.45,-156.20],[39.45,-156.70],[38.70,-157.20],[38.70,-157.95],[38.20,-158.45],[38.20,-158.95],[37.45,-159.70],[37.45,-160.70],[36.70,-161.20],[36.70,-161.70],[35.95,-162.20],[35.95,-163.20],[35.45,-163.45],[35.45,-164.20],[34.70,-164.70],[34.45,-166.45],[33.70,-167.20],[33.70,-167.95],[33.45,-168.20],[33.45,-169.20],[33.70,-169.45],[33.45,-171.95],[33.70,-172.20],[33.70,-173.20],[33.95,-173.45],[33.95,-174.95],[33.70,-175.20],[33.70,-175.70],[33.95,-175.95],[34.20,-178.20],[34.95,-178.95],[35.20,-179.70],[35.95,-179.70],[36.20,-179.95],[36.45,-180.70],[36.45,-179.45],[36.70,-179.20],[37.20,-179.20],[37.45,-177.20],[38.20,-176.70],[38.20,-175.70],[38.45,-175.20],[38.95,-174.95],[38.95,-173.95],[39.45,-172.70],[39.45,-171.70],[40.20,-170.70],[40.20,-169.95],[40.70,-169.70],[40.70,-168.70],[41.45,-168.20],[41.45,-167.20],[41.70,-166.95],[42.20,-166.95],[42.20,-165.95],[42.70,-165.45],[43.20,-165.45],[43.20,-164.70],[43.70,-164.20],[43.70,-163.20],[43.95,-162.95],[44.45,-162.95],[44.45,-162.20],[45.20,-161.45],[45.20,-159.70],[45.45,-159.45],[45.45,-158.45],[45.95,-157.95],[45.95,-156.95],[46.20,-156.70],[46.70,-156.70],[46.70,-155.70],[47.20,-155.45],[47.20,-154.70],[47.70,-154.45],[47.95,-153.45],[48.95,-152.70],[49.20,-151.70],[49.70,-151.45],[49.70,-150.70],[49.95,-150.45],[50.45,-150.95],[50.95,-150.70],[51.45,-151.20],[51.45,-151.70],[51.95,-152.70],[51.95,-155.70],[51.70,-155.95],[51.70,-157.20],[51.20,-157.45],[51.20,-158.20],[50.70,-158.70],[50.70,-161.20],[50.45,-161.45],[50.45,-162.45],[49.95,-162.70],[49.95,-163.20],[49.20,-163.95],[49.20,-164.70],[48.95,-164.95],[48.45,-164.20],[48.20,-164.45],[48.45,-164.70],[47.70,-165.70],[48.20,-167.45],[47.95,-167.70],[47.95,-168.70],[47.70,-168.95],[47.70,-171.70],[47.45,-171.95],[47.20,-173.70],[47.45,-173.95],[47.95,-175.95],[48.20,-176.20],[48.70,-176.20],[49.45,-177.20],[49.95,-176.95],[50.95,-176.95],[51.45,-176.45],[52.45,-176.45],[52.95,-176.20],[53.95,-177.20],[54.45,-177.20],[54.95,-177.70],[55.45,-179.45],[55.70,-179.70],[56.20,-179.45],[56.95,-180.45],[57.95,-179.70],[59.20,-179.45],[59.20,-178.20],[59.95,-177.45],[60.45,-177.45],[61.70,-176.20],[62.20,-176.20],[62.45,-175.95],[62.45,-174.70],[63.95,-173.45],[64.70,-173.20],[64.70,-171.70],[65.20,-171.45],[65.20,-170.45],[64.95,-170.20],[64.70,-168.95],[65.20,-168.45],[65.45,-165.45],[65.70,-165.20],[66.20,-165.20],[65.95,-163.95],[66.95,-162.95],[66.95,-162.20],[67.45,-161.95],[67.70,-158.95],[68.20,-158.70],[68.20,-157.95],[66.70,-154.95],[66.20,-154.95],[64.45,-153.45],[63.95,-153.70],[63.20,-152.95],[62.70,-152.95],[58.95,-149.45],[58.45,-149.70],[57.45,-148.20],[56.95,-148.45],[55.70,-147.20],[55.20,-147.45],[54.45,-146.70],[53.95,-146.70],[52.70,-145.70],[52.45,-145.95],[51.70,-145.20],[51.20,-145.45],[50.70,-144.95],[49.20,-144.70],[48.70,-144.20],[47.70,-144.45],[47.20,-143.95],[46.20,-143.95],[-23.05,-143.20],[-23.55,-143.20],[-23.80,-142.95],[-25.55,-144.45],[-25.55,-145.20],[-26.05,-145.70],[-26.05,-146.20],[-26.30,-146.45],[-26.30,-147.45],[-26.80,-147.95],[-27.05,-149.20],[-27.80,-149.95],[-27.80,-150.70],[-28.55,-151.70],[-28.55,-152.45],[-29.30,-153.20],[-29.30,-153.95],[-30.05,-154.95],[-30.05,-155.95],[-30.30,-156.20],[-30.30,-157.20],[-30.55,-157.70],[-29.80,-158.70],[-29.80,-159.45],[-29.55,-159.70],[-28.80,-158.70],[-28.30,-158.70],[-27.55,-157.95],[-27.55,-156.95],[-26.80,-156.20],[-26.55,-154.20],[-25.80,-153.20],[-25.80,-152.45],[-24.80,-151.20],[-24.55,-149.95],[-23.80,-148.95],[-23.80,-148.20],[-23.05,-147.45],[-22.55,-146.45],[-22.30,-143.95],[-22.80,-143.95],[-23.05,-143.70],[196.95,-139.70],[194.20,-137.95],[193.45,-137.95],[192.45,-137.45],[191.95,-137.95],[191.45,-137.95],[190.70,-137.45],[188.95,-137.20],[187.45,-136.45],[186.95,-136.95],[186.45,-136.95],[185.70,-136.45],[184.95,-136.45],[184.20,-135.95],[183.45,-136.45],[182.45,-135.95],[180.95,-136.20],[180.20,-135.70],[179.70,-135.70],[179.45,-136.20],[178.45,-135.70],[176.95,-135.95],[176.20,-135.45],[175.95,-135.95],[175.45,-135.95],[174.70,-135.45],[173.95,-135.95],[172.70,-135.45],[172.70,-135.70],[172.20,-135.95],[171.45,-135.45],[169.95,-135.70],[169.20,-135.20],[169.20,-135.70],[168.70,-136.20],[167.45,-135.70],[166.70,-136.45],[166.20,-136.45],[165.45,-135.95],[165.20,-136.45],[164.70,-136.45],[164.45,-136.20],[163.95,-136.45],[162.45,-136.20],[161.95,-136.95],[160.95,-136.45],[160.20,-137.20],[159.70,-137.20],[158.95,-136.70],[158.95,-137.45],[158.70,-137.70],[157.70,-137.45],[156.95,-138.20],[155.95,-137.70],[155.45,-138.45],[154.20,-138.20],[153.70,-138.95],[152.70,-138.70],[152.20,-139.45],[151.20,-138.95],[150.45,-139.70],[149.70,-139.20],[149.45,-139.20],[148.95,-139.95],[147.95,-139.70],[146.95,-140.70],[146.20,-140.45],[146.20,-141.20],[144.70,-142.70],[145.20,-143.45],[145.20,-143.95],[144.70,-144.45],[144.70,-144.95],[143.95,-145.45],[144.20,-146.70],[143.20,-147.45],[143.20,-147.95],[143.70,-148.45],[142.70,-149.20],[143.20,-149.70],[143.20,-150.20],[142.95,-150.45],[142.20,-150.45],[142.70,-150.95],[142.70,-151.20],[141.95,-151.70],[142.20,-152.70],[141.70,-152.95],[142.20,-153.70],[141.45,-154.20],[141.70,-155.20],[141.45,-155.45],[140.70,-155.45],[141.20,-156.20],[140.20,-156.70],[140.70,-157.70],[140.20,-157.95],[140.45,-158.70],[140.20,-158.95],[139.45,-158.95],[139.95,-159.70],[139.95,-160.20],[139.45,-160.45],[141.95,-163.45],[142.70,-163.70],[143.45,-164.45],[143.95,-164.45],[144.70,-165.20],[145.70,-165.20],[147.20,-166.45],[147.95,-166.45],[150.45,-168.45],[152.95,-169.70],[155.95,-171.95],[158.20,-174.20],[159.20,-174.70],[160.70,-176.20],[160.70,-176.45],[161.45,-176.95],[162.20,-176.95],[163.70,-177.95],[164.20,-177.70],[166.20,-177.70],[166.95,-177.20],[167.45,-177.20],[166.95,-176.20],[167.20,-175.70],[167.70,-175.70],[168.20,-175.20],[168.70,-175.20],[169.20,-174.70],[170.20,-174.45],[171.20,-173.45],[171.95,-173.20],[172.20,-172.95],[172.20,-172.45],[174.45,-170.20],[175.20,-170.45],[175.70,-170.95],[176.20,-170.95],[176.45,-170.70],[176.45,-168.95],[177.95,-167.45],[178.45,-167.95],[179.20,-168.20],[179.70,-166.95],[180.70,-165.95],[180.70,-165.45],[181.45,-164.45],[181.95,-164.45],[182.95,-164.95],[182.95,-164.45],[183.45,-163.95],[183.45,-163.45],[183.95,-162.95],[183.95,-162.45],[185.20,-161.20],[185.70,-161.20],[186.70,-161.70],[186.70,-160.45],[187.70,-159.45],[188.20,-158.20],[188.70,-157.70],[189.70,-158.20],[190.45,-158.20],[190.45,-156.95],[191.45,-155.95],[192.45,-153.70],[193.70,-152.45],[193.70,-151.70],[194.95,-150.45],[194.95,-149.95],[195.95,-148.95],[196.20,-147.95],[197.95,-146.20],[197.95,-145.70],[199.20,-144.20],[199.20,-142.95],[198.20,-141.95],[198.20,-140.95],[60.95,-131.20],[60.20,-131.70],[60.20,-132.20],[59.70,-132.45],[59.70,-134.20],[59.20,-134.45],[59.70,-135.45],[59.20,-136.20],[59.45,-138.45],[59.70,-138.70],[59.70,-140.20],[60.95,-142.70],[60.95,-143.20],[61.45,-143.45],[62.95,-145.20],[63.45,-144.95],[64.20,-145.70],[64.20,-144.95],[64.70,-144.20],[64.20,-143.45],[63.95,-140.45],[63.45,-139.70],[63.70,-138.70],[63.20,-137.95],[63.20,-135.70],[62.95,-135.45],[62.95,-134.20],[63.20,-133.70],[62.20,-131.95],[61.45,-131.95],[-82.55,-126.95],[-83.05,-127.45],[-83.55,-127.20],[-84.55,-128.45],[-84.55,-129.45],[-85.30,-130.45],[-85.05,-130.70],[-85.80,-131.95],[-85.55,-132.20],[-85.80,-132.45],[-85.80,-133.20],[-86.30,-133.95],[-86.05,-134.20],[-86.30,-134.45],[-86.30,-136.20],[-86.55,-136.45],[-86.55,-137.20],[-87.05,-137.95],[-87.05,-138.70],[-86.55,-138.95],[-86.55,-139.45],[-87.05,-139.95],[-87.05,-141.70],[-87.30,-141.95],[-87.05,-142.20],[-87.30,-142.70],[-86.80,-142.95],[-86.80,-143.95],[-86.55,-144.20],[-86.55,-145.70],[-86.80,-146.20],[-86.55,-146.70],[-86.05,-146.95],[-86.05,-147.45],[-85.55,-148.45],[-85.05,-148.70],[-85.30,-148.95],[-84.80,-149.20],[-84.55,-150.20],[-83.80,-150.70],[-84.05,-151.20],[-83.80,-150.95],[-83.30,-150.95],[-83.05,-151.20],[-83.30,-151.70],[-83.05,-151.45],[-82.80,-151.70],[-82.80,-152.20],[-82.30,-151.95],[-81.80,-152.70],[-81.80,-153.20],[-81.30,-152.95],[-81.05,-153.20],[-81.05,-153.70],[-80.55,-153.20],[-80.30,-153.45],[-80.30,-153.95],[-79.80,-153.70],[-79.55,-154.20],[-78.80,-154.20],[-78.55,-154.45],[-78.80,-154.95],[-78.55,-154.70],[-77.55,-154.70],[-77.30,-154.95],[-77.55,-155.20],[-76.55,-155.20],[-74.80,-153.70],[-74.30,-153.70],[-73.55,-152.70],[-73.55,-152.20],[-73.05,-151.45],[-73.05,-149.95],[-73.55,-149.70],[-73.55,-148.95],[-73.30,-148.70],[-73.55,-148.20],[-73.30,-147.70],[-73.55,-147.70],[-73.80,-147.20],[-74.05,-147.45],[-74.30,-147.20],[-74.30,-145.45],[-74.05,-145.20],[-74.55,-144.95],[-74.55,-144.45],[-74.80,-144.70],[-75.05,-144.45],[-74.80,-142.70],[-75.55,-142.20],[-75.55,-141.20],[-75.80,-141.20],[-76.05,-140.95],[-75.80,-140.70],[-76.30,-140.45],[-76.30,-139.95],[-76.05,-139.70],[-76.30,-139.70],[-76.55,-139.20],[-76.80,-139.45],[-77.30,-139.45],[-77.80,-140.20],[-78.30,-139.45],[-77.05,-137.20],[-77.30,-136.70],[-77.55,-136.95],[-77.80,-136.70],[-77.55,-136.20],[-78.05,-135.95],[-78.05,-135.20],[-78.55,-134.45],[-79.05,-134.20],[-78.80,-133.95],[-79.05,-133.45],[-78.80,-133.20],[-79.05,-133.45],[-79.30,-133.20],[-79.05,-132.70],[-79.30,-132.70],[-79.55,-132.20],[-80.30,-131.70],[-80.30,-131.20],[-80.80,-130.95],[-80.55,-130.70],[-80.80,-130.20],[-80.55,-129.95],[-81.05,-129.70],[-81.05,-129.20],[-81.55,-128.95],[-81.55,-128.20],[-82.05,-127.95],[-82.05,-127.45],[-82.30,-127.45],[83.70,-123.95],[83.95,-124.45],[83.70,-124.70],[83.45,-124.45],[83.70,-124.70],[83.20,-124.95],[83.20,-125.70],[84.20,-127.20],[83.70,-127.70],[82.95,-126.95],[82.20,-126.95],[81.70,-127.70],[81.95,-127.95],[81.45,-128.20],[80.95,-128.95],[80.70,-128.95],[80.70,-129.45],[80.95,-129.70],[80.20,-130.20],[80.20,-130.70],[79.45,-131.20],[79.70,-131.45],[79.70,-131.95],[79.20,-132.20],[78.95,-132.70],[78.95,-133.45],[79.20,-133.70],[78.20,-134.20],[78.45,-134.70],[77.95,-134.95],[77.95,-135.95],[77.45,-136.70],[77.20,-136.45],[77.20,-137.70],[76.45,-138.20],[76.45,-138.95],[75.95,-139.20],[76.20,-139.45],[76.20,-140.70],[76.95,-142.20],[77.70,-142.70],[78.20,-143.70],[80.20,-145.20],[81.45,-147.70],[82.45,-148.45],[83.45,-149.70],[83.70,-149.70],[83.70,-149.20],[84.20,-148.95],[84.45,-147.70],[84.70,-147.45],[85.20,-147.95],[85.20,-147.45],[85.45,-147.20],[85.95,-147.20],[86.95,-148.20],[86.95,-147.95],[87.45,-147.70],[87.70,-146.70],[88.20,-146.45],[87.70,-145.20],[88.20,-144.95],[88.20,-144.45],[87.95,-144.20],[87.95,-143.95],[88.45,-143.70],[88.45,-143.20],[88.20,-142.95],[88.70,-142.70],[88.45,-142.45],[88.95,-142.20],[88.70,-141.70],[88.95,-141.20],[88.70,-140.95],[88.70,-139.95],[88.45,-139.70],[88.95,-139.45],[88.95,-138.95],[88.70,-138.70],[88.70,-137.70],[88.20,-136.70],[88.45,-136.45],[88.20,-136.20],[88.20,-134.70],[87.70,-133.95],[87.95,-133.70],[87.95,-132.45],[87.45,-131.70],[87.45,-130.95],[86.95,-129.70],[87.20,-129.45],[86.70,-128.95],[86.70,-128.20],[86.45,-127.95],[86.70,-127.45],[86.20,-126.95],[86.20,-126.20],[85.20,-124.70],[84.45,-124.70],[-59.80,-119.95],[-60.30,-120.70],[-61.05,-120.95],[-62.05,-122.95],[-61.80,-123.20],[-61.80,-125.20],[-61.55,-125.45],[-61.80,-125.70],[-61.55,-125.95],[-61.80,-126.20],[-61.55,-126.45],[-62.05,-127.20],[-61.80,-127.70],[-61.80,-129.20],[-62.05,-129.45],[-62.05,-131.20],[-61.80,-131.70],[-62.30,-132.45],[-62.30,-133.20],[-62.05,-133.45],[-62.30,-133.70],[-62.05,-134.20],[-62.55,-134.95],[-62.30,-135.70],[-62.80,-136.45],[-62.55,-137.20],[-63.05,-138.20],[-62.80,-138.70],[-63.05,-138.95],[-62.80,-139.20],[-63.30,-139.95],[-63.55,-142.70],[-64.05,-143.70],[-63.80,-143.95],[-63.80,-144.45],[-64.55,-145.70],[-64.55,-147.20],[-65.05,-147.95],[-64.80,-148.95],[-65.30,-149.70],[-65.30,-150.20],[-64.80,-150.20],[-64.55,-150.45],[-64.55,-150.95],[-63.80,-150.20],[-63.30,-150.20],[-62.30,-149.20],[-61.80,-149.20],[-61.55,-148.70],[-59.05,-146.45],[-58.80,-145.70],[-57.80,-144.70],[-57.80,-144.20],[-56.80,-143.20],[-54.30,-136.95],[-54.30,-135.45],[-54.55,-134.95],[-54.05,-133.95],[-54.30,-133.70],[-54.30,-132.70],[-54.80,-132.45],[-55.05,-129.95],[-55.55,-129.95],[-55.80,-129.70],[-55.80,-128.45],[-56.05,-128.20],[-56.05,-127.70],[-56.55,-127.45],[-56.55,-126.45],[-57.05,-126.45],[-57.30,-126.20],[-57.05,-125.95],[-57.30,-125.70],[-57.30,-124.95],[-57.55,-124.95],[-57.80,-124.70],[-57.80,-124.20],[-58.30,-123.95],[-58.30,-122.70],[-58.55,-122.70],[-58.80,-122.45],[-58.80,-121.95],[-59.30,-121.70],[56.70,-107.70],[55.45,-107.95],[55.45,-108.20],[54.95,-108.45],[54.70,-108.95],[54.95,-109.20],[54.70,-109.95],[54.45,-110.20],[53.95,-109.70],[53.70,-110.70],[52.45,-111.95],[51.95,-111.70],[51.95,-112.20],[50.95,-112.95],[50.95,-113.70],[50.70,-113.95],[50.20,-113.95],[50.20,-114.45],[49.70,-114.70],[48.45,-116.45],[47.95,-116.70],[47.95,-117.20],[47.70,-117.45],[47.45,-117.20],[46.70,-118.20],[46.70,-118.70],[46.20,-119.20],[46.20,-119.70],[45.95,-119.95],[45.70,-119.70],[44.70,-120.20],[44.70,-120.70],[43.95,-121.45],[43.95,-121.95],[42.45,-123.95],[42.20,-125.45],[41.70,-125.70],[41.70,-126.20],[40.70,-127.45],[40.70,-128.20],[40.20,-128.70],[40.45,-131.20],[39.95,-131.45],[39.95,-131.95],[39.70,-132.20],[38.45,-131.95],[38.45,-132.70],[37.95,-132.95],[37.95,-133.45],[37.45,-133.95],[37.20,-135.20],[37.45,-135.45],[37.70,-137.20],[38.20,-138.20],[38.70,-137.95],[38.95,-138.45],[39.95,-138.45],[40.95,-137.95],[41.45,-138.45],[42.95,-138.45],[43.20,-138.20],[43.70,-138.70],[44.20,-138.45],[44.70,-138.95],[45.95,-138.70],[46.45,-139.20],[46.95,-138.95],[47.45,-139.70],[47.95,-139.45],[48.45,-139.95],[49.20,-139.45],[49.70,-139.95],[50.45,-139.95],[50.70,-140.45],[51.45,-140.20],[51.70,-140.70],[52.70,-140.45],[53.20,-139.20],[53.70,-139.70],[54.20,-139.45],[54.70,-139.95],[54.70,-138.95],[55.20,-138.70],[55.20,-134.95],[55.45,-134.70],[54.95,-133.45],[55.45,-133.20],[55.45,-132.45],[55.95,-131.95],[55.95,-130.45],[55.20,-129.20],[54.45,-129.20],[54.20,-128.95],[53.70,-129.95],[53.20,-129.95],[52.70,-130.45],[51.70,-130.20],[50.70,-128.70],[50.70,-127.95],[51.20,-127.70],[51.45,-125.95],[51.95,-125.70],[51.95,-125.20],[52.45,-124.70],[52.70,-123.20],[54.20,-120.95],[54.20,-119.95],[54.70,-119.70],[54.70,-118.20],[55.20,-117.95],[55.45,-116.45],[56.45,-115.70],[56.45,-113.95],[56.95,-113.20],[57.45,-112.95],[57.20,-112.20],[58.20,-111.45],[57.70,-110.45],[57.95,-109.20],[-5.80,-101.95],[-6.05,-102.45],[-6.55,-102.45],[-7.55,-102.95],[-7.55,-103.45],[-8.05,-104.45],[-8.05,-105.70],[-8.55,-106.20],[-8.55,-106.70],[-9.05,-107.45],[-9.30,-108.95],[-9.80,-109.20],[-9.80,-109.70],[-10.55,-110.45],[-10.80,-111.70],[-11.80,-112.95],[-11.80,-113.45],[-13.30,-115.95],[-13.30,-116.45],[-13.80,-116.95],[-13.80,-117.95],[-14.80,-119.45],[-15.05,-121.95],[-14.55,-122.20],[-14.55,-124.20],[-14.80,-124.45],[-14.80,-125.45],[-15.05,-125.70],[-15.55,-125.70],[-15.55,-126.45],[-15.80,-126.70],[-15.80,-128.70],[-15.55,-128.95],[-15.80,-129.45],[-15.80,-131.20],[-15.55,-131.45],[-15.55,-132.70],[-15.05,-133.45],[-15.05,-134.20],[-14.55,-134.45],[-13.80,-136.20],[-13.30,-136.45],[-12.80,-137.20],[-12.05,-137.70],[-11.55,-137.70],[-11.05,-136.95],[-10.55,-137.70],[-10.05,-137.70],[-9.80,-137.95],[-9.80,-139.20],[-9.30,-139.45],[-9.30,-139.95],[-8.80,-140.20],[-8.55,-140.70],[-7.55,-141.45],[-7.55,-141.70],[-6.80,-141.70],[-6.30,-142.45],[-5.30,-142.45],[-4.30,-143.70],[-2.30,-143.70],[-1.80,-142.95],[-1.30,-143.70],[-1.05,-143.70],[-0.55,-144.45],[-0.05,-144.45],[0.45,-145.20],[5.20,-145.20],[5.70,-144.45],[6.20,-144.45],[6.20,-143.95],[6.45,-143.70],[6.95,-143.70],[7.45,-142.95],[7.70,-142.95],[8.20,-143.70],[10.70,-143.70],[11.20,-142.95],[11.95,-142.95],[12.45,-142.20],[13.70,-142.20],[13.70,-141.95],[14.95,-140.95
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
