ibitlab/pub-shadow-lamp-pierrot/(list of files, cad)

Other CAD files:
versions/v002-low-outline/pierrot_lamp.scad
versions/v003-print-support/pierrot_lamp.scad
versions/v003-print-support/generated/pierrot_data.scad
